Forbes-Automotive/OpenHaldex-C6/README.md

<p align="center">
  <a href="https://forbes-automotive.com/?utm_source=github&utm_medium=readme&utm_campaign=openhaldex" target="_blank">
    <picture>
      <source media="(prefers-color-scheme: dark)" srcset="/Images/FA-logo-white.png">
      <source media="(prefers-color-scheme: light)" srcset="/Images/FA-logo.png">
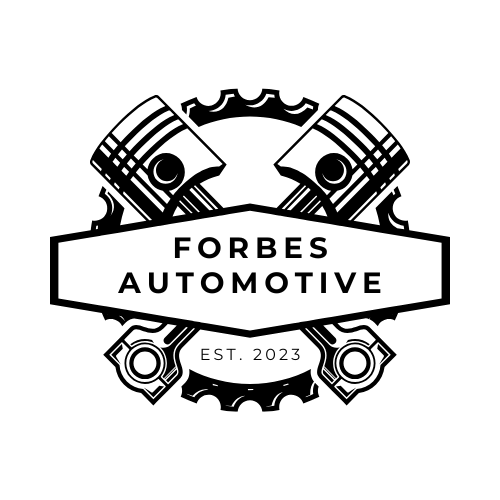
[picture p1: Images/FA-logo.png]
Forbes Automotive
      
    </picture>
  </a>
</p>

# OpenHaldex — ESP32‑C6 Haldex Controller

<p align="center">








</p>

OpenHaldex is an **open-source Haldex AWD controller** for Volkswagen and Audi Group vehicles using Haldex Generation 1, 2, 4 (PQ Chassis) and 5 (MQB) differentials, with GM, Ford and (new in V10) early **Volvo** and **SAAB** support. The full source and hardware files are published under the permissive **MIT License**, so anyone is free to use, modify, and redistribute them, and it incorporates MIT‑licensed upstream work — see [Licensing](#licensing).

Install is easy with the new harnesses for later PQ & MQB chassis:

**Lift seat -> Plug in -> Drive it**

**Performance doesn't need to be expensive or complicated!**

Starting from the codebase from A-Banging-Donk for Generation 1 differentials; OpenHaldexC6 has grown to adapt Generation 2, 4 and 5.  

The firmware runs on an **ESP32‑C6** and reads CAN bus messages from the vehicle, allowing the controller to modify or generate commands so the Haldex differential behaves exactly as you've configured.  

It can operate using OEM CAN signals or it is able to run in Standalone mode - which makes it perfect for conversions!

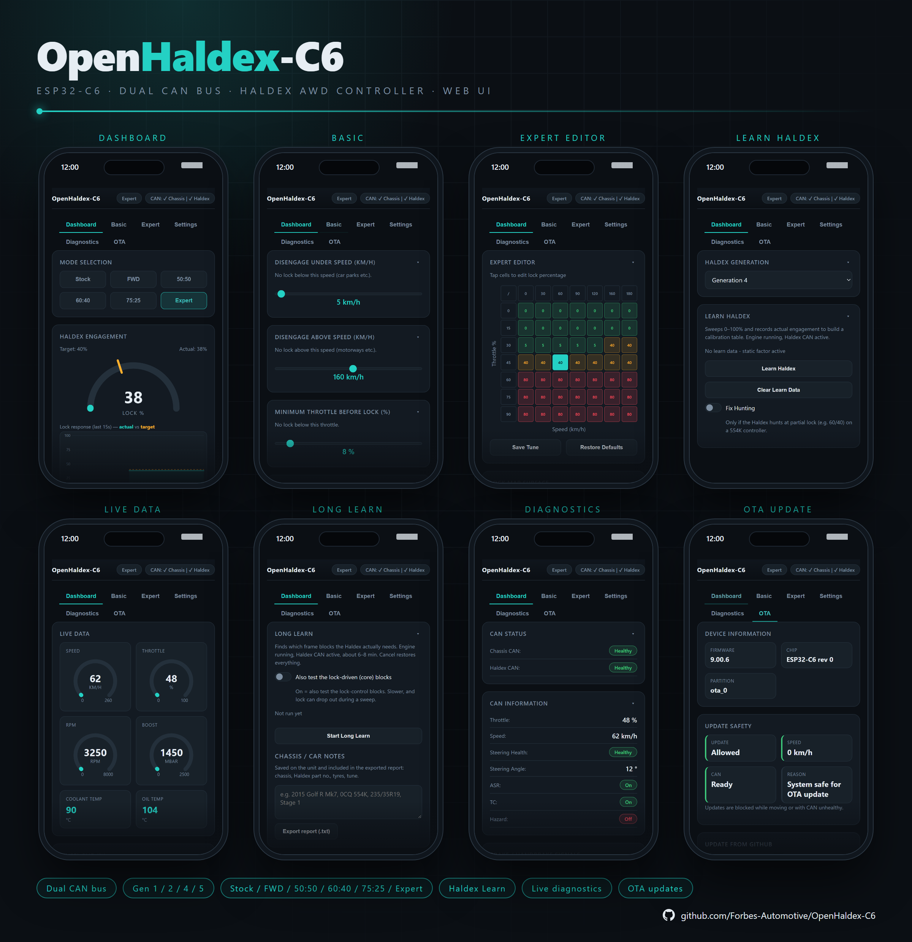
[picture p2: Images/openHaldexUI.png]
OpenHaldex-C6 Web UI — dashboard, Basic, Expert, Learn, live data, Long Learn, diagnostics and OTA


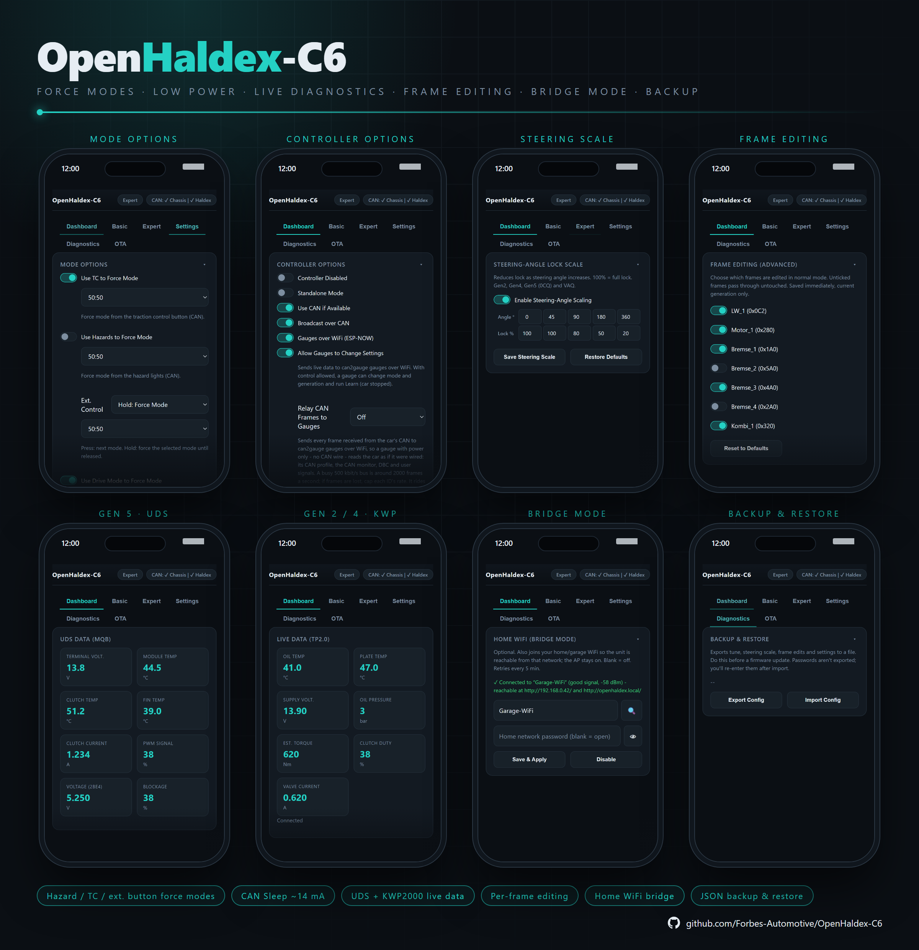
[picture p3: Images/openHaldexUI-2.png]
OpenHaldex-C6 Web UI — force modes, controller options, steering scale, frame editing, live diagnostics, bridge mode and backup


## Contents

- [Features](#features)
- [Purchase](#purchase)
- [Overview](#overview)
- [Hardware](#hardware)
- [Supported Platforms](#supported-platforms)
- [Chassis Signals (Non-VW Cars)](#chassis-signals-non-vw-cars)
- [Volvo & SAAB](#volvo--saab-early-support)
- [Modes](#modes)
- [Expert Mode](#expert-mode)
- [Installation](#installation)
- [Firmware Installation](#firmware-installation-esp-web-tools)
- [OTA Updates (Wi‑Fi)](#ota-updates-wi-fi)
- [Status Indicators](#status-indicators)
- [Low Power Mode](#low-power-mode)
- [Home WiFi (Bridge Mode)](#home-wifi-bridge-mode)
- [Backup & Restore](#backup--restore)
- [DashCAN App (Bluetooth)](#dashcan-app-bluetooth)
- [CAN Sniffing](#can-sniffing-savvycan--gvret)
- [Live Diagnostics](#live-diagnostics)
- [Fault Codes](#fault-codes)
- [Frame Editing](#frame-editing-addingremoving-can-signals)
- [PCB & Enclosure](#pcb--enclosure)
- [Acknowledgements](#acknowledgements)
- [Licensing](#licensing)
- [Disclaimer](#disclaimer)

## Features

- Two TWAI (CAN) interfaces for reading and bridging CAN traffic
- Built‑in Wi‑Fi for on‑device configuration and diagnostics
- Multiple preset modes plus customisable mode profiles
- Tune your Haldex system directly from your phone via Wi-Fi
- Configurable inputs features onboard and external mode switching options 
- Configurable outputs include two high-side drivers for handbrake and brake outputs (or PWM control for optional oil cooling!)
- SavvyCAN support via Wi‑Fi or Serial
- Wi‑Fi access point password protection, with long-press reset
- Force mode via CAN using hazard lights or TC button
- Force mode from the car's drive mode select on MQB (Comfort, Sport, Race, Individual ...), each profile set to any mode, with a **Drive Mode** card on Diagnostics (see [Drive Mode Select](#can--force-mode-drive-mode-select-mqb))
- Adjustable LED brightness
- Live Data on the dashboard: speed, throttle, RPM, boost, plus engine coolant and oil temperature on the PQ cars (Gen1 / Gen2 / Gen4 / 0AY, from the cluster's Kombi_2 frame), updating up to 10 times a second (**Live Data Refresh** under Display Options)
- Live diagnostics: UDS (Gen5) and KWP2000‑over‑TP2.0 (Gen2/Gen4) with measurement scaling confirmed against VCDS
- Read and clear the Haldex module's own fault codes from the Diagnostics page: UDS (Gen5), KWP2000 over TP2.0 (Gen2 / Gen4) and Volvo D2 (Volvo P2 / P3) (see [Fault Codes](#fault-codes))
- Selectable CAN frames — enable/disable CAN messages per Generation from the Web UI
- CAN frame relay to can2gauge gauges over WiFi (ESP-NOW): a gauge with power only, no CAN wire, reads the car as if it were wired (**Relay CAN Frames to Gauges** under Controller Options, off by default)
- Speed, throttle, RPM, brake and handbrake read from the car on Vauxhall / Opel Insignia, Ford Focus RS, Volvo P1 and Volvo P3 too, so Expert mode works on them (see [Chassis Signals](#chassis-signals-non-vw-cars))
- Volvo Gen4 (P3) proven on a real Haldex on the bench (V11.00.5): no fault codes, proportional lock, Standalone and OEM mode, mode buttons and Learn (see [Volvo P3](#volvo-gen4-p3--bench-proven-v11005))
- Early Volvo (P2 Gen2 / Gen3, P1 S40 / V50, Gen5 SPC) and SAAB 9-3 XWD standalone support, with the CAN bus switched to 250 kbit/s automatically for the pre-facelift P2 (see [Volvo & SAAB](#volvo--saab-early-support))
- Every generation checked against the Haldex units' own code (V11): the bytes that really set the lock, what the unit reports back, and its own fault bits, in OEM and Standalone
- The Haldex's own warnings (fault, limp, over-temperature, AWD lamp, temperature sensor, stored fault) on a red **Haldex Warning** card, plus Haldex Data tiles on the dashboard
- **Follow ABS** (on by default): opens the clutch while the ABS is braking, as the Haldex itself would
- Wireless (OTA) firmware and web‑UI updates over Wi‑Fi
- Bluetooth LE link to the DashCAN mobile app: live data, mode and controller on/off, driving settings and Haldex diagnostics from the phone (see [DashCAN App](#dashcan-app-bluetooth))
- Colour‑coded status indicators throughout the Web UI (green / orange / red — see [Status Indicators](#status-indicators))

OpenHaldex-C6

---

## Purchase

Assembled modules are available from Forbes Automotive if you do not wish to build one yourself:

➡ **[OpenHaldex C6 Controller – Forbes Automotive](https://forbes-automotive.com/products/openhaldex-controller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)**

---

## Overview

OpenHaldex-C6 sits between your vehicle and the OEM Haldex controller. It can operate as a passthrough (OEM behaviour), and modify messages to request different amounts of differential lock.  

This is the original source of Generation 2, 4 (including GM) and 5 logic - any forks or code copied from this project is NOT the work of Forbes Automotive and therefore we cannot support other work unless it is remains part of this project.

**Supported generations:** Gen1, Gen2, Gen3 (Volvo), Gen4 and Gen5.

> [!NOTE]
> The Volvo and SAAB generations are new in V10 and standalone only for now. See [Volvo & SAAB](#volvo--saab-early-support).

> [!WARNING]
> V11 changes the bytes that set the lock on Gen1, Gen2, Gen4, Gen5 0CQ and Gen5 0AY, so the saved learned table is cleared when you update. **Run Learn Haldex again after updating to V11.** Frame-editing masks still on the old defaults move to the new ones by themselves. 11.00.4 switches the frame edits V10 had on back on in OEM mode (Gen1, Gen2, Gen4, 0CQ and 0AY; a VAQ keeps its saved choice) and clears the learn table once more on those generations: run Learn again after updating to 11.00.4.

---

## Hardware

The PCB is based around an **ESP32‑C6 Mini** (with Wi‑Fi) and has superior protection against ESD and transient voltages.  It has a built-in fuse and uses quality automotive based components for a reliable system.

Two TWAI/CAN controllers are built into the PCB along with external IO control:

- External mode button
- On‑board RGB LED
- Brake / handbrake management (for Generation 1 systems)
  *Note: some brake/handbrake outputs may require a 10k pulldown resistor on certain platforms(!)

These two high‑side drivers for brake/handbrake could be repurposed for other functions like oil coolers!

> This platform replaces the earlier Teensy (OpenHaldex T4) design to provide wireless support and on‑device configuration.

## Supported Platforms

- Generation 1 - PQ 
- Generation 2 - PQ
- Generation 4 - PQ
- Generation 4 - GM
- Generation 4 - Ford (ongoing)
- Generation 5 - MQB (0CQ)
- Generation 5 - PQ (0AY)
- Generation 5 - MQB (VAQ)
- Generation 2 - Volvo P2, pre-facelift (early support)
- Generation 3 - Volvo P2, facelift (early support)
- Generation 3 - Volvo P1, S40 / V50 AWD (early support)
- Generation 4 - Volvo P3 (bench-proven on a real unit, Standalone + OEM)
- Generation 4 - SAAB 9-3 XWD (early support)
- Generation 5 - Volvo SPC 31380867 (early support)

### Chassis Signals (Non-VW Cars)

Expert mode, the speed / throttle limits and brake / handbrake follow need speed, throttle and brake from the car. From V10 these are read on:

| Generation | Speed | Throttle | RPM | Brake | Handbrake |
|---|---|---|---|---|---|
| Generation 4 - GM (Vauxhall / Opel) | Yes | Yes | Yes | Yes | Yes |
| Generation 4 - Ford | Yes | Yes | Yes | Yes | Yes |
| Generation 4 - Volvo (P3) | Yes | Yes (scale to confirm) | Yes | Yes | Not yet |
| Generation 4 - SAAB 9-3 XWD | Yes | Not yet | Yes | Not yet | Yes |
| Generation 2 - Volvo P2 (Pre-Facelift) | 2002 cars | 2002 cars | 2002 cars | 2002 cars | Not yet |
| Generation 3 - Volvo P2 (Facelift) | Not yet | Not yet | Not yet | Not yet | Not yet |
| Generation 3 - Volvo P1 (S40 / V50) | Yes | Yes | Yes | Yes | Yes |

The Insignia, Focus RS, 2002 Volvo P2 and Volvo P1 decodes are checked against real logs from those cars (the P1's speed scale still needs a check against the speedo). The SAAB 9-3 decode comes from a published decode of a real car. The Volvo P3 decode (V11.00.5) is read from the 29-bit frames the P3 Haldex really uses: engine rpm and the brake switch from `0x0080401E`, the pedal from `0x0062401E`, road speed from the rear wheels of `0x10004002` (1/64 km/h, cross-checked three ways), ABS braking (for **Follow ABS**) from the same frame, and the steering angle from `0x11600002` (shown on Diagnostics; its scale is an estimate, so it doesn't change the lock yet).

> [!NOTE]
> Volvo moves the P2's CAN IDs between model years, so the pre-facelift P2 decode only covers 2002 cars for now. Logs from other years (and from a facelift P2) are what's needed to add them.

## Volvo & SAAB (Early Support)

New in V10, with the Volvo SPC unit and the P2 facelift Haldex reply decode added in V11, and the Volvo P1 (S40 / V50) in V11.00.1. Pick the car under **Settings → Haldex Generation**:

<p align="center">
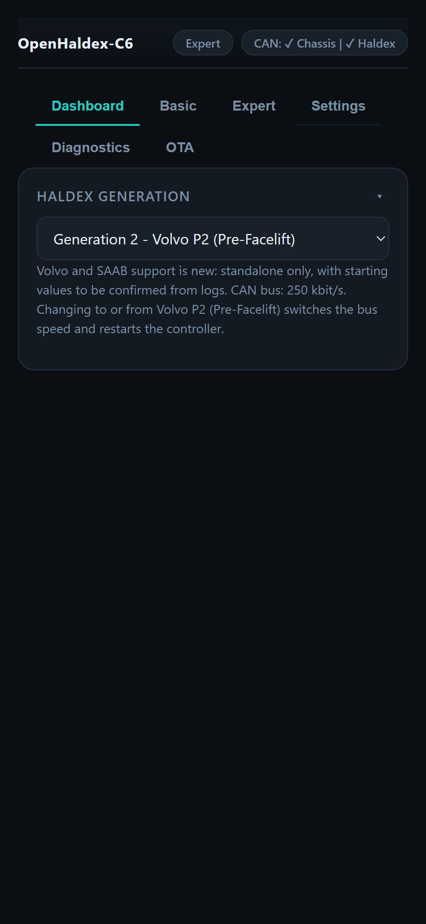
[picture p4: Images/ui-volvo-saab.png]
Settings — Haldex Generation set to Volvo P2 (Pre-Facelift), showing the 250 kbit/s CAN bus note
  
</p>

| Generation | Cars | CAN bus | Haldex reply |
|---|---|---|---|
| Generation 2 - Volvo P2 (Pre-Facelift) | S60, V70, XC70, XC90 up to the 2005 facelift | **250 kbit/s**, 29-bit IDs | `0x0120000A` |
| Generation 3 - Volvo P2 (Facelift) | S60, S60R, V70, XC70, XC90 from the facelift | 500 kbit/s, 29-bit IDs | `0x1020000A` |
| Generation 3 - Volvo P1 (S40 / V50) | S40 and V50 AWD (T5 / D5), 2004–2012 | 500 kbit/s, 29-bit IDs | `0x1960000A` |
| Generation 4 - Volvo (P3) | XC60, V70, XC70, S80 (P3) | 500 kbit/s, 29-bit IDs | `0x1020000A` |
| Generation 4 - SAAB 9-3 XWD | 9-3 XWD | 500 kbit/s | `0x210` |
| Generation 5 - Volvo (SPC 31380867) | Cars with the Volvo Gen5 SPC unit | 500 kbit/s, 11-bit IDs | `0x126` |

- **Standalone only, except the P3.** The controller sends the frames the Haldex needs, including Volvo's 100 ms network heartbeat and SAAB's rolling counters. It also puts your lock request into the bytes that carry it. In OEM (inline) mode, frames pass through untouched - apart from the Volvo P3, which has full OEM support (below).
- **The bus speed follows the generation.** Choosing Volvo P2 (Pre-Facelift), or moving away from it, saves the setting and restarts the controller a couple of seconds later, with both CAN buses at the new speed. Without 250 kbit/s a pre-facelift P2 Haldex never answers, so it shows no Haldex health at all.
- **Starting values, not finished decodes.** The frame list and lock bytes are a starting point. The meaning of most bytes still needs confirming on real cars, and the Haldex status is shown as raw 0–100 % until logs give its true scaling. SAAB also reports a Haldex temperature.
- **Decoded from the Haldex's own code (V11).** On the P2 facelift, the reply's byte 6 is the measured clutch value and byte 7 carries the fault / limp and missing-input bits, so the Haldex Warning card works there. The SPC unit's reply gives the clutch torque it's delivering and a fault status. The full-lock value of both still needs a bench check.
- **Volvo P1 (S40 / V50 AWD, V11.00.1).** Built from logs of a 2005 V50 T5 AWD. The P1 runs the same bus as the P2 facelift but uses none of its CAN IDs, so pick the P1 entry, not a P2 one.
  - Standalone sends every frame the car puts on its high-speed bus (22 of them), each one listed under Frame Editing. Untick a frame and the **car's own** frame with that ID goes through to the Haldex instead. Untick them all and the Haldex sees the real car; tick them back one at a time on a drive to find any frame it won't accept.
  - The logs show the P1 module follows engine torque almost one-for-one, goes to full lock on big front wheelspin, and never locks while stopped. The **Volvo P1 Standalone** card (Settings, shown for the P1) sets how your lock request is shown to it:
    - **Lock Source**: Engine torque (the default, which also raises the pedal), Wheel slip (front wheels faster than the rears), or both together.
    - **Road Speed** and **Gear**: the rpm sent is the road speed in that gear (1st to 3rd, ratios measured from the V50 logs), so rpm and speed always match a real gear.
    - **Torque at 100 %** and **Front Wheel Slip at 100 %**, with a Reset to Defaults button.
    - A live line shows the lock being asked for, what's being sent, and the module's engagement.
  - Switching DSTC off counts as the TC button, so **Use TC to Force Mode** (Mode Options) can force a mode while DSTC is off. This works in OEM mode, and in Standalone with the car connected.
  - The mode buttons, Expert and **Learn Haldex** drive it just like the other generations. Learn waits a little longer at each step on the P1, because its engagement trails the torque by up to 0.4 s.

<p align="center">
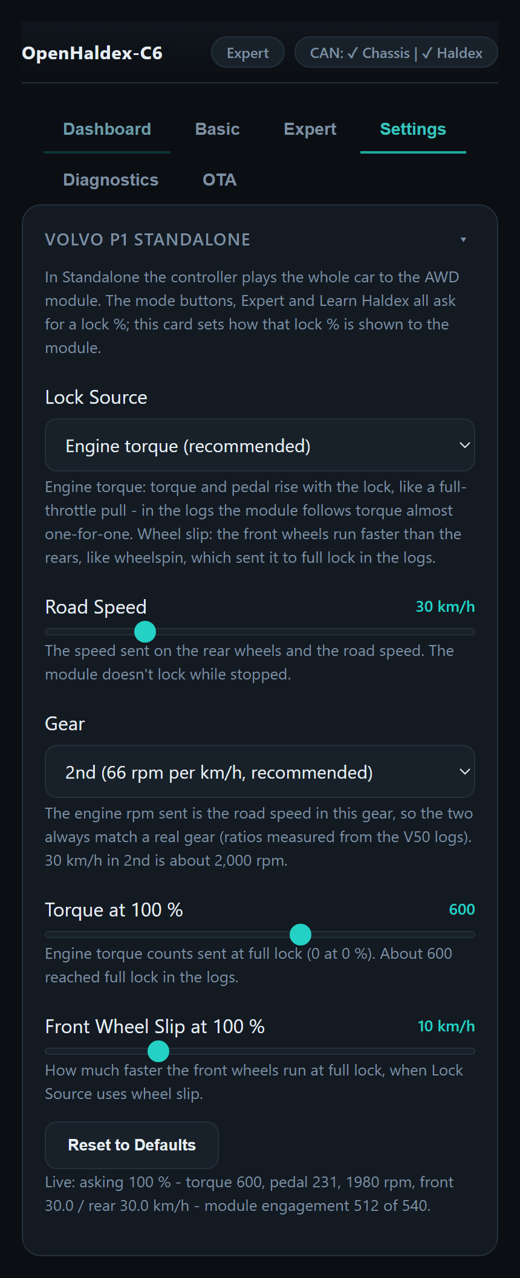
[picture p5: Images/ui-volvo-p1.png]
Settings — Volvo P1 Standalone card: Lock Source, Road Speed, Gear, Torque at 100 %, Front Wheel Slip at 100 % and the live line
  
</p>

*Settings → **Volvo P1 Standalone**: here asking for 100 %, sent as 600 torque and full pedal at a steady 30 km/h in 2nd (1980 rpm). The live line is a mock-up: on the car the module hasn't answered our lock request yet (see below).*
  - **Not working yet (first car test, 25 Oct 2026):** in Standalone the module stays awake but ignores the lock request. The frame bisect and the gear-matched rpm above are the tools for finding out why. Findings: `documents/VOLVO_P1_FINDINGS_2026-10-25.md`.
  - The Haldex's engagement (`0x1960000A`) is shown as 0–100 %, with full lock at the highest value seen in the logs.
  - OEM mode passes everything through untouched for now, so Stock and the engagement readout work. Editing the car's frames for 50:50, 60:40 and the other modes comes next; until then Learn needs Standalone on the P1.
  - The decode and the logs are in `documents/vehicle-logs/gen3/`.
- **How to help.** Log the car with [SavvyCAN](#can-sniffing-savvycan--gvret), and nudge individual bytes live with the serial lab `OVR <id> <byte> <value>` command (it takes 29-bit Volvo IDs). Logs from a car with the Haldex fitted are what turn these into decoded frames.

### Volvo Gen4 (P3) — bench-proven (V11.00.5)

Worked out on a real P3 Haldex on the bench (hardware `31219215 AA`, software `31219186 AE`) on 7 Nov 2026. Full notes: `documents/VOLVO_GEN4_BENCH_2026-11-07.md`; every CAN frame is decoded, with its source, in `include/OpenHaldexC6_canID.h`.

- **It speaks 29-bit, like the P2 facelift.** The P3 unit uses the same message set as the P2 facelift Haldex and replies on `0x1020000A`. The 11-bit frames earlier versions sent for generation 43 got no answer at all.
- **No fault codes, no limp.** The one frame that matters most is the CEM's configuration page (`0x10A2407C`, page `0x14`). Without it the unit stores fault `0x0015` about 32 s after power-up and goes into limp. The controller sends it once a second.
- **What moves the clutch.** Only three inputs, all measured on the bench:

  | Frame | What it is | Effect on lock |
  |---|---|---|
  | `0x0080401E` | Engine rpm (+ brake switch) | Under ~300 rpm the pump stays off: **0 %** |
  | `0x10004002` | The four wheel speeds (bytes 0-3 rear, 4-7 front) | All four at 0 = car stood still = full pull-away pre-lock: **100 %**. Fronts faster than rears = slip = **1-99 %** |
  | `0x0062401E` | Engine torque and pedal (+ brake switch) | Positive torque / pedal *reduces* the lock, so it is held at fixed values |

  The brake switch in `0x0080401E` cuts the lock to 0 while moving, so it is cleared while a lock is wanted (as on the VAG units); **Follow Brake** puts the real brake state back.
- **Standalone** sends only those three, the network heartbeat and the configuration page - the other seven frames of the P2 set made no fault and no lock change when switched off, cold start included.
- **OEM mode** passes every car frame through and edits only the three lock inputs, so the mode buttons (FWD / 50:50 / 60:40 / 75:25), Expert and **Learn Haldex** work just like on the VAG cars. Stock is untouched passthrough.
- **Reply.** Byte 6 of `0x1020000A` is the measured clutch pressure (0 open, `0xFF` full lock), shown as engagement. Byte 7 bit 0 is the fault / limp flag, shown on the Haldex Warning card.
- **Before Learn**, lock requests of 25 / 50 / 75 / 100 % give about 37 / 49 / 74 / 100 % - run **Learn Haldex** once to straighten the curve.
- **Fault codes** can be read and cleared from the Diagnostics page (Volvo D2, module `0x1A`) - see [Fault Codes](#fault-codes).
- **ABS:** the rear-left qualifier bits of `0x10004002` make the unit open its clutch (ABS / stability control braking). With **Follow ABS** on (the default) the car's flag reaches the Haldex in OEM mode; turn it off and the lock overrules the ABS.
- **Not done yet:** the DSTC off button (the Haldex doesn't use it, so it needs a car log with the button pressed), confirming which ABS value is ABS and which is DSTC, the steering-angle scale, and a car test.

---

## Modes

The controller provides several preset modes along with a fully customisable 'Expert' mode':

| Mode | Behaviour | LED Colour |
|-----|---|---|
| Stock | OEM behaviour | Red |
| FWD | Zero lock | Green | 
| 7525 | 25% lock | Cyan |
| 6040 | 40% lock | Magenta |
| 5050 | 100% lock | Blue |
| Expert | User‑defined lock | White |

<p align="center">
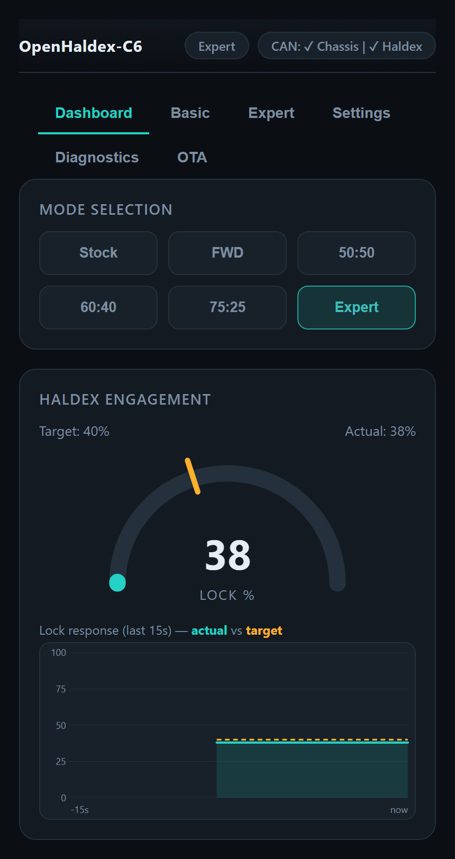
[picture p6: Images/ui-dashboard.png]
Dashboard — mode selection and Haldex engagement gauge
  
  &nbsp;&nbsp;
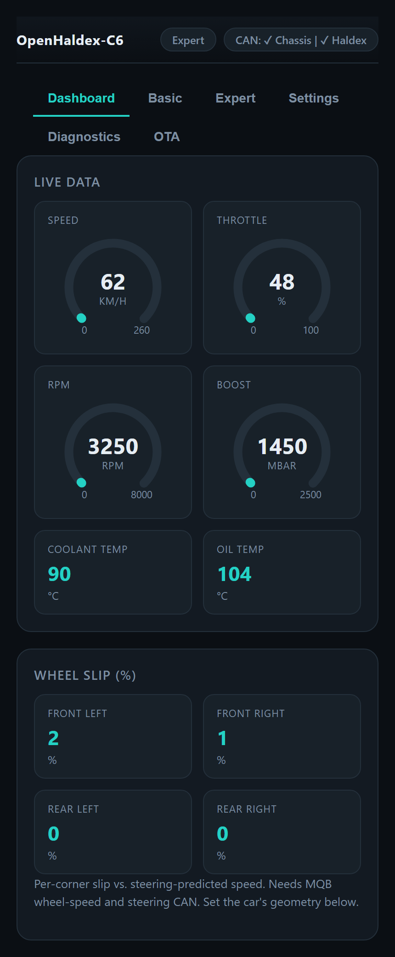
[picture p7: Images/ui-live-data.png]
Dashboard — live speed, throttle, RPM, boost, coolant and oil temperature, and per-wheel slip
  
</p>

*Dashboard: pick a mode, watch the engagement gauge follow the request (with the last 15 s of actual vs target underneath), and keep an eye on the live data and wheel slip further down the page.*

The **Live Data** card shows speed, throttle, RPM and boost, and on the PQ cars (Gen1, Gen2, Gen4 and 0AY) the engine **Coolant Temp** and **Oil Temp** read from the instrument cluster's Kombi_2 frame; cars that don't send it show `--`. It normally updates twice a second like the rest of the page. **Live Data Refresh** (Display Options, saved in the browser) speeds up just the Live Data tiles, the engagement gauge and the lock graph to 4, 5 or 10 times a second; step back down if the page gets sluggish on a busy phone.

The **Basic** tab holds the simple guards that apply to every mode — disengage below or above a speed, a minimum throttle before any lock is applied, and how quickly lock is released. They cut lock in **every** mode, force triggers included, so when one of them is holding lock at 0% the Haldex Engagement card says which one and what it's set to (e.g. *"Lock is being held at 0% because speed is below "Disengage Under Speed" (20 km/h)"*). Set that limit to 0 to turn the cut-off off:

<p align="center">
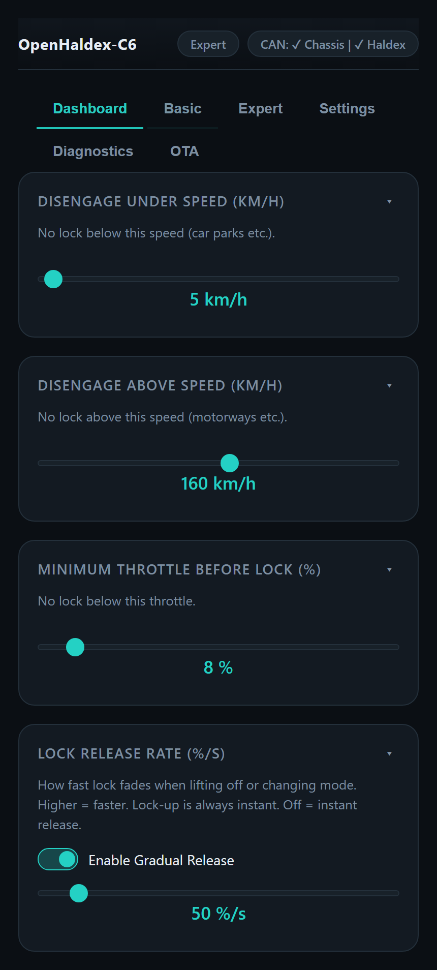
[picture p8: Images/ui-basic.png]
Basic tab — disengage speeds, minimum throttle and lock release rate
  
</p>

---

## Expert Mode

Expert mode allows lock targets to be configured based on **speed and throttle setpoints** using a table inside the Web UI. This is true **full control** over your Haldex system. No guesswork. You tune it and it'll do exactly what you want it to do, every time.  It requires OEM CAN messages to be present for throttle/speed inputs.

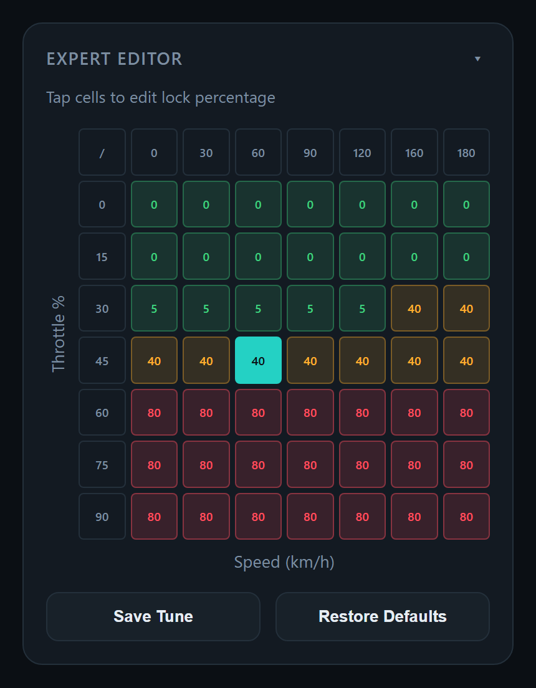
[picture p9: Images/expertmode.png]
ExpertMode


*Expert mode grid configuration interface within the OpenHaldex-C6 UI.*

The rest of the **Expert** tab draws the same table as a lock-map surface, and adds an optional **Steering-Angle Lock Scale** — a five-point curve that trims the commanded lock as steering-wheel angle increases (full lock straight ahead, FWD bias in tight turns). It applies to Gen2, Gen4 and Gen5 (0CQ/VAQ) and to every mode, not just Expert:

<p align="center">
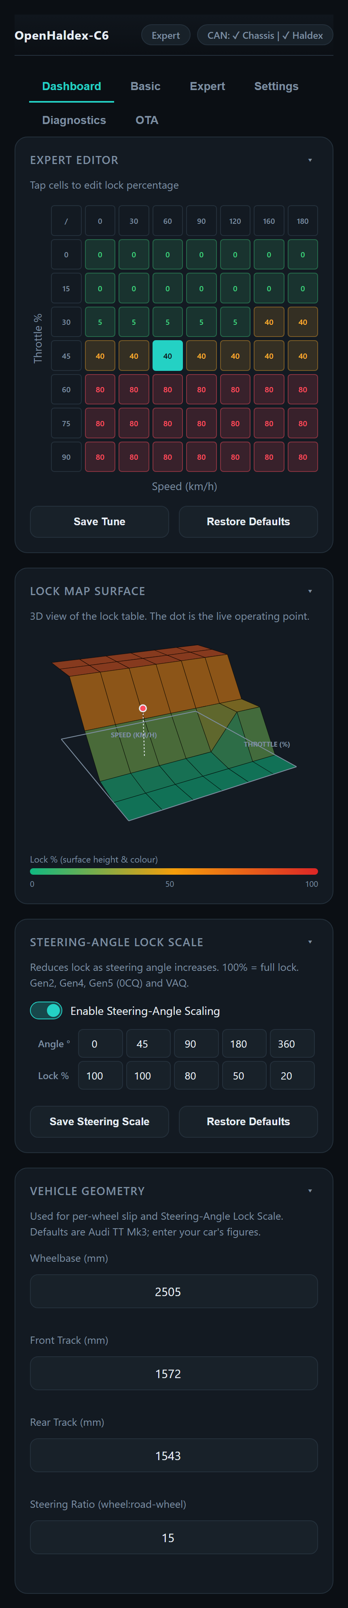
[picture p10: Images/ui-expert.png]
Expert tab — editor grid, lock map surface and steering-angle lock scale
  
  &nbsp;&nbsp;
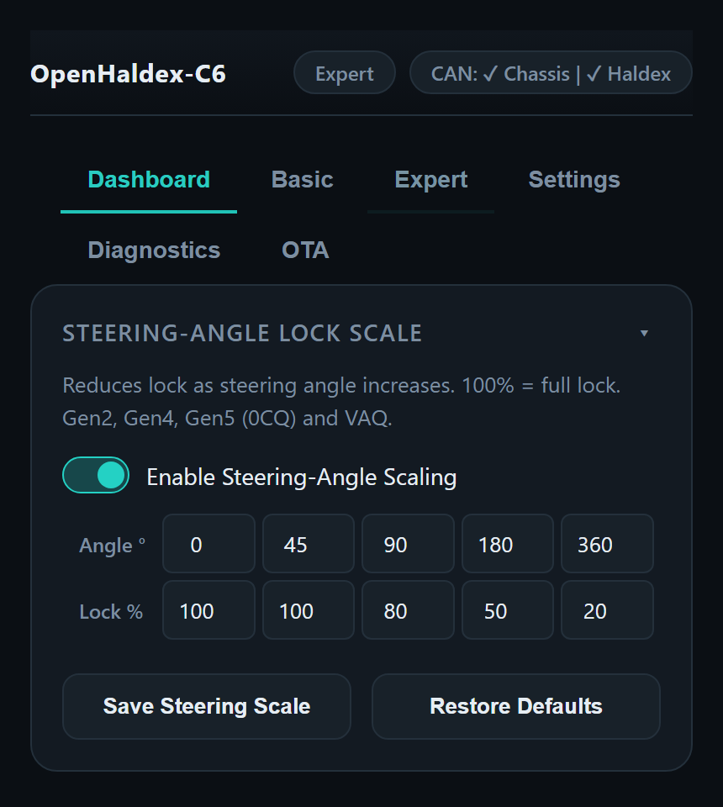
[picture p11: Images/ui-steering-scale.png]
Expert tab — steering-angle lock scale curve
  
</p>

---

## Haldex Learning

Allow the controller to learn *your* Haldex by replacing the original methodology of approximating a lock percentage by cycling through all of the available lock percentages.  

Use the 'Learn Haldex' in the Settings page and within one minute the controller will learn how to get EXACTLY the lock percentage you request.  No more approximations, just exact values.

<p align="center">
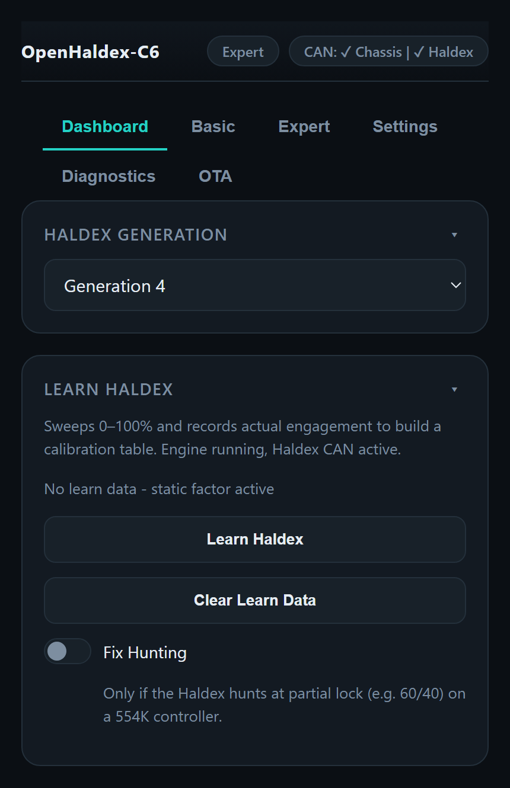
[picture p12: Images/ui-settings.png]
Settings — Haldex generation and the Learn Haldex card with Fix Hunting
  
</p>

*Settings: pick the Haldex generation, then run **Learn Haldex**. The card reports whether a learned table is active and carries the Gen5 **Fix Hunting** toggle described below.*

### Long Learn (which static blocks are needed)

The **lock-driven** blocks (the frames whose payload follows the lock target, e.g. Motor_11 / Motor_12 / ESP_14 / ESP_19 on Gen5) always have to be edited to have control, so they are always sent. Everything else is a **static** payload. **Long Learn** on the Settings page finds out which of those the Haldex actually needs:

1. **Reference** — every block for the generation is switched **on** (as standalone sends the bus) and a full 0–100% sweep is run on the unit's own settings.
2. **BPK Adjust** *(Gen5 only, only if that sweep hunts — not smooth — or falls short)* — **Fix Hunting** (BPK packing) is switched on and kept only if a full sweep is genuinely better; if it is still short on level, the torque ceiling (**Lock Calibration**, `bpkCeilingNm`) is walked up to the lowest value that reaches 100%. Whatever wins is **kept** when the run completes.
3. **Prove it** — the all-on sweep on the settled settings must be smooth (it is re-swept if BPK moved the ceiling). Then two quick reads at **20 / 40 / 70 / 100%** with everything on: their average is the reference, and their spread is the **noise** floor every block is judged against (minimum 4%). If all-on is not a smooth 100%, or the two reads differ by more than 10% at any point, the run stops — there is nothing trustworthy to compare blocks with.
4. **Testing blocks** — each static block is switched off **on its own** (everything else on), read at the same four points (releasing to 0% before each one, since a held lock doesn't re-evaluate cleanly), and switched back on. A change beyond the noise floor at any point = **needed** (or **affects (higher without)** if it read higher — still kept on). No change = **no effect**. Spreading the points over the ramp means a block that only matters at part lock isn't missed on a clean 100%. Tick *Also test the lock-driven (core) blocks* to test those too.
5. **Confirmation** — every "no effect" block off together, full sweep compared CF-by-CF with the step-3 curve. If it still matches, that becomes the final set and stored learn table. If not (a step between the two test points, or two frames covering for each other) every block is left on, the reference table is stored and the run is flagged as an **interaction**.

On the bench (standalone) "off" means the frame is not sent at all; in the car (normal mode) it means the car's own frame passes through untouched. A full sweep takes about a minute and a four-point block read 6–12 seconds, so a Gen5 run is roughly 6–8 minutes. The tracker shows the phase, sweep count, the block under test, Fix Hunting / torque ceiling, the reference score with its noise and threshold, and the live Sent/Returned bars; each tested block shows its worst deviation. Cancelling, or a failed proof, restores the blocks, floor, torque ceiling, Fix Hunting toggle and learn table that were in place before the run.

Below the tracker, a **Chassis / car notes** box (saved on the unit) and **Export report (.txt)** produce a plain-text record of the car, calibration values, the recommended block set (as a checklist plus the raw mask), the full sweep log and the stored learn table — handy for sharing a known-good layout for a given chassis.

<p align="center">
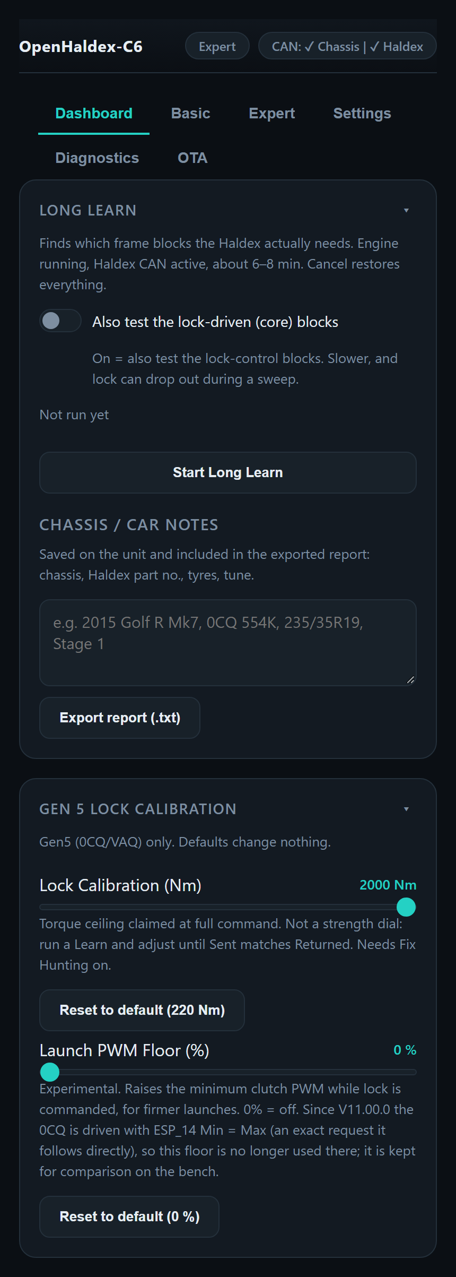
[picture p13: Images/ui-long-learn.png]
Settings — Long Learn card with notes and report export, and the Gen 5 Lock Calibration card
  
</p>

*Settings: the Long Learn card (with the core-blocks option, notes and report export) and, beneath it, the **Gen 5 Lock Calibration** card — the torque ceiling (`Lock Calibration`) and `Launch PWM Floor` that Long Learn adjusts.*

### Gen5 'Fix Hunting'

Certain Generation 5 controllers — specifically those running the **554K** variant — use a different torque model to calculate the lock request. On these units, the standard learning process will not produce accurate results. Use the **Fix Hunt** option in the Settings page to ensure the correct torque model is used.  

---

## Changing Modes

Modes can be changed using multiple interfaces:

**On‑board button**

Press the `Mode` button to cycle through modes.

**Wi‑Fi**

Use the Web UI at:

```
192.168.1.1 or openhaldex.local
```

**CAN**

See [CAN Broadcast / Change Mode](#can-broadcast--change-mode) for the required **Broadcast over CAN** setting, CAN IDs and mode byte.

**CAN — Force Mode (Hazards / TC Button)**

Two optional force mode triggers are available via. CAN signals already present on the bus:

- **Hazard lights** — activating the hazard switch will trigger a force mode command
- **TC button** — pressing the traction control button can also trigger force mode

Both are optional and can be enabled in the Settings page. They allow mode changes from OEM controls without any additional wiring.

<p align="center">
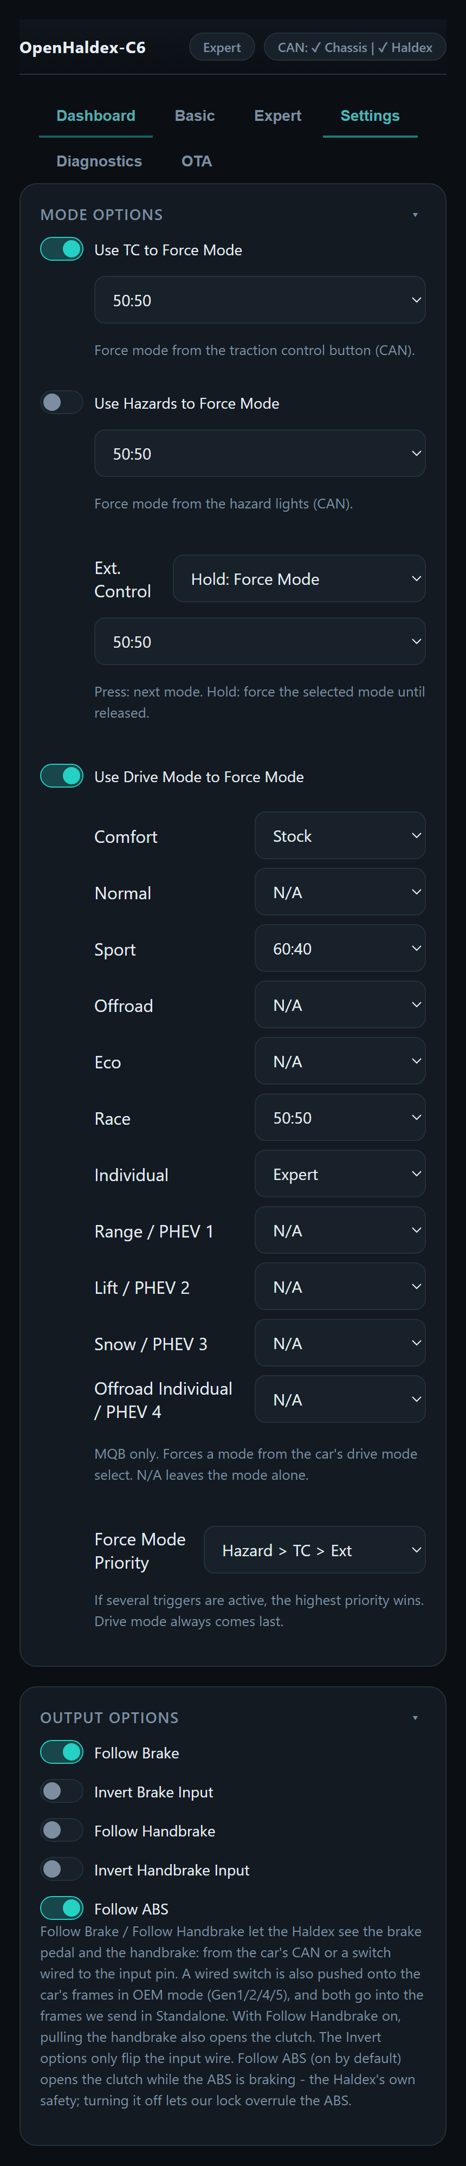
[picture p14: Images/ui-mode-options.png]
Settings — Mode Options (TC / hazard / external button / drive mode force modes and their priority) and Output Options (brake and handbrake follow)
  
</p>

*Settings → **Mode Options**: each force-mode trigger has its own target mode, the external button can either advance or hold-to-force, the drive mode select has a mode per profile, and a priority order settles what happens when several triggers are active at once. **Output Options** underneath sets whether the Haldex follows the brake and handbrake (from the car's CAN or a switch wired to the input pin), and **Follow ABS** (on by default) opens the clutch while the ABS is braking. With Follow Handbrake on, pulling the handbrake also opens the clutch. The Invert options only flip the input wire, never the car's own CAN bit.*

### CAN — Force Mode (Drive Mode Select, MQB)

On MQB cars (Gen5 `0CQ`, Gen5 `0AY` on MQB and the VAQ), the car's own drive mode select can force a mode. Turn on **Use Drive Mode to Force Mode** under Settings → **Mode Options** and pick a mode for each drive profile. **N/A** leaves the mode alone. The defaults are:

| Drive profile | OpenHaldex mode |
|---|---|
| Comfort | Stock |
| Sport | 60:40 |
| Race | 50:50 |
| Individual | Expert |
| Normal, Offroad, Eco, Snow and the rest | N/A |

How it works:

- The gateway sends the selected profile once a second in **Charisma_07** (`0x3E8`, byte 1 bits 0–3). If a car doesn't send that frame on the Haldex's bus, the engine's requested mode in **Charisma_01** (`0x385`, byte 2) is used instead. That one can't tell Individual apart: it shows the engine setting chosen inside Individual.
- The TC button, hazards and external button still win over it. If no Charisma frame arrives for 3 seconds, the drive mode stops forcing anything.
- The header banner shows a drive mode force the same way as the others, e.g. `Expert (Sport>60:40)`.
- **Diagnostics → Drive Mode** shows the profile the car is in, which frame it was read from, the mode the car's gateway asks the Haldex and VAQ for, what the Haldex reports back (mode and status), and what is being forced.

Profile and mode numbers come from the MQB K-matrix and the [jilleb/MQB-FPA](https://github.com/jilleb/MQB-FPA) research into the gateway's drive profile data. Our own MQB logs read Individual (7) from Charisma_07.

> [!NOTE]
> Reading the drive profile has been checked against our own MQB logs. Forcing modes from it has not been driven on a car yet.

<p align="center">
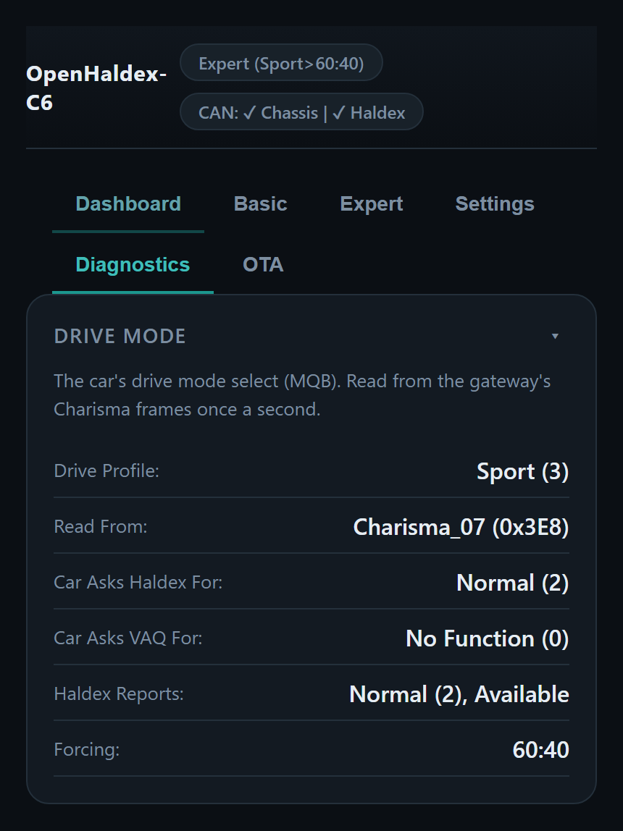
[picture p15: Images/ui-drive-mode.png]
Diagnostics — Drive Mode card: drive profile Sport read from Charisma_07, the car asking the Haldex for Normal, the Haldex reporting Normal / Available, forcing 60:40
  
</p>

*Diagnostics → **Drive Mode**: the car is in Sport (read from Charisma_07), its gateway asks the Haldex for Normal, the Haldex reports Normal / Available, and Sport is forcing 60:40.*

---

## CAN Broadcast / Change Mode

The same **Broadcast over CAN** setting enables both:

- External mode-change commands received by the controller on `0x6A0`
- OpenHaldex state broadcast from the controller on `0x6B0`

> [!NOTE]
> Enabling these features will broadcast NEW CAN IDs the system might already look for(!).  Caution should be exercised when using this feature(!). 

### Change Mode Request

**Broadcast over CAN must be enabled** in Settings, otherwise the controller will ignore the mode-change frame.

Send a standard 11-bit CAN frame to `0x6A0`. Put the required mode value in **Byte 0 / data[0]**. If sending an 8-byte frame, set unused bytes to `0x00`.

| CAN ID | Byte | Value | Mode |
|----|----|----|----|
| `0x6A0` | `0` / `data[0]` | `0x01` | Stock |
| `0x6A0` | `0` / `data[0]` | `0x02` | FWD |
| `0x6A0` | `0` / `data[0]` | `0x03` | 50:50 |
| `0x6A0` | `0` / `data[0]` | `0x04` | 60:40 |
| `0x6A0` | `0` / `data[0]` | `0x05` | 75:25 |
| `0x6A0` | `0` / `data[0]` | `0x06` | Expert |

### Broadcasted State

Default CAN ID:

```
0x6B0
```
The module broadcasts its current state on the CAN bus.  This can be used by aftermarket ECUs or FIS displays to show current status

```
data[0] = reserved 
data[1] = standalone flags (bitmask for Gen1/Gen2/Gen4/Gen5)
data[2] = processed haldex engagement (requested by firmware)
data[3] = lock target percent (actual lock, returned by differential)
data[4] = vehicle speed (kmh)
data[5] = mode_override_flag (legacy)
data[6] = current_mode_number (0...5)
data[7] = driver's pedal value (percentage: 0...100%)
```

---

## Wi‑Fi Setup

1. Connect to the access point **OpenHaldex‑C6** (open by default).
2. Open a browser and navigate to

```
192.168.1.1 or openhaldex.local
```

3. Access the Web UI

### Connecting from a phone

**Use your phone's Wi‑Fi settings — not its Personal Hotspot / hotspot feature.** The controller is the access point: it broadcasts its own Wi‑Fi network (**OpenHaldex‑C6** by default), the same way a home router does. Your phone just joins that network like any other:

1. Phone **Settings → Wi‑Fi** → select **OpenHaldex‑C6** and connect (open network by default, no password).
2. Browse to `192.168.1.1` or `openhaldex.local`.

Do **not** turn on your phone's own Hotspot/Personal Hotspot for this — that shares *your* phone's data with other devices, which is the opposite of what's needed here and won't let the phone reach the controller.

> [!NOTE]
> The controller has no internet access and doesn't need any. Your phone will show *"Wi‑Fi has no internet access"* while connected — that's expected; dismiss it. If the phone keeps dropping the network (some Android versions do this to a Wi‑Fi with no internet), tap the warning and choose **"Stay connected"**. 

If you get stuck mid-way (e.g. the phone auto‑connects to OpenHaldex‑C6 in the background and you didn't mean to), just forget the network or reconnect — the controller keeps running normally whether or not anything is connected to it.

From the **Diagnostics** page you can:

- **Change the WiFi Name (SSID)** — set any 1–32 character printable name (e.g. `MyHaldex`, `MK7-R`). The AP restarts immediately on save.
- **Set / change the WiFi Password** — WPA2, minimum 8 characters. Leave blank for an open network.

If you are locked out or forget your password, **long-pressing the `Mode` button** will clear the WiFi password and restore the open AP. The SSID is preserved (use **Reset to Default** in the UI if you want to revert the name to `OpenHaldex-C6`).

<p align="center">
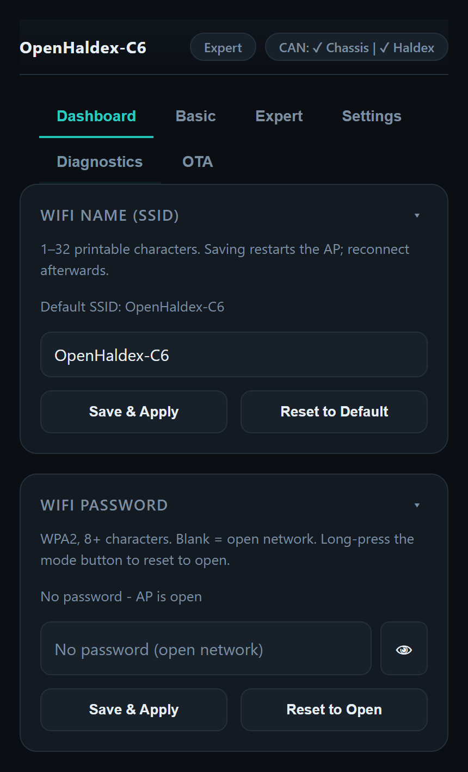
[picture p16: Images/ui-wifi.png]
Diagnostics — WiFi Name (SSID) and WiFi Password cards
  
</p>

*Diagnostics: rename the access point and set or clear its WPA2 password.*

<p align="center">
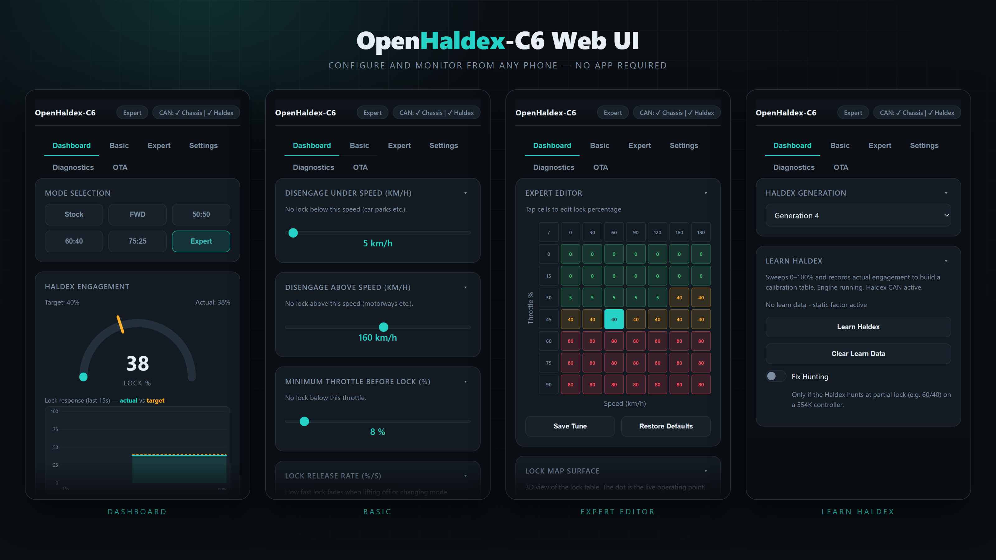
[picture p17: Images/UIDemo.png]
OpenHaldex C6 Web UI
  
</p>

If the Wi‑Fi interface becomes unresponsive:

- Long‑press the `Mode` button to clear the WiFi password and restart the AP to an open state.

> The Web UI is built on Forbes Automotive's shared dark theme (the same look used across the Can2Cluster, SpeedPulser, SpeedPulserPro, can2rpm, MQB Steering Wheel Controller and AirLift Controller firmware), so the interface and status conventions stay consistent across the whole product line. Current firmware version: **11.00.5** (beta: Volvo Gen4 P3 rewritten from a real unit on the bench - Standalone and OEM mode, no fault codes, proportional lock - plus Read / Clear Fault Codes on the Diagnostics page for the UDS, KWP2000 / TP2.0 and Volvo D2 generations; 11.00.4: coolant and oil temperature on the Live Data card, faster Live Data refresh, OEM-mode lock back to V10 behaviour on Gen1, Gen2, Gen4, 0CQ and 0AY, OTA from 11.00.2 and older fixed), shown in the UI footer and at `/ota/info`.

---

## Low Power Mode

OpenHaldex C6 is designed to live on a **permanent +12 V** feed without flattening your battery. With Low Power Mode configured correctly the controller draws approximately:

| State | Current |
|---|---|
| Sleeping (car off, WiFi off, CAN quiet) | **~14 mA** |
| Awake (CAN activity detected *or* WiFi client connected) | **~50 mA** |

There are three layers of power saving. Each layer builds on the previous one and all are configured from the **Settings** page.

---

### Layer 1 — Idle AP Shutdown *(on with CAN Sleep, which is on by default)*

After **5 minutes** with no WiFi clients and the bus below the wake threshold, the controller shuts down the WiFi AP, Bluetooth and the LED. Turning **CAN Sleep** off keeps them up permanently.

When the frame rate rises above the threshold again (car unlocked or started), WiFi comes back on its own.

---

### Layer 2 — CAN Sleep *(optional)*

Enable the **CAN Sleep** toggle in Settings. When active:

- The ESP32-C6 CPU enters **light sleep** whenever FreeRTOS is idle, cutting CPU power consumption significantly.
- The TWAI (CAN) peripheral powers down during sleep but **preserves its registers and receive queue** across cycles, so no messages are lost on wake-up.
- The CAN transceiver chips remain powered and continue listening on the bus, so the first incoming frame wakes the controller instantly.

Light sleep and the CPU clock floor are set at boot, so toggling CAN Sleep takes full effect after a restart.

This mode gives the majority of power savings for most installs and is the recommended starting point.

---

### Layer 3 — CAN Sleep (Aggressive) *(optional, builds on Layer 2)*

Enable **CAN Sleep (Aggressive)** in Settings — everything from Layer 2 remains active, plus:

- **The CAN transceiver chips are completely shut down** (standby pin asserted). This eliminates the ~10 mA standby draw per transceiver.
- The CPU minimum clock drops to **10 MHz**.
- WiFi AP transmit power is trimmed to reduce active-client current.
- Wake is **interrupt-driven**: a GPIO ISR on each CAN_RX line fires on the first bus edge and re-enables the transceivers within microseconds. 

Use Aggressive mode when the car sits unused for days at a time and you want the absolute lowest standby current (~14 mA).

---

### How to set it up

Every car idles its CAN bus at a different rate, so the wake threshold has to sit just above your car's parked rate.

**Gen5: automatic**

Selecting a Gen5 generation asks *Enable CAN sleep and set it up automatically?* (and asks again whenever you switch back to Gen5). Say yes, then just use the car. The next time it is left with no phone connected, the controller:

1. switches on CAN Sleep and CAN Sleep (Aggressive),
2. waits until the car is parked: speed 0, engine off and ignition off (`ZAS_Kl_15` in Klemmen_Status_01, `0x3C0`),
3. averages the chassis frame rate for **15 minutes**, restarting if a phone connects, the ignition comes on or the car moves,
4. sets **LP Wake Threshold** to that average **+ 300 fps** and saves it.

It runs once. Sleep stays off until it has finished, so the controller never sleeps on a wrong threshold. The Controller Options card shows *armed* or the measured average.

**Manual (any generation)**

**Step 1 — Measure your Sleeping CAN rate**

1. Park and lock the car. Wait 15 minutes or until the Chassis bus goes fully quiet.
2. Stay connected to the OpenHaldex WiFi AP — the controller will remain awake while a client is connected.
3. Open the Web UI → **Settings** and watch the **Chassis fps** and **Haldex fps** counters.
4. Note the highest reading you see while the car is asleep. Some cars go fully quiet; others keep a gateway heartbeat of several hundred fps.

**Step 2 — Set the wake threshold**

5. Set the **LP Wake Threshold (fps)** slider a few hundred above the parked reading, e.g. parked at 800 fps → **1100** (the default).

**Step 3 — Enable Sleep and Disconnect**

6. Enable **CAN Sleep** (and optionally **CAN Sleep (Aggressive)**) in Settings.
7. **Disconnect from the WiFi AP** (close the browser / forget the network).

The controller will now sleep, drawing ~14 mA, and **wake automatically whenever the CAN frame rate rises above the threshold** — i.e. when you unlock or start the car.  The LED, CAN chips and CPU are all off/reduced.

<p align="center">
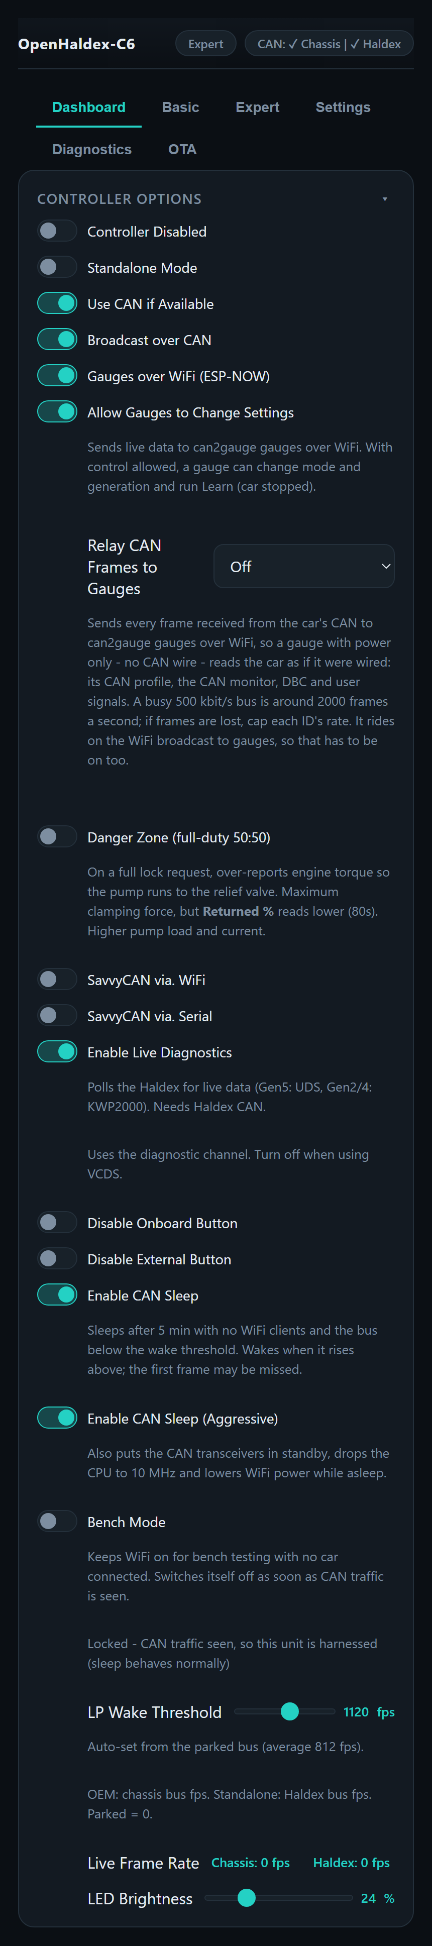
[picture p18: Images/ui-controller-options.png]
Settings — Controller Options card: CAN Sleep, CAN Sleep (Aggressive), Bench Mode, LP Wake Threshold with the live Chassis / Haldex frame rate, plus Broadcast over CAN, SavvyCAN and Live Diagnostics toggles
  
</p>

*Settings → **Controller Options**: the two CAN Sleep toggles, Bench Mode, the **LP Wake Threshold** slider (here set by the Gen5 auto-setup) and the live **Chassis / Haldex fps** readout, alongside Broadcast over CAN, the SavvyCAN outputs, Live Diagnostics and LED brightness.*

> [!NOTE]
> **Standalone mode:** with no chassis bus, the Haldex ECU itself sleeps fully, so the slider is ignored: the module wakes at a fixed 50 fps of Haldex-bus traffic.

> [!NOTE]
> **Switched-ignition installs:** if the module is already powered off with the ignition, Low Power Mode saves little and is optional.  

### Bench Mode

The board can't tell the difference between *harnessed to a car that's asleep* and *no harness at all* — both look like zero CAN traffic — so on the bench, with CAN Sleep on, the WiFi drops after five minutes mid-session. **Bench Mode** (Settings, under CAN Sleep) holds the WiFi up regardless.

It's safe to leave on by accident: the moment either bus shows real traffic in a power cycle, Bench Mode stops applying and normal sleep resumes, so it can't weaken the parked-car battery protection once the unit is actually installed. The web UI also greys the toggle out while CAN is detected, so it can't be switched on while harnessed to a live car in the first place.

---

## Home WiFi (Bridge Mode)

Optionally the controller can **also** join a home or garage WiFi network as a client (`WIFI_AP_STA`), so it's reachable at `openhaldex.local` — or its LAN address, shown on the card — from a phone or laptop that's already on that network, without switching WiFi to **OpenHaldex‑C6**. The controller's own access point keeps running either way; leave the field blank and nothing changes.

Set it up on the **Diagnostics** tab under **Home WiFi (Bridge Mode)** (the same card is repeated on the **OTA** tab, because this is also how the phone gets internet for [Check for updates](#doing-it-from-the-ota-page)): pick the network from the scan (or type a hidden one), enter its password, **Save & Apply**. The card then shows connection state and signal strength.

<p align="center">
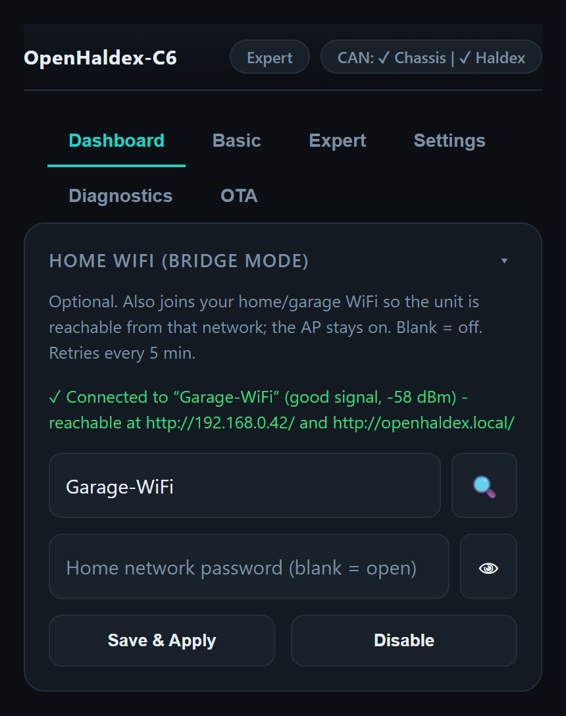
[picture p19: Images/ui-bridge-mode.png]
Diagnostics — Home WiFi (Bridge Mode) card, connected to a home network and showing its LAN address
  
</p>

Two things worth knowing:

- The ESP32‑C6 has **one radio** shared between its AP and the client side. A scan or a connection attempt pulls it off the AP's channel for a second or two. The controller therefore only looks for the home network for **20 s after starting**, then **once every 5 minutes** — so a saved home network can't keep interrupting the AP while the car is away from home.
- Bridge mode mostly doesn't change [Low Power Mode](#low-power-mode): with no CAN traffic and nobody using the controller, it still sleeps after five minutes (and drops off the home network). A browser that has the UI open through the router *does* count as "somebody" — it holds WiFi up the same way a phone joined to the AP does, so an update over the bridge can't be cut off. On the bench with nothing open, use Bench Mode.

Endpoints: `GET/POST /api/wifi/sta` `{ssid, password}` (empty `ssid` disables) · `POST /api/wifi/sta/reset` · `GET /api/wifi/scan` (asynchronous — poll until `scanning` is false).

---

## Backup & Restore

A firmware + filesystem reflash can wipe the settings stored on the device, and nobody wants to re-type an Expert grid. **Diagnostics → Backup & Restore** exports the Expert tune, steering-angle lock scale, per-generation frame edits, every setting and the WiFi names to a JSON file, and imports them back in one go.

WiFi passwords are **write-only** on the device and are never written to the file; after an import you're prompted once for any that were set.

<p align="center">
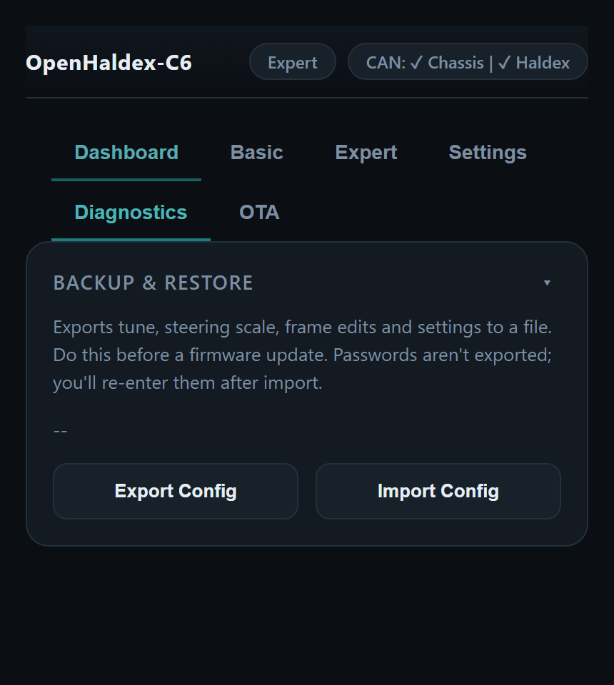
[picture p20: Images/ui-backup-restore.png]
Diagnostics — Backup & Restore card with Export Config and Import Config
  
</p>

The same file format works from a computer with [`tools/openhaldex_config.py`](tools/openhaldex_config.py):

```
python tools/openhaldex_config.py export backup.json
python tools/openhaldex_config.py import backup.json
python tools/openhaldex_config.py import backup.json --tune-only
```

Contributed in [PR #39](https://github.com/Forbes-Automotive/OpenHaldex-C6/pull/39) by louij2, along with Bench Mode and bridge mode.

---

## DashCAN App (Bluetooth)

The controller also talks **Bluetooth LE** to the **DashCAN** mobile app, so the basics are on the phone without joining the **OpenHaldex‑C6** WiFi — and the app can stay connected to a DashCAN interface at the same time. The web UI remains the place for everything else (Expert maps, learning, generation setup, frame editing, OTA).

**From the app:**

- **Live** — mode buttons, controller on/off, lock target / actual, speed, throttle, rpm, boost, steering angle, CAN health and Haldex warnings (temperature protection, coupling open, speed limit).
- **Settings** — the settings you change per situation: force modes (TC off / hazard lights / external button → mode), release lock on brake / handbrake, no‑lock speed and throttle window, steering‑angle lock scaling, gradual lock release and its rate, live diagnostics, LED brightness. Changes made on the web UI show up in the app and the other way round.
- **Haldex diagnostics** — clutch / oil / module temperatures, supply voltage, clutch current and duty (and oil pressure / estimated torque on Gen4), from the same [Live Diagnostics](#live-diagnostics) pollers. Needs *Live diagnostics* switched on.
- **Gauges** — `AWD Lock`, `AWD Lock Target`, `Steering` and the Haldex temperatures can be placed on the app's dashboards and in drive recordings.

**Connecting.** With Bluetooth enabled (default), the app finds the controller as `OpenHaldex‑XXXX` and connects to the first one in range by itself; it can also be picked on the app's Bluetooth screen. Live data needs no pairing. The first change from a phone pairs it once:

- the **first phone** pairs without a code (the phone at most asks you to confirm);
- after that, **every new phone needs the 6‑digit pairing code**. It is shown in the app on an already paired phone and on the web UI (**Diagnostics → Bluetooth**).

**On the controller:** **Diagnostics → Bluetooth (DashCAN App)** has the enable switch, a *phone connected* indicator, the pairing code and **Forget Paired Phones** — this removes every paired phone, makes a new code, and lets the next phone pair without one again (also forget the device in the phone's Bluetooth settings). Bluetooth follows the WiFi into [Low Power Mode](#low-power-mode): it switches off when the car is parked and comes back with it.

<p align="center">
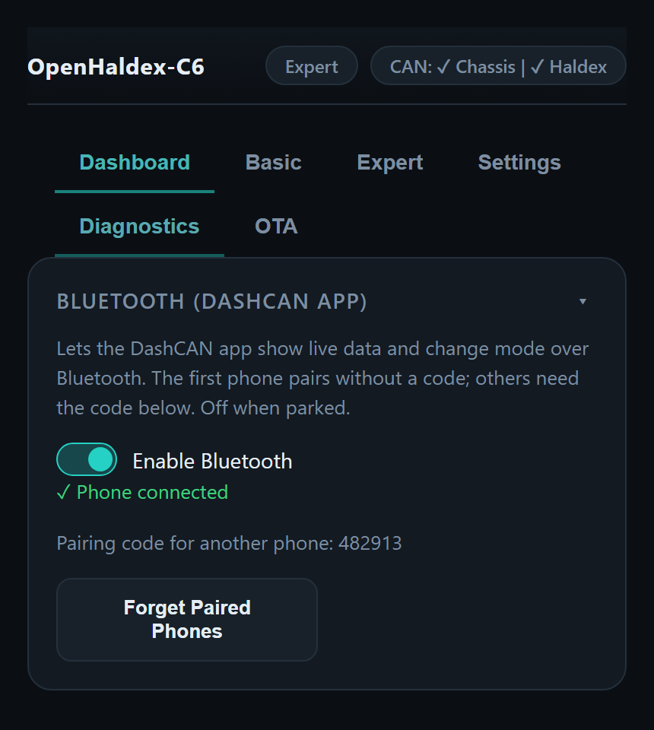
[picture p21: Images/ui-bluetooth.png]
Diagnostics — Bluetooth (DashCAN App) card: Enable Bluetooth on, phone connected, pairing code for another phone, Forget Paired Phones
  
</p>

*Diagnostics → **Bluetooth (DashCAN App)** with a phone connected: the pairing code shown is the one a second phone needs.*

> [!NOTE]
> Until the first phone has paired — on a new controller, or right after Forget Paired Phones — anyone within Bluetooth range could be that first phone. Pair yours straight away; if a phone you don't know got there first, use Forget Paired Phones. Firmware updates are never done over Bluetooth.

The protocol is documented in [`documents/MOBILE_APP_OPENHALDEX.md`](documents/MOBILE_APP_OPENHALDEX.md), so other apps can use it too. Endpoints: `POST /api/ble/forget`; `bleEnabled`, `blePasskey`, `bleCodeRequired` in `/api/settings`; `bleConnected`, `bleCodeRequired` in `/api/dashboard`.

---

## Installation

>[!TIP]
> ### Optional Plug & Play Harness (Recommended)
>
> Recommended for quick installation (and removal) — typically **<10 minutes** on Generation 1 Controllers.
> The latest harnesses for Generation 5 are even simpler and you'll be experiencing your Haldex controller in less than 30 seconds:

- Lift the rear seat
- Split the factory 6-pin Haldex connector
- Install your new harness & OpenHaldexC6 Controller
- Drive it (you could put the seat back down too, if you want!)

> For Generation 1 Controllers:

- Remove original connector and install the long end of the harness onto the differential.
- Route the long end along with the original connector back into the boot floor via. the OEM grommet
- Install and secure the OpenHaldexC6 Controller to the new harness, pairing it with the original plug

For full step‑by‑step instructions see the **[OpenHaldex Installation Guide](https://openhaldex.com/docs/OpenHaldex_Installation_Guide.pdf)**.

▶ **Installation demo (YouTube Short):** https://youtube.com/shorts/iUkNh9NbyKY?si=IhgqLIi0WM8wXqe9

▶ **Installation demo (YouTube Short):** https://youtu.be/Wu-u-Dz1444

> [!WARNING]
> ### Manual Wiring (No Harness)
>
> Modules sold without a harness include connector pins for manual wiring. This is a little harder and more involved than using the optional harness, but following the installation guide above it can still be completed easily. Give us a shout if you need a hand.

Gen1:
- Chassis Connector: `1J0‑973‑714`
- Haldex Conneector: `1J0‑973‑814`

Gen4>:
- Haldex Connector — `VW 1J0‑973‑713`
- Vehicle Connector — `VW 1J0‑973‑813`

Build this as a **Y-branch** harness between the two VW 8 or 6-pin connectors, with a long tail to the MX plug.

Routing summary:

- **Permanent power (Term30) and ground must also be branched to the OpenHaldex controller**:
  - Term30 -> MX Pin 1
  - Ground -> MX Pin 2
  
- Chassis CAN is taken from the Vehicle side and sent to the controller:
  - Vehicle Pin 5 -> MX Pin 3 (Chassis CAN Low)
  - Vehicle Pin 6 -> MX Pin 4 (Chassis CAN High)

- Returned CAN from the controller then goes to the Haldex side:
  - MX Pin 5 -> Haldex Pin 5 (Haldex CAN Low)
  - MX Pin 6 -> Haldex Pin 6 (Haldex CAN High)

Generation 1 > 4:
- Vehicle Connector — `VW 1J0‑973‑714`:

| Pin | Signal | Notes |
|----|---|---|
| 1 | Term15 | Pass-through: Vehicle → Haldex |
| 2 | Ground | Pass-through: Vehicle → Haldex and branch to MX Pin 2 |
| 3 | Brake Light | Pass-through: Vehicle → Haldex |
| 4 | Handbrake | Pass-through: Vehicle → Haldex |
| 5 | K-Line | Pass-through: Vehicle → Haldex |
| 6 | N/A | Not Used |
| 7 | Chassis Low | To MX Pin 3 (chassis side) |
| 8 | Chassis High | To MX Pin 4 (chassis side) |

- Haldex Connector — `VW 1J0‑973‑814`:

| Pin | Signal | Notes |
|----|---|---|
| 1 | Term15 | Pass-through: Vehicle → Haldex |
| 2 | Ground | Pass-through: Vehicle → Haldex and branch to MX Pin 2 |
| 3 | Brake Light | Pass-through: Vehicle → Haldex |
| 4 | Handbrake | Pass-through: Vehicle → Haldex |
| 5 | K-Line | Pass-through: Vehicle → Haldex |
| 6 | N/A | Not Used |
| 7 | Chassis Low | To MX Pin 5 (Haldex side) |
| 8 | Chassis High | To MX Pin 6 (Haldex side) |

Generation 5:
- Vehicle Connector — `VW 1J0‑973‑813`:

| Pin | Signal | Notes |
|----|---|---|
| 1 | Term15 | Pass-through: Vehicle → Haldex |
| 2 | Ground | Pass-through: Vehicle → Haldex and branch to MX Pin 2 |
| 3 | Term30 | Pass-through: Vehicle → Haldex and branch to MX Pin 1 |
| 4 | N/A | Not used |
| 5 | Chassis Low | To MX Pin 3 (chassis side) |
| 6 | Chassis High | To MX Pin 4 (chassis side) |

- Haldex Connector — `VW 1J0‑973‑713`:

| Pin | Signal | Notes |
|----|---|---|
| 1 | Term15 | Pass-through: Vehicle → Haldex |
| 2 | Ground/MALT | Pass-through from Vehicle side |
| 3 | Term30 | Pass-through from Vehicle side |
| 4 | N/A | Not used |
| 5 | Haldex Low | From MX Pin 5 (Haldex side) |
| 6 | Haldex High | From MX Pin 6 (Haldex side) |

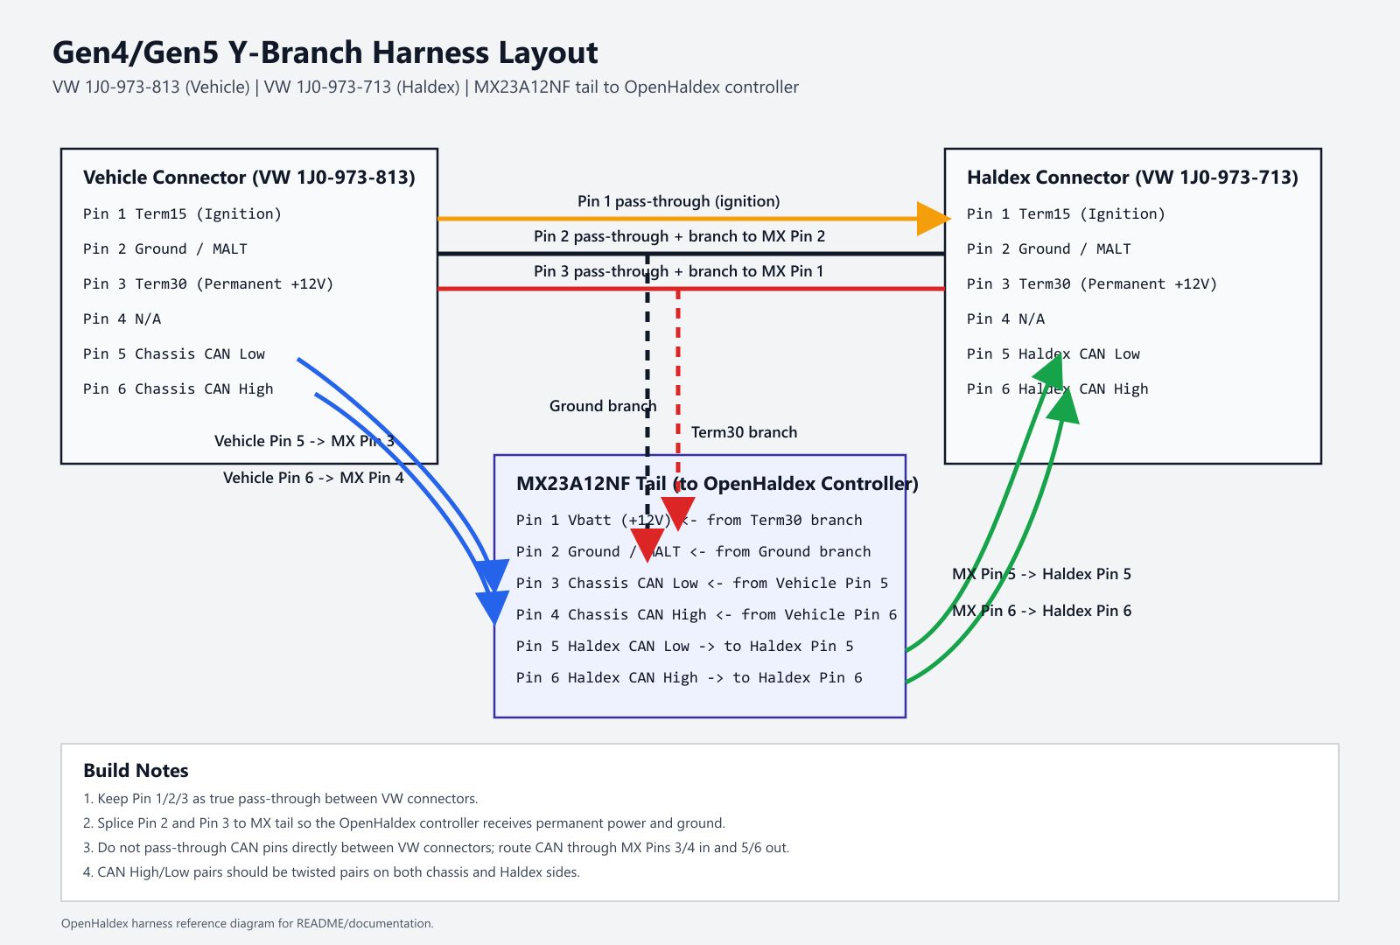
[picture p22: Images/Gen4_Gen5_Y_Branch_Harness.png]
Gen4/Gen5 Y-Branch Harness Diagram


### MX23A12NF Connector Pinout

| Pin | Signal | Notes |
|----|---|---|
| 1 | Vbatt | +12 V |
| 2 | Ground/MALT | Ground |
| 3 | Chassis CAN Low | To chassis/ECU side |
| 4 | Chassis CAN High | To chassis/ECU side |
| 5 | Haldex CAN Low | To Haldex differential |
| 6 | Haldex CAN High | To Haldex differential |
| 7 | Switch Mode External | +12 V to activate |
| 8 | Brake Switch In | +12 V input |
| 9 | Brake Switch Out | Gen1 / 2 differentials only |
|10 | Handbrake Switch In | +12 V input |
|11 | Handbrake Switch Out | Gen1 differentials only |

---

## Firmware Installation (ESP Web Tools)

Firmware can be installed directly from your browser using **ESP Web-Tools**.  
This is the recommended method for most users.

1. Connect the OpenHaldex-C6 controller to your computer using a **data-capable USB-C cable**.
2. Open the firmware installer page: **[Module Software Updater](https://forbes-automotive.com/pages/module-software-updater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)**
3. Click **Connect** and select the OpenHaldex serial port.
4. Click **Install** and follow the prompts.
5. Wait for the firmware to flash and the device to reboot.

> [!NOTE]
> Some USB-C cables are **power-only** and will not work for flashing.  
> If the device does not appear, try a different cable or USB port.

---

## OTA Updates (Wi‑Fi)

Once a controller is already running firmware **8.00.0 or later**, it can also be updated wirelessly over its own Wi‑Fi AP instead of by USB. This is a **two‑step process**, because the filesystem (web UI) and the firmware (application code) live on separate flash partitions and are updated independently:

1. **Step 1 — Filesystem update** (`POST /ota/update/fs`, uploads `littlefs.bin`)  
   Updates `index.html`, `app.js`, `style.css` and other web assets. From 11.00.3 most of these are stored gzipped in `littlefs.bin` (packed at build time by `tools/gzip_webui.py`), so the image is smaller and the pages load faster; the browser unpacks them, nothing changes on screen. From 11.00.4, `index.html` and `app.js` stay uncompressed so that units still on 11.00.2 or older (which look for those exact files) accept the update. The device does **not** reboot after this step — it's meant to be followed immediately by Step 2.
2. **Step 2 — Firmware update** (`POST /ota/update`, uploads `firmware.bin`)  
   Updates the application itself. The device reboots automatically once the upload finishes.

Both endpoints accept an optional `?sha256=<hex>` query parameter; when present the device hashes the upload as it arrives and refuses to activate an image that doesn't match. They need no password, but are **safety‑gated**:

- On the **bench** (no CAN detected), updates are allowed at any time.
- In the **vehicle** (CAN detected), an update is only allowed when the vehicle is stationary, both CAN buses are healthy, the controller is disabled or forced to Stock, and no Haldex temperature‑protection fault is active. `GET /ota/check` reports live pass/fail plus the reason if blocked.

After a firmware update the new image boots in a **pending‑verify** state (ESP‑IDF's rollback mechanism). It is only marked valid — cancelling the automatic rollback — once the web UI has been reached on the new image, or after 60 s of uptime; a build that crash‑loops before either point is reverted to the previous working firmware by the bootloader on the next reset, so a bad flash can't strand the car.

Other useful endpoints: `GET /ota/info` (current version, web‑UI version, chip, free heap, running partition), `GET /ota/fsinfo` (remounts the filesystem and reports the web‑UI version it holds — used to verify Step 1 before Step 2) and `GET /ota/health` (simple liveness check).

### Doing it from the OTA page

The **OTA** tab has three ways in, all ending in the same guided sequence (filesystem → verify → firmware → reboot) through the safety‑gated endpoints above. Nothing on the controller ever fetches from the internet; in every case it's the **browser** that gets the files and pushes them to the device.

**Option 1 — straight from GitHub.** The browser needs internet *while it can still reach the controller*. The reliable way to get that is [bridge mode](#home-wifi-bridge-mode): join the controller to your home/garage router (the **Home WiFi** card is repeated on the OTA tab for this), put the phone on the same network, and open the address the card shows. The phone keeps its normal internet and the controller is one hop away. On the bare **OpenHaldex‑C6** AP most phones drop mobile data, so that route is best‑effort.

1. Press **Check for updates**. The page first pings the controller — if it can't be reached you get a **Retry** and told why (wrong network, or the controller has gone to sleep). Then it fetches the release list. With no internet it reads the controller's bridge status and says exactly what to do next: join the network the controller is already on (address included), fix a configured‑but‑dropped link, or **Set up Home WiFi** (jumps to the card).
2. Pick a version. Newer stable releases are listed by default; tick **Show beta / older versions** to roll back. Rollback is allowed — the confirm warns that older releases may not have this page, so coming forward again could mean USB. Releases whose images don't fit this controller's flash layout (9.00.0 and older, from before the Bluetooth layout change) aren't listed, because they can only go on over USB.
3. **Install**. Each image is downloaded with a progress bar and uploaded, the filesystem is verified, then the firmware goes in and the page waits for the reboot.

Where the list comes from: [`Releases/releases.json`](Releases/releases.json) (notes, date, channel, `ota` flag, size and SHA‑256 per image — written by `tools/make_release.py`, which rescans every `Releases/V*/` folder; run it with `--reindex` after dropping a folder in by hand) merged with the `V*` folder listing from the GitHub API. A folder that isn't in the index yet still shows up, tagged *unverified* (no checksum, no notes); a folder deleted from GitHub disappears even if the index still lists it. `raw.githubusercontent.com` is tried first, then the jsDelivr mirror of the same repo.

**Option 2 — from files already on the phone, no internet needed.** Somewhere with signal, download `littlefs.bin` and `firmware.bin` from the newest `V…` folder under [`Releases/`](Releases/) (GitHub's **Download raw file** button). Back on the controller's WiFi, pick both files in one go — each is identified by its contents, not its name — and **Install picked files** runs the same sequence.

**Manual Upload** — the original one‑file‑at‑a‑time card: **Filesystem (web UI)** → `littlefs.bin`, then **Firmware (application)** → `firmware.bin`. The step tracker keeps its place across the reboot.

Keep the page open and the screen on during an install. While a browser is on the UI — including through the home router — the controller won't switch WiFi off for [Low Power Mode](#low-power-mode), and never while an upload is being written.

<p align="center">
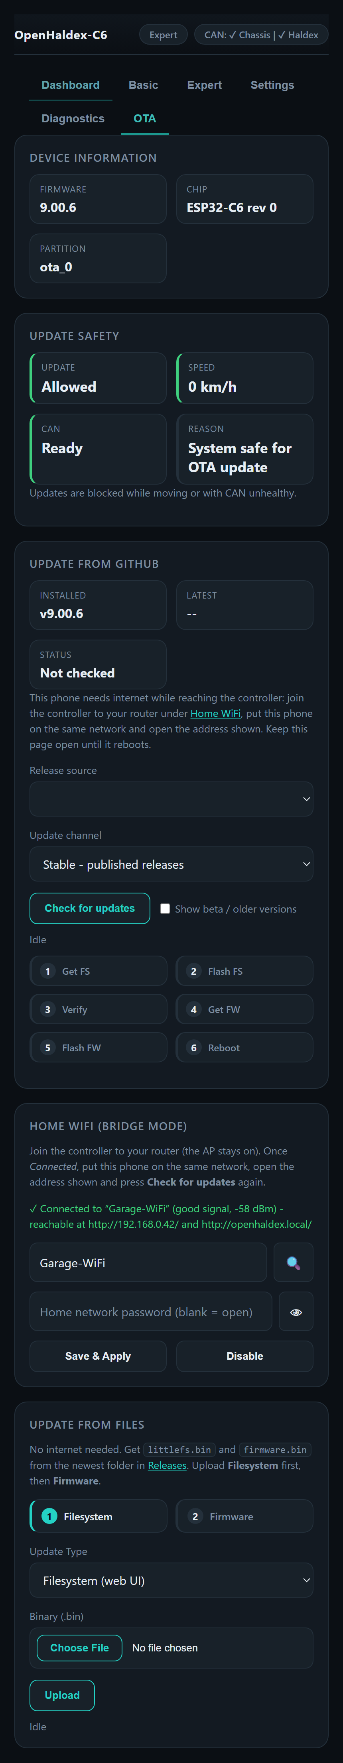
[picture p23: Images/ui-ota.png]
OTA tab — device information, the update safety gate and the two-step filesystem / firmware uploader
  
</p>

*OTA tab: the running firmware, the safety gate that has to read **Allowed** before an upload is accepted, and the two-step uploader (Filesystem first, then Firmware).*

> [!NOTE]
> USB via ESP Web‑Tools (above) remains the recommended method for a controller's **first** flash or for recovering from a failed update; OTA is for updating a controller that's already running.

> [!IMPORTANT]
> The first release with [Bluetooth](#dashcan-app-bluetooth) changes the flash layout (bigger firmware slots, smaller web‑UI partition). A partition table can't be changed over the air, so that release is installed **once over USB** with ESP Web Tools; settings are kept. It is not offered by the OTA page on older firmware. Later updates work over OTA again.

---

## Status Indicators

Throughout the Web UI — Diagnostics, CAN health, force‑mode sources, and similar live readouts — status is shown as a coloured pill or dot using a consistent convention:

| Colour | Meaning |
|---|---|
| 🟢 Green | Healthy / On / Available — the signal is present and in the expected state |
| 🔴 Red | Unhealthy / Off / Inactive — the signal is present but reporting a bad or inactive state |
| 🟠 Orange | Unavailable — no value has been received for this field (e.g. not applicable to the selected Haldex generation, or data hasn't arrived yet) |

This applies to items such as Chassis/Haldex CAN health, steering health, ASR/TC status, hazard and brake/handbrake inputs, and the OTA safety banner (`SAFE` in green / `NOT SAFE` in red). On MQB, the **Drive Mode** card underneath CAN Information shows the car's drive mode select (see [Drive Mode Select](#can--force-mode-drive-mode-select-mqb)).

On the dashboard, the **Haldex State** legend decodes the state byte for the selected generation: PQ fault flags on Gen1 / 2 / 4, and on Gen5 / VAQ the drive mode the unit is running plus its status (Starting Up / Available / Not Available / Out of Step).

From V11 each generation's own health bits are decoded as the unit's code really sets them. When the Haldex reports a fault, limp, over-temperature, AWD lamp, a temperature-sensor fault or a stored fault, a red **Haldex Warning** card appears at the top of the dashboard naming it, and the Haldex Data card shows each one as a tile next to the Haldex temperature. Diagnostics also shows **ABS Braking (CAN)**.

<p align="center">
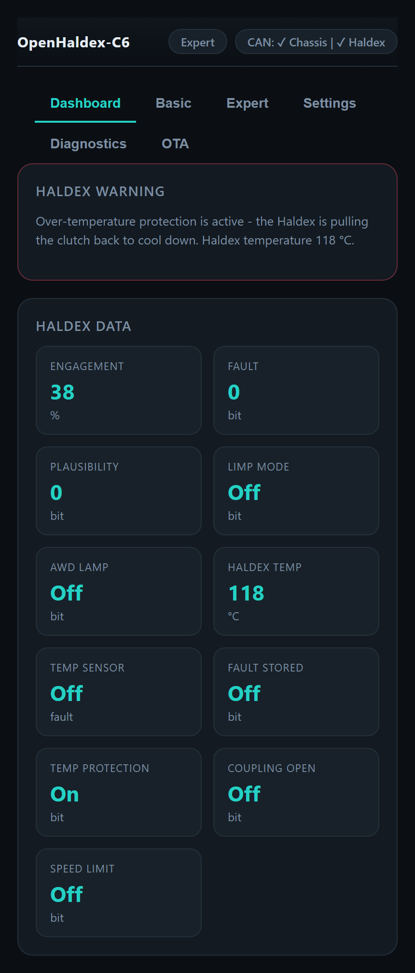
[picture p24: Images/ui-haldex-warning.png]
Dashboard — red Haldex Warning card (over-temperature protection) above the Haldex Data card with the health tiles
  
</p>

*Dashboard: the Haldex has pulled the clutch back to cool down, so the red Haldex Warning card names it, with the temperature and each health bit on the Haldex Data card underneath.*

<p align="center">
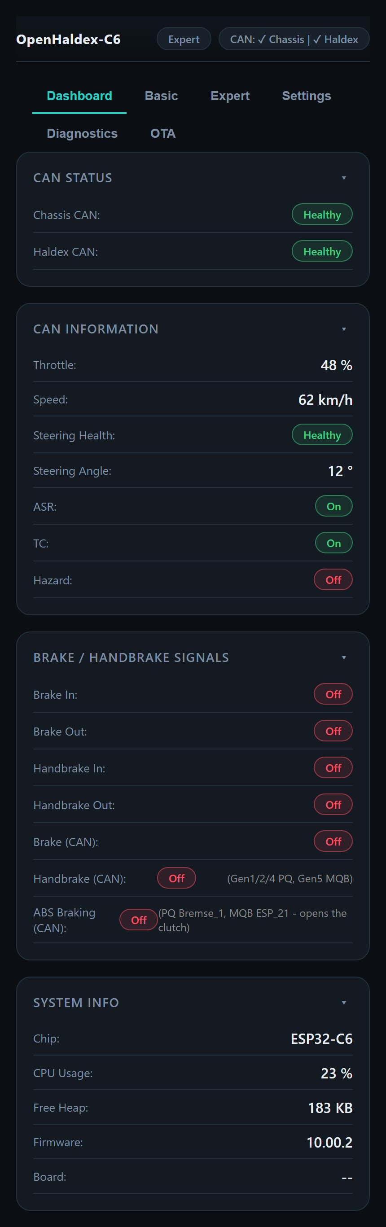
[picture p25: Images/ui-diagnostics.png]
Diagnostics tab — CAN status pills, CAN information (mode, force-mode sources, steering, ASR/TC, hazards), brake / handbrake signals and system info
  
</p>

*Diagnostics: both CAN buses healthy, the decoded chassis signals (steering health and angle, ASR/TC, hazards), the brake and handbrake input/output pills, plus chip, CPU load, free heap and firmware at a glance.*

---

## CAN Sniffing (SavvyCAN / GVRET)

Adding more functionality couldn't be easier - you just need to know the feature you want and grab some CAN data to help implement it.  Using the SavvyCAN interface, you can listen to the CAN messages to see what the car is talking about...

> [Thanks to Maetro for this feature!]

Enable **Analyzer Mode** in the setup menu to capture CAN frames.

> [!WARNING]
> Enabling Analyzer Mode disables active Haldex control and returns the device to OEM 'pass-through' behaviour.

### SavvyCAN Connection

1. Connect to the OpenHaldex Wi‑Fi AP
2. In Settings, enable SavvyCAN via WiFi

3. In SavvyCAN:

``` 
Open 'Connection'
```

```
Add New Device Connection → Network Connection (GVRET)
```

4. Enter:

```
IP: 192.168.1.1
Port: 23
```

5. Set CAN speed:

```
500000
```

(`250000` when Generation 2 - Volvo P2 (Pre-Facelift) is selected.)

### Serial Connection

SavvyCAN can also connect directly over USB without needing Wi‑Fi:

1. Connect the OpenHaldex controller via USB-C
2. In Settings, enable SavvyCAN via Serial
3. In SavvyCAN, add a new device connection → **Serial Connection (GVRET)**
4. Select the correct COM port and set the speed to **500000**

### Recording From a Laptop (no SavvyCAN)

[`tools/can_capture.py`](tools/can_capture.py) (contributed by Luca C) turns analyzer mode on, records each step of a test as a named phase over the same WiFi GVRET link, then turns analyzer mode off again. `analyze` lists every ID on each side (car / Haldex), names what it can from a DBC and the firmware's own ID list, flags anything unknown, and shows what appears, disappears or changes between phases:

```
python tools/can_capture.py --host 192.168.1.1 capture armed --seconds 30
python tools/can_capture.py --host 192.168.1.1 capture locked --seconds 30
python tools/can_capture.py analyze --dbc vw_pq.dbc
```

> [!WARNING]
> While analyzer mode is on, frames are passed through untouched and the Haldex runs stock. If a capture is interrupted, run `python tools/can_capture.py --host 192.168.1.1 off`.

---

## Live Diagnostics

OpenHaldex can request data from the Haldex ECU for **live measurement data** and display it in the Web UI - just like a scan tool would. This occupies the module's diagnostic channel, it is controlled by a single **Enable Live Diagnostics** toggle in Settings that is **off by default** — however if you use VCDS, ODIS or another diagnostic tool, it will automatically turn itself off until the scan tool is removed.

When enabled, the controller automatically uses the correct protocol for the configured generation — there is nothing else to select.

### Gen5 (MQB `0CQ` / PQ `0AY`) — UDS

Gets data from the Haldex ECU over ISO‑TP / UDS and decodes:

- Terminal voltage
- Control module temperature
- Clutch temperature
- Cooling‑fin temperature
- Clutch current, PWM and voltage

All scaling has been **confirmed against VCDS** by heat‑soaking a bench module and matching the reported values across the full temperature range.  

### Gen2 (`1K0`) / Gen4 (`0AY`) — KWP2000 over VW TP2.0

The PQ‑platform controllers are diagnosed with **KWP2000 tunnelled over VW TP2.0** rather than UDS. OpenHaldex opens the TP2.0 channel, starts a diagnostic session and reads the measuring blocks. Gen4 values are decoded and **confirmed against VCDS**:

- Oil temperature & clutch plate temperature
- Supply voltage
- Oil pressure
- Estimated torque
- Clutch valve duty (%) and current (A)

Raw measuring‑block bytes are also exposed so any remaining values can be characterised.

### Volvo P2 / P3 — Volvo D2

The Volvo AWD module's CAN reply carries the clutch pressure and its fault / limp state, but not its temperature. With Live Diagnostics on, OpenHaldex reads the **oil temperature** from the module over Volvo's own diagnostic protocol every 2 seconds and shows it on the Haldex temperature tile.

<p align="center">
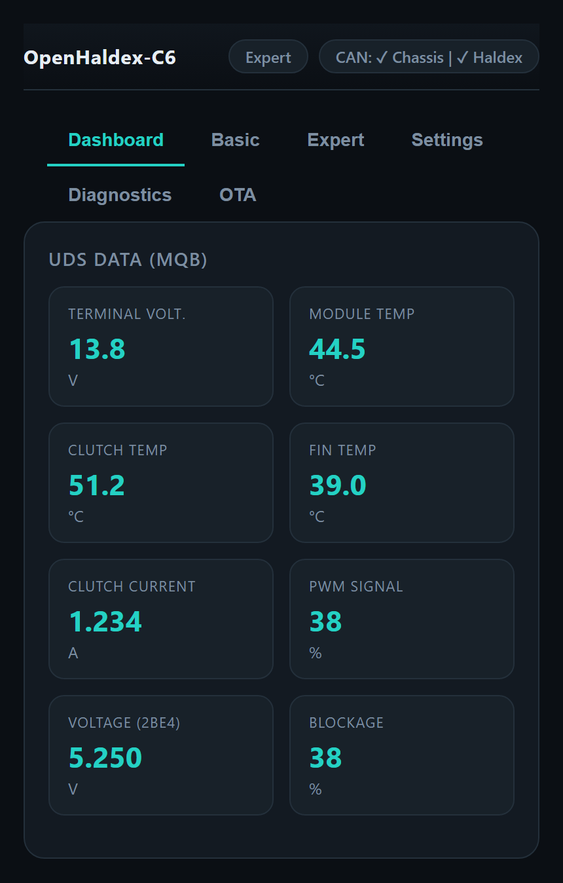
[picture p26: Images/ui-live-diag-uds.png]
Dashboard — UDS Data (MQB) card for Gen5: terminal voltage, module / clutch / fin temperatures, clutch current, PWM, voltage and blockage
  
  &nbsp;&nbsp;
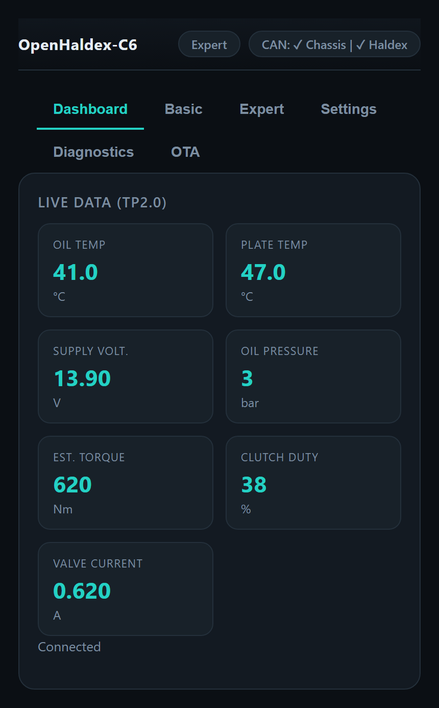
[picture p27: Images/ui-live-diag-kwp.png]
Dashboard — Live Data (TP2.0) card for Gen2 / Gen4: oil and plate temperature, supply voltage, oil pressure, estimated torque, clutch duty and valve current
  
</p>

*Dashboard: with Live Diagnostics enabled the standard Haldex Data card is replaced by the **UDS Data (MQB)** card on Gen5 (left) or the **Live Data (TP2.0)** card on Gen2 / Gen4 (right).*

> [!NOTE]
> If VCDS or other scan tools will not connect, turn this setting off as it may not cleanly pick up the VCDS request so it does not block the tool.  Excessive CAN traffic can cause spurious dash errors.

---

## Fault Codes

The **Fault Codes** card on the **Diagnostics** page reads and clears the Haldex module's own fault codes, the way a scan tool would. Press **Read Fault Codes** to list what's stored; **Clear Fault Codes** wipes them and reads again straight away, so anything that comes straight back shows up.

| Generation | Protocol | Codes shown as |
|---|---|---|
| Generation 1 | K-line only - use VCDS | - |
| Generation 2 (`7H0` / `1K0`), Generation 4 (`0BR`) | KWP2000 over VW TP2.0 | VAG 5-digit code + status |
| Generation 5 (`0CQ`, `0AY`, VAQ) | UDS (ISO-TP) | SAE code + failure type, active / stored |
| Volvo P2 (Gen2 / Gen3), Volvo P3 (Gen4) | Volvo D2 over CAN, module `0x1A` | `AWD-xxxx` |
| GM, Ford, Volvo P1, SAAB, Volvo SPC | Not yet - diagnostic address still to find | - |

- Live Diagnostics pauses itself while a read or clear runs, so the two never talk to the module at once. A connected scan tool (VCDS / ODIS) always has priority.
- Bench-proven on the Volvo P3. The VAG generations use the same channels Live Diagnostics already uses, but haven't been read on a module yet - please report what yours shows.
- From USB, the serial lab commands `FAULTS` and `FAULTSCLR` do the same.

---

## Frame Editing (Adding/Removing CAN Signals)

From the **Diagnostics** page you can enable or disable OpenHaldex's editing of **individual CAN frames** for the selected Haldex generation.

- Each editable frame for the current generation is listed as a checkbox.
- **Unchecking** a frame leaves the car's original message untouched (clean pass‑through); **checking** it lets OpenHaldex modify or generate that frame.
- Changes apply immediately and are saved per generation.
- A **Reset to Defaults** button restores the generation's standard set.

This is useful for **understanding** which edited frame upsets a Haldex learn procedure or causes fault codes, for tailoring behaviour on unusual vehicles, or for adding/removing specific signals during development.

<p align="center">
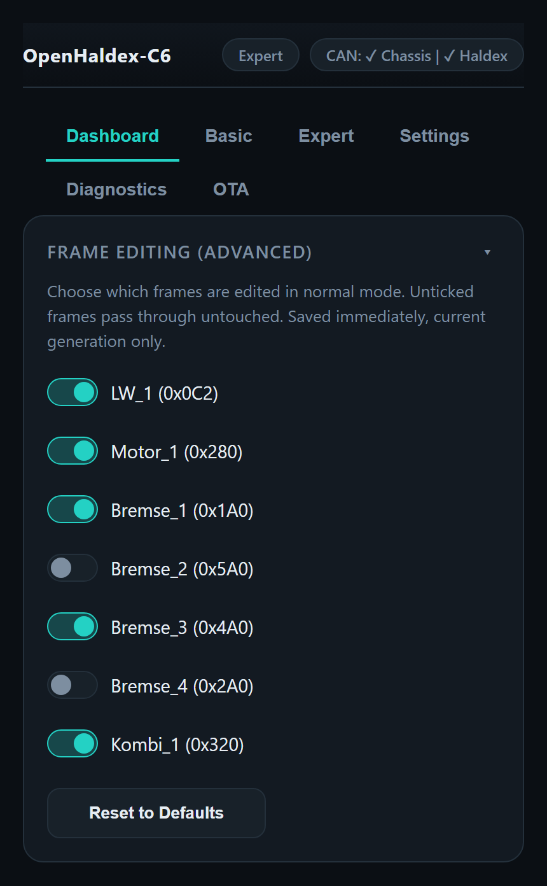
[picture p28: Images/ui-frame-editing.png]
Diagnostics — Frame Editing (Advanced) card listing each editable CAN frame for the selected generation as a toggle, with Reset to Defaults
  
</p>

> [!NOTE]
> Frame editing can apply to both 'Normal' and 'Standalone' modes and only to the currently selected generation.

---

## PCB & Enclosure

Gerber files are in the **PCB** folder and enclosure designs are in the **Enclosure** folder.  You can use these to get your own units if you wish.

Pinout and functionality remain consistent across supported enclosure versions.

The V3 enclosure is a shell and base, held together by 4 × M3 × 10 button head screws that go up through the base and PCB into M3 heat-set inserts in the shell. The mount clip is optional: the finished box snaps into it, and the clip fixes to the car through two 5.5 mm (M5) holes.

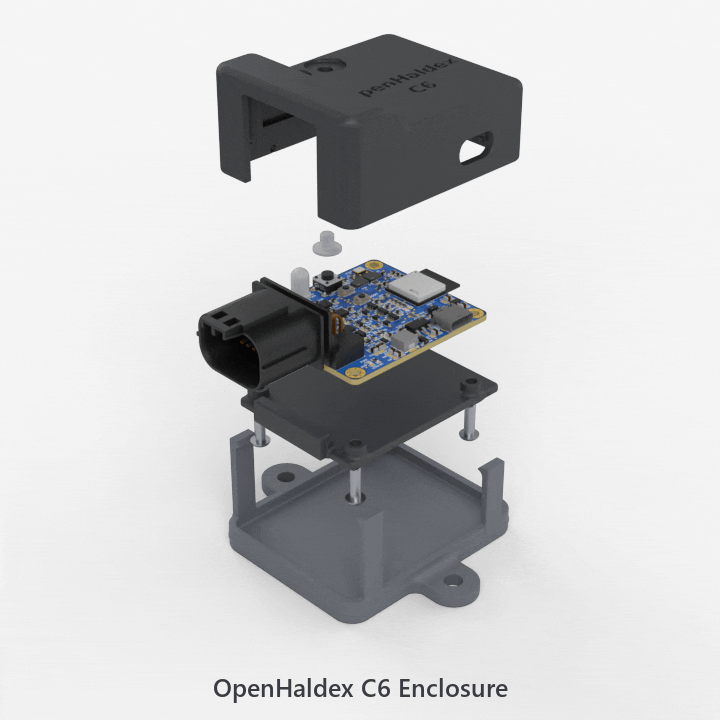
[picture p29: Images/enclosure-assembly.gif]
OpenHaldex-C6 V3 enclosure assembly: button pin, shell, PCB, base, screws and the optional mount clip coming together


OpenHaldex-C6
OpenHaldex-C6

---

## Nice to Haves

- Flashing LED indicator when CAN message transmission fails

---

## Acknowledgements

- **A Banging Donk** — [Original OpenHaldex project](https://github.com/ABangingDonk/OpenHaldexT4) for Gen1 vehicles
- **Chris (meatro) — OpenHaldex‑S3** — [OpenHaldex‑S3](https://github.com/meatro/OpenHaldex-S3) (MIT). Portions of the map editor / Expert Mode, CAN View, web UI, PlatformIO structure and API control derive from this project
- **RktBox (Kile Thomson) — OpenHaldex‑Edge** — [OpenHaldex‑Edge](https://github.com/Kile-Thomson/OpenHaldex-Edge). The geometry‑compensated per‑corner slip calculation (Ackermann wheel‑radius model) and the ESP_14 **Launch PWM Floor** (`BR_Vorg_*_Min` raise) were adopted from this project
- **jilleb — MQB-FPA** — [MQB-FPA](https://github.com/jilleb/MQB-FPA). The MQB drive profile and drive mode numbers behind [Drive Mode Select](#can--force-mode-drive-mode-select-mqb) (Comfort / Normal / Sport / Offroad / Eco / Race / Individual / Snow) come from this project's reverse engineering of the gateway's drive profile (FPA) data
- **Arwid Vasilev** — PCB redesign (V1.02)
- **LVT Technologies** — OTA update integration (now deprecated, but still appreciated)

---

## Licensing

OpenHaldex‑C6 is **open source** under the permissive [MIT License](https://opensource.org/licenses/MIT). The firmware source and the hardware design files (Gerbers, schematics, PCB layouts and enclosure files) are published so you can freely build, inspect, modify, redistribute and fabricate a controller for any purpose, including commercial use, subject only to preserving the copyright and license notices.

- **Forbes Automotive original code and hardware design files** (Gen2 / Gen4 / Gen5 work, PCB Gerbers, schematics and enclosure files) — **MIT License**. See [LICENSE.md](LICENSE.md).
- **OpenHaldex‑S3 derived portions** (Chris / meatro) — **MIT**. These remain under MIT; the MIT notice must be preserved.
- **OpenHaldex‑Edge derived portions** (Rekt / Kile Thomson) — per‑corner slip geometry and Launch PWM Floor. Attribution is retained in the source and in the third‑party notices.
- **Original OpenHaldex (Gen1, ABangingDonk)**.

Full attribution and upstream license texts are recorded in [THIRD_PARTY_NOTICES.md](THIRD_PARTY_NOTICES.md). If you redistribute source or binaries, keep the third‑party notices and license texts with the distribution.

> **In short:** use it, build it, modify it, redistribute it — that's all encouraged. Just keep the copyright and license notices intact.

---

## Disclaimer

> [!CAUTION]
> This device modifies Haldex behaviour and should only be used **off‑road or on a closed course**.
>
> The unit may behave unpredictably and could increase drivetrain wear.
>
> **Use at your own risk.** Forbes Automotive is not responsible for damages resulting from the use of this device or software.
