Forbes-Automotive/OpenHaldex-C6/Images/expertmode.jpg

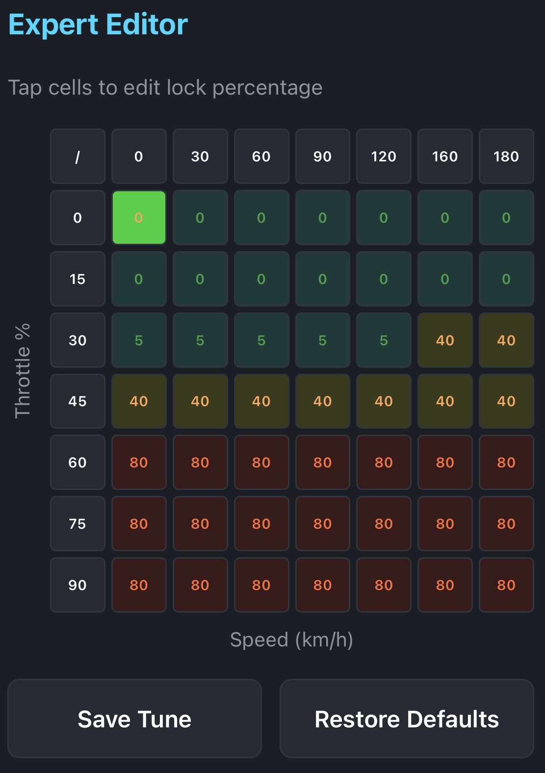
Images/expertmode.jpg
