Forbes-Automotive/OpenHaldex-C6/Images/ui-learn.png

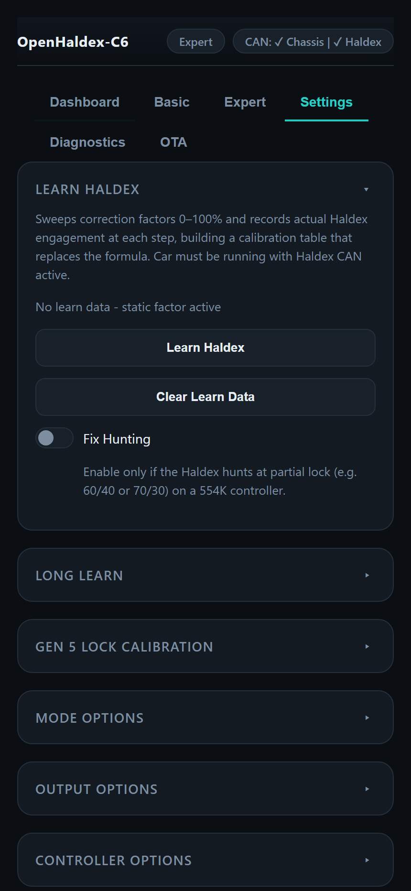
Images/ui-learn.png
