Forbes-Automotive/OpenHaldex-C6/Enclosure/HaldexC6_V3_ButtonPin.stl

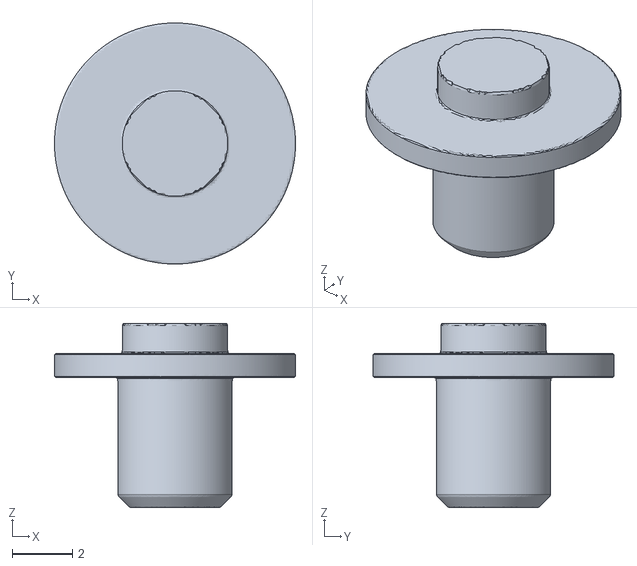
[picture p32: CAD file, 2026-11-04]
Enclosure/HaldexC6_V3_ButtonPin.stl
8.00 x 8.00 x 6.12
