Forbes-Automotive/OpenHaldex-C6/Enclosure/HaldexC6_V3_Shell_C6_ribbed.stl

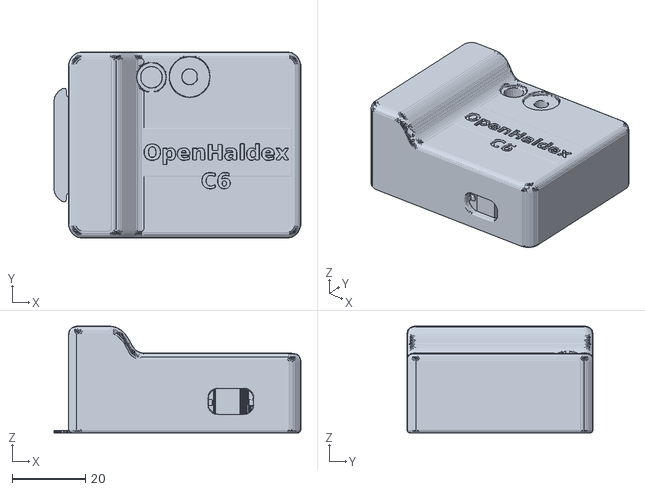
[picture p33: CAD file, 2026-11-04]
Enclosure/HaldexC6_V3_Shell_C6_ribbed.stl
67.2 x 50.8 x 29.0
