Forbes-Automotive/OpenHaldex-C6/Enclosure/HaldexC6_V3_Base_C6.stl

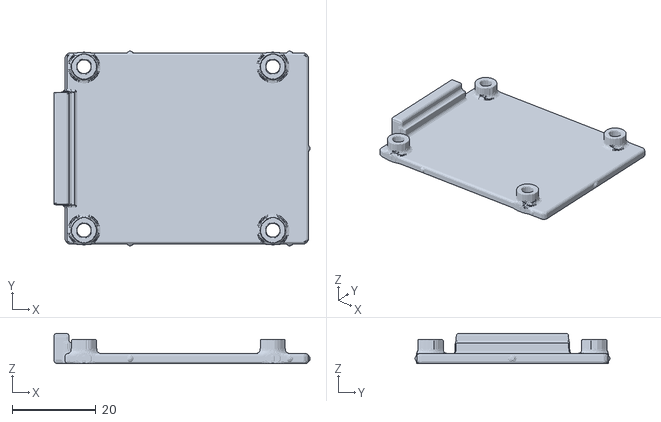
[picture p34: CAD file, 2026-11-04]
Enclosure/HaldexC6_V3_Base_C6.stl
61.0 x 46.4 x 7.20
