Forbes-Automotive/OpenHaldex-C6/Enclosure/HaldexBoxC6_V1_Lid_Recessed.STL

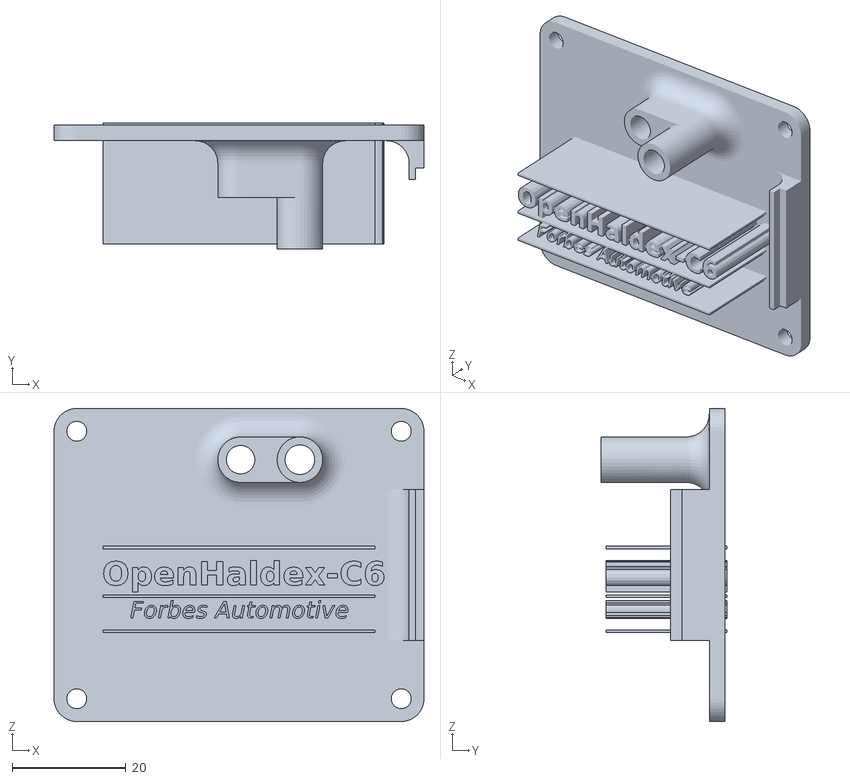
[picture p35: CAD file, 2026-07-29]
Enclosure/HaldexBoxC6_V1_Lid_Recessed.STL
65.0 x 22.1 x 55.0
