Forbes-Automotive/OpenHaldex-C6/Enclosure/HaldexBoxC6_V1_Lid_CutThrough.STL

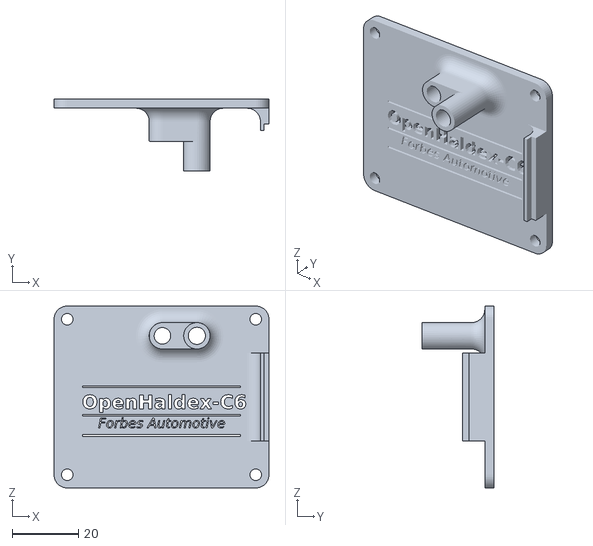
[picture p36: CAD file, 2026-07-29]
Enclosure/HaldexBoxC6_V1_Lid_CutThrough.STL
65.0 x 21.8 x 55.0
