Forbes-Automotive/OpenHaldex-C6/src/OpenHaldexC6_StandaloneCAN.cpp

#include <OpenHaldexC6_StandaloneCAN.h>
#include <OpenHaldexC6_Calculations.h>

// Standalone frames are the same frame-edit type as the passthrough path: a
// block turned OFF in the UI is simply not generated (mirrors the passthrough
// "leave the frame untouched" behaviour). Frames that are not listed as editable
// blocks for the active generation always send. All standalone Haldex-frame
// transmits go through here instead of calling twai_transmit_v2 directly.
// Checksummed frames: map a CAN ID to its ID sequence so an overridden byte can
// have its CRC recomputed. IDs absent here carry no checksum.
static const uint8_t *idSeqFor(uint32_t id)
{
  switch (id)
  {
  case 0x0A8:
    return ID_SEQ_0A8;
  case 0x0AD:
    return ID_SEQ_0AD;
  case 0x0A7:
    return ID_SEQ_0A7;
  case 0x08A:
    return ID_SEQ_08A;
  case 0x086:
    return ID_SEQ_086;
  case 0x121:
    return ID_SEQ_121;
  case 0x110:
    return ID_SEQ_110;
  case 0x106:
    return ID_SEQ_106;
  case 0x104:
    return ID_SEQ_104;
  case 0x116:
    return ID_SEQ_116;
  case 0x101:
    return ID_SEQ_101;
  case 0x0FD:
    return ID_SEQ_0fd;
  case 0x5BE:
    return ID_SEQ_5be;
  case 0x3BE:
    return ID_SEQ_3be;
  case 0x641:
    return ID_SEQ_641;
  case 0x645:
    return ID_SEQ_645;
  case 0x65D:
    return ID_SEQ_65d;
  case 0x392:
    return ID_SEQ_392;
  default:
    return nullptr;
  }
}

static inline void standaloneTx(twai_message_t &f)
{
  f.self = 0; // a self-received frame reads as a live Haldex (flicker to ✓ with lock 0)
  int genid = frameEditGenIdx(haldexGeneration);
  if (genid >= 0)
  {
    for (uint16_t i = 0; i < frameEditBlockCount; i++)
    {
      if (frameEditBlocks[i].genIdx == (uint8_t)genid &&
          frameEditBlocks[i].canId == f.identifier)
      {
        if (!frameEditEnabled((uint8_t)genid, frameEditBlocks[i].bit))
          return; // block disabled -> do not generate this frame
        break;
      }
    }
  }

  // Serial-lab byte overrides, applied last so they beat whatever built the
  // frame. CRC is recomputed after, or the Haldex would reject the frame and
  // the measurement would be of a dropped frame rather than a changed byte.
  bool overridden = false;
  for (uint8_t i = 0; i < LAB_OVR_MAX; i++)
  {
    if (labOverrides[i].canId == f.identifier && labOverrides[i].byteIdx < 8)
    {
      f.data[labOverrides[i].byteIdx] = labOverrides[i].value;
      overridden = true;
    }
  }
  if (overridden)
  {
    const uint8_t *seq = idSeqFor(f.identifier);
    // Volvo / SAAB frames carry no VW checksum: SAAB's 0x110 shares an ID with
    // a checksummed VW frame, so only recompute the CRC on the VW generations.
    if (seq && !isVolvoOrSaabGeneration(haldexGeneration))
      f.data[0] = calcChecksum(f.data, seq);
  }

  twai_transmit_v2(twai_bus_1, &f, 0);
}

// Periodic frame tasks
static void frames10()
{
  switch (haldexGeneration)
  {
  case 1:
    Gen1_frames10();
    break;
  case 2:
    Gen2_frames10();
    break;
  case 4:
    Gen4_frames10();
    break;
  case 41:
    Gen41_frames10();
    break;
  case 42:
    Gen42_frames10();
    break;
  case GEN_VOLVO_P2_GEN2:
    VolvoP2Gen2_frames10();
    break;
  case GEN_VOLVO_P2_GEN3:
    VolvoP2Gen3_frames10();
    break;
  case GEN_VOLVO_GEN4:
    VolvoGen4_frames10();
    break;
  case GEN_SAAB_93_XWD:
    Saab93_frames10();
    break;
  case GEN_VOLVO_SPC_GEN5:
    VolvoSpc_frames10();
    break;
  case GEN_VOLVO_P1:
    VolvoP1_frames10();
    break;
  case 50:
    Gen5_0CQ_frames10();
    break;
  case 51:
    Gen5_0AY_frames10();
    break;
  case 52:
    Gen5_0CQ_VAQ_frames10();
    break;
  }
}

static void frames20()
{
  switch (haldexGeneration)
  {
  case 1:
    Gen1_frames20();
    break;
  case 2:
    Gen2_frames20();
    break;
  case 4:
    Gen4_frames20();
    break;
  case 41:
    Gen41_frames20();
    break;
  case 42:
    Gen42_frames20();
    break;
  case GEN_VOLVO_P2_GEN2:
    VolvoP2Gen2_frames20();
    break;
  case GEN_VOLVO_GEN4:
    VolvoGen4_frames20();
    break;
  case GEN_SAAB_93_XWD:
    Saab93_frames20();
    break;
  case GEN_VOLVO_SPC_GEN5:
    VolvoSpc_frames20();
    break;
  case GEN_VOLVO_P1:
    VolvoP1_frames20();
    break;
  case 50:
    Gen5_0CQ_frames20();
    break;
  case 51:
    Gen5_0AY_frames20();
    break;
  case 52:
    Gen5_0CQ_VAQ_frames20();
    break;
  }
}

static void frames25()
{
  switch (haldexGeneration)
  {
  case 1:
    Gen1_frames25();
    break;
  case 2:
    Gen2_frames25();
    break;
  case 4:
    Gen4_frames25();
    break;
  case 41:
    Gen41_frames25();
    break;
  case 50:
    Gen5_0CQ_frames25();
    break;
  case 51:
    Gen5_0AY_frames25();
    break;
  case 52:
    Gen5_0CQ_VAQ_frames25();
    break;
  case GEN_VOLVO_P1:
    VolvoP1_frames25();
    break;
  }
}

static void frames100()
{
  lock_target = get_lock_target_adjustment();
  switch (haldexGeneration)
  {
  case 1:
    Gen1_frames100();
    break;
  case 2:
    Gen2_frames100();
    break;
  case 4:
    Gen4_frames100();
    break;
  case 41:
    Gen41_frames100();
    break;
  case 42:
    Gen42_frames100();
    break;
  case GEN_VOLVO_P2_GEN2:
    VolvoP2Gen2_frames100();
    break;
  case GEN_VOLVO_P2_GEN3:
    VolvoP2Gen3_frames100();
    break;
  case GEN_VOLVO_GEN4:
    VolvoGen4_frames100();
    break;
  case GEN_SAAB_93_XWD:
    Saab93_frames100();
    break;
  case GEN_VOLVO_SPC_GEN5:
    VolvoSpc_frames100();
    break;
  case 50:
    Gen5_0CQ_frames100();
    break;
  case 51:
    Gen5_0AY_frames100();
    break;
  case 52:
    Gen5_0CQ_VAQ_frames100();
    break;
  }
}

static void frames200()
{
  switch (haldexGeneration)
  {
  case 1:
    Gen1_frames200();
    break;
  case 2:
    Gen2_frames200();
    break;
  case 4:
    Gen4_frames200();
    break;
  case 41:
    Gen41_frames200();
    break;
  case 42:
    Gen42_frames200();
    break;
  case 50:
    Gen5_0CQ_frames200();
    break;
  case 51:
    Gen5_0AY_frames200();
    break;
  case 52:
    Gen5_0CQ_VAQ_frames200();
    break;
  }
}

static void frames1000()
{
  switch (haldexGeneration)
  {
  case 1:
    Gen1_frames1000();
    break;
  case 2:
    Gen2_frames1000();
    break;
  case 4:
    Gen4_frames1000();
    break;
  case 41:
    Gen41_frames1000();
    break;
  case 42:
    Gen42_frames1000();
    break;
  case GEN_SAAB_93_XWD:
    Saab93_frames1000();
    break;
  case 50:
    Gen5_0CQ_frames1000();
    break;
  case 51:
    Gen5_0AY_frames1000();
    break;
  case 52:
    Gen5_0CQ_VAQ_frames1000();
    break;
  }
}

// Gen1 Standalone Frames
// Synthesises the minimum PQ messages the haldex needs while no donor chassis bus is
// present. All frames go out on the haldex bus (twai_bus_1).
void Gen1_frames10()
{
  // not used in Gen1
}

void Gen1_frames20()
{
  twai_message_t frame = {};
  // PQ Motor_1 (0x280, DLC 8) - main engine ECU broadcast (vw_pq.dbc: Motor_1).
  // Byte layout and what the 02D reads: OEM code, spec_gen1_02d §3 / §5.
  frame.identifier = MOTOR1_ID;
  frame.extd = 0;
  frame.rtr = 0;
  frame.data_length_code = 8;
  frame.data[0] = 0x00;                     // status bits (bit 3 Kupplungsschalter = clutch switch) - all clear
  frame.data[1] = gen1_demand_value(0xFE);  // inneres_Motor_Moment (engine torque, % of max) - the demand
  frame.data[2] = 0x21;                     // Motordrehzahl low byte (engine rpm x 0.25)
  frame.data[3] = 0x4E;                     // Motordrehzahl high byte: FIXED 0x4E21 = 4872 rpm (V11). It used to be scaled with
                                            // the lock, which went below 400 rpm at low targets and the 02D turns its pump off
                                            // below 400 rpm = no lock (spec_gen1_02d D5). 0x4E21 is the bench-proven full-lock value.
  frame.data[4] = 0x00;                     // inneres_Motor_Moment_ohne_extern - not read by the 02D (spec D10, was mislabelled "pedal")
  frame.data[5] = gen1_demand_value(0xFE);  // Fahrpedalwert (accelerator pedal x 0.4 %) - the demand
  appliedTorque = gen1_loss_torque_byte(0x00); // mechanisches_Motor_Verlustmoment: the 02D subtracts it from byte 1 (0x00 = max demand)
  frame.data[6] = appliedTorque;            // loss torque, see the line above
  frame.data[7] = 0x00;                     // Fahrerwunschmoment (driver-wish torque) - not read by the 02D
  standaloneTx(frame);

  // PQ Motor_2 (0x288, DLC 8) - NEW in V11 (spec_gen1_02d D4). The 02D watches for
  // this frame: without it its "all inputs valid" check never passes and 0x2C0
  // byte 0 bit 4 stays set for ever (our UI used to show that as "limp mode").
  frame.identifier = MOTOR2_ID;
  frame.data_length_code = 8;
  frame.data[0] = 0xDA; // MO2_Mp_Code 3 (bits 6-7) + MO2_max_Mo 26 x 10 Nm = 260 Nm (bits 0-5) - same as the 02D's own default (OEM code §2.1)
  frame.data[1] = 0x00; // MO2_Kuehlm_T (coolant temperature) - not read by the 02D
  frame.data[2] = 0x00; // status bits, set below
  if (brakeForHaldex())
  {
    frame.data[2] = frame.data[2] | (1 << 0); // bit 0 MO2_BLS: brake light switch (Follow Brake on + brake pressed)
  }
  frame.data[3] = 0x00; // not read by the 02D
  frame.data[4] = 0x00; // not read by the 02D
  frame.data[5] = 0x00; // not read by the 02D
  frame.data[6] = 0x00; // not read by the 02D
  frame.data[7] = 0x00; // not read by the 02D
  standaloneTx(frame);

  // PQ Bremse_4 (0x2A0, DLC 3 per K-matrix vw_pq.dbc) - NEW in V11. Byte 0 is a
  // torque CEILING on the 02D's own request = our lock lever (spec_gen1_02d §2.3).
  // Motor_1 above is held at maximum demand while this block is on.
  frame.identifier = BRAKES4_ID;
  frame.data_length_code = 3;
  frame.data[0] = gen1_lever_byte(); // 0x7F = open, 0x81..0xC9 = partial (0xA5 ~ 50 %), 0xFD = full
  frame.data[1] = 0x00;              // not read by the 02D
  frame.data[2] = 0x00;              // not read by the 02D
  standaloneTx(frame);

  // PQ Motor_3 (0x380, DLC 8) - secondary engine ECU broadcast (vw_pq.dbc: Motor_3).
  // The 02D has NO receive slot for 0x380 (OEM code, spec_gen1_02d §1), so this
  // frame does nothing; its block is off by default since V11 (D8).
  frame.identifier = MOTOR3_ID;
  frame.data_length_code = 8;
  frame.data[0] = 0x00; // status flags (MO3_Sta_Pedal etc.)
  frame.data[1] = 0x50; // MO3_Pedalwert / MO3_Vorgluehen mux
  frame.data[2] = 0x00; // MO3_Rad_Wu_Mo low (wheel-torque request)
  frame.data[3] = 0x00; // MO3_Rad_Wu_Mo high
  frame.data[4] = 0x00; // MO3_Offsentemp (intake-air offset)
  frame.data[5] = 0x00; // reserved / Winterprg / Freigabe_Segeln
  frame.data[6] = 0x00; // reserved
  frame.data[7] = 0xFE; // reserved
  standaloneTx(frame);

  // PQ Bremse_1 (0x1A0, DLC 8) - ABS/ESP main broadcast.
  // Bremse = brake. The 02D reads bytes 0-2 only (OEM code, spec_gen1_02d §3);
  // it does not check the counter.
  frame.identifier = BRAKES1_ID;
  frame.data_length_code = 8;
  frame.data[0] = 0x80; // bit 7 BR1_EBV_Ongr as before; bit 2 BR1_ABS_Brems set below
  if (absBrakingForHaldex())
  {
    frame.data[0] = frame.data[0] | (1 << 2); // bit 2 BR1_ABS_Brems: the car's ABS is braking (only with a chassis bus)
  }
  frame.data[1] = 0x00; // bit 3 brake light, bit 4 pressure switch, bit 7 clutch release + pump off: all clear (brake goes in Motor_2)
  frame.data[2] = 0x00; // bit 0 brake-source select clear; rest = speed, not read by the 02D
  frame.data[3] = 0x0A; // not read by the 02D
  frame.data[4] = 0xFE; // not read by the 02D
  frame.data[5] = 0xFE; // not read by the 02D
  frame.data[6] = 0x00; // not read by the 02D
  frame.data[7] = BRAKES1_counter; // BR1_Zaehler counter (not checked by the 02D)
  if (++BRAKES1_counter > 0xF)
    BRAKES1_counter = 0;
  standaloneTx(frame);

  // PQ Bremse_3 (0x4A0, DLC 8) - per-wheel speeds (vw_pq.dbc: Bremse_3, word >> 1 = 0.01 km/h).
  // Without this frame the 02D's request is 0 (OEM code §2.1). 0x0A00 = 12.8 km/h on
  // every wheel; the fronts get up to 1.27 km/h of fake slip to add demand
  // (fine: the 02D's slip hold only starts at ~3.7 km/h front-over-rear, spec §5).
  frame.identifier = BRAKES3_ID;
  frame.data_length_code = 8;
  frame.data[0] = gen1_demand_value(0xFE); // Radgeschw_VL low (front-left wheel)
  frame.data[1] = 0x0A;                    // Radgeschw_VL high
  frame.data[2] = gen1_demand_value(0xFE); // Radgeschw_VR low (front-right)
  frame.data[3] = 0x0A;                    // Radgeschw_VR high
  frame.data[4] = 0x00;                                        // Radgeschw_HL low (rear-left)
  frame.data[5] = 0x0A;                                        // Radgeschw_HL high
  frame.data[6] = 0x00;                                        // Radgeschw_HR low (rear-right)
  frame.data[7] = 0x0A;                                        // Radgeschw_HR high
  standaloneTx(frame);
}

void Gen1_frames25()
{
  // not used in Gen1
}
void Gen1_frames100()
{
  // PQ Kombi_1 (0x320, DLC 8) - NEW in V11, block OFF by default. The 02D reads
  // byte 1 bit 1 (KO1_Handbremse): pulling the handbrake between 5 and 100 km/h
  // opens the clutch (OEM code, spec_gen1_02d §2.2). While this frame is NOT sent
  // the 02D uses its own handbrake wire instead, which is why it is off by default.
  twai_message_t frame = {};
  frame.identifier = mKombi_1;
  frame.extd = 0;
  frame.rtr = 0;
  frame.data_length_code = 8;
  frame.data[0] = 0x00; // lamp bits - not read by the 02D
  frame.data[1] = 0x00; // bit 1 KO1_Handbremse set below; bit 0 Bremsinfo (brake fluid) clear
  if (handbrakeForHaldex())
  {
    frame.data[1] = frame.data[1] | (1 << 1); // bit 1: handbrake pulled (Follow Handbrake on + handbrake pulled)
  }
  frame.data[2] = 0x00; // not read by the 02D
  frame.data[3] = 0x00; // not read by the 02D
  frame.data[4] = 0x00; // not read by the 02D
  frame.data[5] = 0x00; // not read by the 02D
  frame.data[6] = 0x00; // not read by the 02D
  frame.data[7] = 0x00; // not read by the 02D
  standaloneTx(frame);
}
void Gen1_frames200()
{
  // not used in Gen1
}
void Gen1_frames1000()
{
  // not used in Gen1
}

// Gen2 Standalone Frames (PQ - VW Touran/early Audi etc.)
// Richer than Gen1: needs steering-angle (LW_1), Kombi_1, and several brake-side frames.
// All transmitted on the haldex bus (twai_bus_1).
// V11.00.0 (OEM code: documents/haldex-binaries/leaf_trace/spec_gen2_7h0.md §5):
//   - lock lever = Bremse_4 (0x2A0) byte 0 (0x7F open .. 0xFD full), with Motor_1 held
//     at full demand and a little front-wheel slip while lock is wanted (gen2DemandValue).
//   - the unit checks NO checksums; alive counters only on Bremse_1 b7 bits 0-3,
//     LW_1 b5 bits 4-7 and 0x4A8 b6 bits 4-7 - those must change every frame.
//   - Motor_3 (0x380), Bremse_9 (0x0AE), Bremse_10 (0x3A0) are not received by the
//     7H0 / 1K0 - their blocks are off by default (frameEditMaskDefaultsSA).
//   - 1K0907554B: identical frames and lever (only its internal final-request scale differs).
//   - one Haldex bus on the car (the second CAN controller the OEM code sets up is
//     not wired), so every frame here reaches the unit on that bus.
void Gen2_frames10()
{
  twai_message_t frame = {};
  // PQ Bremse_1 (0x1A0, DLC 8) - ABS/ESP main broadcast (vw_pq.dbc: Bremse_1).
  // The unit reads (spec_gen2_7h0 §3): b0 bit2/bit4, b1 bits 0/3/4/7, b2 bit0, b6 low
  // nibble, b7 bit5, and b7 bits 0-3 as an alive counter. "ABS/ESP bits clear" = normal car.
  frame.identifier = BRAKES1_ID;
  frame.data_length_code = 8;
  frame.data[0] = 0x00; // b0: BR1_ASR_Anf, MSR_Anf, bit2 BR1_ABS_Brems, bit4 BR1_ESP_Ongr - all off
  if (absBrakingForHaldex())
  {
    frame.data[0] = frame.data[0] | (1 << 2); // bit2 BR1_ABS_Brems: car's ABS is braking - the unit opens the clutch
  }
  frame.data[1] = 0x40;                   // b1: bit6 BR1_Sta_MAD. bit0 BR1_Lampe_ABS now OFF (was 0x41 = ABS lamp on) - V11 TODO (bench): confirm
  frame.data[2] = 0x00;                   // b2: bit0 BR1_BKV_active (brake booster) off, bits1-7 BR1_Rad_kmh low (not read)
  frame.data[3] = 0xFE;                   // b3: BR1_Rad_kmh high (not read by the unit)
  frame.data[4] = 0xFE;                   // b4: BR1_ASRMo_sl (not read)
  frame.data[5] = 0xFE;                   // b5: BR1_ASRMo_fa (not read)
  frame.data[6] = 0x00;                   // b6: BR1_MSR_Mo (low nibble read - 0 = no engine drag request)
  frame.data[7] = BRAKES1_counter & 0x0F; // b7: bits0-3 BR1_Zaehler alive counter, bit5 BR1_ESPASR_passive = 0
  if (++BRAKES1_counter > 0xF)
    BRAKES1_counter = 0;
  standaloneTx(frame);

  // PQ Bremse_2 (0x5A0, DLC 8) - ESP/ABS sensor broadcast (vw_pq.dbc: Bremse_2).
  // Gen2 (OEM code, spec_gen2_7h0 §3) only reads b0, b1 bit0 and b7 bit7 - the
  // lock-adjusted b4/b5 below are ignored by the unit (harmless, left as they were).
  frame.identifier = BRAKES2_ID;
  frame.data_length_code = 8;
  frame.data[0] = 0x7F;                                        // Impulszahl (pulse count, low)
  frame.data[1] = 0xAE;                                        // Wegimpulse_Vorderachse (front-axle path pulses)
  frame.data[2] = 0x3D;                                        // mittlere_Raddrehzahl (mean wheel speed * 0.002 U/sec)
  frame.data[3] = BRAKES2_counter;                             // rolling counter (steps of 0x10)
  frame.data[4] = get_lock_target_adjusted_value(0x7F, false); // Querbeschleunigung (lateral G * 0.01)
  frame.data[5] = get_lock_target_adjusted_value(0xFE, false); // Zeitstempel low (timestamp tics)
  frame.data[6] = 0x5E;                                        // Zeitstempel high
  frame.data[7] = 0x2B;                                        // status / reserved
  BRAKES2_counter = BRAKES2_counter + 10;
  if (BRAKES2_counter > 0xF7)
    BRAKES2_counter = 7;
  standaloneTx(frame);

  // PQ Bremse_3 (0x4A0, DLC 8) - per-wheel speeds (see Gen1 for signal layout).
  // The unit works out slip from these (front average - rear average). Front wheels a
  // little faster than the rear = fake slip, so the unit's own request is above the
  // Bremse_4 ceiling and the lever decides. Full whenever lock is wanted (gen2DemandValue).
  // Safety: synthetic speeds - the unit's slip protection never sees real slip in standalone.
  frame.identifier = BRAKES3_ID;
  frame.data_length_code = 8;
  frame.data[0] = gen2DemandValue(0xFE); // Radgeschw_VL low (front left)
  frame.data[1] = 0x0A;                  // Radgeschw_VL high
  frame.data[2] = gen2DemandValue(0xFE); // Radgeschw_VR low (front right)
  frame.data[3] = 0x0A;                  // Radgeschw_VR high
  frame.data[4] = 0x00;                  // Radgeschw_HL low (rear left)
  frame.data[5] = 0x0A;                  // Radgeschw_HL high
  frame.data[6] = 0x00;                  // Radgeschw_HR low (rear right)
  frame.data[7] = 0x0A;                  // Radgeschw_HR high
  standaloneTx(frame);

  // PQ Bremse_4 (0x2A0) - THE LOCK LEVER (OEM code: spec_gen2_7h0 §2.3).
  // The unit reads b0 (a ceiling on its clutch request), b1 and b2 bit0 (role not
  // decoded); b3-7 are ignored (it only takes 3 bytes). b0 uses the same 0x80-offset
  // units as the engagement it sends back (0x2C0 byte 1):
  //   0x7F = 0 % (clutch open), 0x81..0xFD = (b0 - 0x80) / 0x7D x 100 %, 0xFD = 100 %.
  //   0xFE / 0xFF / below 0x7F = "no limit" (pre-V11 sent 0x00 here = no limit).
  frame.identifier = BRAKES4_ID;
  frame.data_length_code = 8;                    // unit needs at least 3
  frame.data[0] = vag_lever_byte(0xFD);          // lock request: 0x7F / 0x81..0xFC / 0xFD
  frame.data[1] = 0x00;                          // read by the unit, role not decoded - 0 as before
  frame.data[2] = 0x00;                          // bit0 read by the unit, role not decoded - 0 as before
  frame.data[3] = 0x00;                          // not read
  frame.data[4] = 0x00;                          // not read
  frame.data[5] = 0x00;                          // not read
  frame.data[6] = BRAKES4_counter;               // not read (kept as before)
  frame.data[7] = BRAKES4_counter;               // not read (kept as before)
  BRAKES4_counter = BRAKES4_counter + 10;
  if (BRAKES4_counter > 0xF0)
  {
    BRAKES4_counter = 0;
  }
  standaloneTx(frame);

  // PQ Bremse_5 (0x4A8, DLC 8) - ESP brake-event broadcast.
  // vw_pq.dbc: BR5_Giergeschw / BR5_Gierrate (yaw rate * 0.01 deg/s),
  //            BR5_Bremsdruck (brake pressure * 0.1 bar), BR5_Bremslicht,
  //            BR5_Notbremsung (emergency-brake), BR5_HDC_bereit (hill-descent-ready).
  // The unit reads a 12-bit value in b2-3 plus flags, and checks b6 bits 4-7 as an
  // alive counter - it must change every frame (spec_gen2_7h0 §1). No checksum checked.
  frame.identifier = BRAKES5_ID;
  frame.data_length_code = 8;                    // unit needs at least 7
  frame.data[0] = 0xFE;                          // Giergeschw low (yaw rate)
  frame.data[1] = 0x7F;                          // Giergeschw high
  frame.data[2] = 0x03;                          // BR5_Bremsdruck (brake pressure) low
  frame.data[3] = 0x00;                          // BR5_Bremsdruck high / Stillstand / Druckvalid bits
  frame.data[4] = 0x00;                          // ESP / Autohold status bits
  frame.data[5] = 0x00;                          // BR5_Anhi / Bremslicht / Notbremsung bits
  BRAKES5_counter = BRAKES5_counter + 0x10;      // next alive count in the top 4 bits (wraps 0xF? -> 0x0? on its own)
  frame.data[6] = BRAKES5_counter & 0xF0;        // b6 bits 4-7 = alive counter (was +10 per frame, which repeated values)
  frame.data[7] = BRAKES5_counter2;              // checksum byte - the unit does not check it
  BRAKES5_counter2 = BRAKES5_counter2 + 10;
  if (BRAKES5_counter2 > 0xF3)
  {
    BRAKES5_counter2 = 3;
  }
  standaloneTx(frame);

  // PQ Bremse_9 (0x0AE, DLC 8) - extended ABS/ESP frame (NOT in vw_pq.dbc).
  // NOT received by the 7H0 / 1K0 (OEM code: no receive object) - block off by default.
  // Older bench note: "only data[6] really matters (0x02 OK, 0x01 changes haldex behaviour)".
  frame.identifier = BRAKES9_ID;    // 0x0AE - not received by Gen2
  frame.data_length_code = 8;       // DLC 8
  frame.data[0] = BRAKES9_counter;  // checksum / rolling counter A
  frame.data[1] = BRAKES9_counter2; // checksum / rolling counter B
  frame.data[2] = 0x00;             // no effect
  frame.data[3] = 0x00;             // no effect
  frame.data[4] = 0x00;             // no effect
  frame.data[5] = 0x00;             // no effect
  frame.data[6] = 0x02;             // 0x01 - mode-control byte (only one that changes haldex behaviour)
  frame.data[7] = 0x00;             // no effect
  standaloneTx(frame);
  BRAKES9_counter = BRAKES9_counter + 10;
  if (BRAKES9_counter > 0xF1)
  {
    BRAKES9_counter = 0x11;
  }
  BRAKES9_counter2 = BRAKES9_counter2 + 10;
  if (BRAKES9_counter2 > 0xF0)
  {
    BRAKES9_counter2 = 0x00;
  }

  // PQ LW_1 / mLW_1 (0x0C2, DLC 8) - steering-angle broadcast (vw_pq.dbc: LW_1).
  // Lenkrad = steering wheel; LRW = Lenkradwinkel.
  frame.identifier = mLW_1;
  frame.data_length_code = 8;
  frame.data[0] = 0x20;          // LW1_LRW low (steering angle * 0.04375 deg)
  frame.data[1] = 0x00;          // LW1_LRW high
  frame.data[2] = 0x00;          // LW1_LRW_Sign (0=left, 1=right) / status
  frame.data[3] = 0x00;          // LW1_Lenk_Gesch low (angular velocity * 0.04375 deg/s)
  frame.data[4] = 0x80;          // LW1_Lenk_Gesch high / LW1_Gesch_Sign
  frame.data[5] = mLW_1_counter; // LW1_Zaehler: bits 4-7 alive counter (steps of 0x10) - the unit checks it changes every frame
  frame.data[6] = 0x00;          // LW1_ID (calibration ID) / Initquelle
  mLW_1_crc = 255 - (frame.data[0] + frame.data[1] + frame.data[2] + frame.data[3] + frame.data[5]);
  frame.data[7] = mLW_1_crc; // inverted-sum CRC over data[0..3]+data[5] (Gen2 does not check it - harmless)
  mLW_1_counter = mLW_1_counter + 16;
  if (mLW_1_counter >= 0xF0)
    mLW_1_counter = 0;
  standaloneTx(frame);
}

void Gen2_frames20()
{
  twai_message_t frame = {};
  // PQ Motor_1 (0x280, DLC 8) - engine ECU broadcast (vw_pq.dbc: Motor_1).
  // V11 (OEM code, spec_gen2_7h0 §2.2 / §5): the unit reads b1 inner torque (ADDED to its
  // torque estimate), b6 loss torque (SUBTRACTED from b1), b5 pedal, b2-3 rpm and b0 bit3.
  // Before V11 b6 rose with lock and cancelled b1, and the rpm high byte was scaled with
  // lock (low lock = rpm near 0 = pump off). Now: rpm fixed, b6 = 0, b1/b5 full while lock
  // is wanted - the Bremse_4 lever (frames10) sets the actual lock.
  frame.identifier = MOTOR1_ID;
  frame.data_length_code = 8;
  frame.data[0] = 0x08;                  // b0: bit3 Kupplungsschalter (read as a status bit) - as before
  frame.data[1] = gen2DemandValue(0xFE); // b1: inneres_Motor_Moment (inner torque) - full while lock wanted
  frame.data[2] = 0x20;                  // b2: Motordrehzahl low (engine rpm x 0.25)
  frame.data[3] = 0x4E;                  // b3: Motordrehzahl high - 0x4E20 = 5000 rpm, fixed (above pump-on)
  frame.data[4] = 0xFA;                  // b4: inneres_Motor_Moment_ohne_extern (not read by the unit)
  frame.data[5] = gen2DemandValue(0xFE); // b5: Fahrpedalwert (pedal) - full while lock wanted
  frame.data[6] = 0x00;                  // b6: mechanisches_Motor_Verlustmoment (loss torque) - 0, never 0xFF (= invalid -> 30 Nm)
  frame.data[7] = 0xFA;                  // b7: Fahrerwunschmoment (not read by the unit)
  standaloneTx(frame);

  // PQ Motor_2 (0x288, DLC 8) - secondary engine broadcast (vw_pq.dbc: Motor_2).
  // Unit reads b0 (mux 3 = max engine torque; mux 0 here leaves its 300 Nm default)
  // and b2 bits 0/1 (brake vote).
  frame.identifier = MOTOR2_ID;
  frame.data_length_code = 8;
  frame.data[0] = 0x00; // MO2_Mp_Code mux 0 (MO2_CAN_Vers) - the unit keeps its 300 Nm torque reference
  frame.data[1] = 0x30; // MO2_Kuehlm_T (coolant temp * 0.75 - 48 degC)
  frame.data[2] = 0x00; // MO2_BLS (bit0) brake light, MO2_BTS (bit1), status flags - all off
  if (brakeForHaldex())
  {
    frame.data[2] = frame.data[2] | (1 << 0); // bit0 MO2_BLS: Follow Brake on and the brake is pressed
  }
  frame.data[3] = 0x0A; // MO2_GRA_Soll low (cruise-control target speed)
  frame.data[4] = 0x0A; // MO2_GRA_Soll high
  frame.data[5] = 0x10; // GRA / cruise status bits
  frame.data[6] = 0xFE; // reserved
  frame.data[7] = 0xFE; // reserved
  standaloneTx(frame);

  // PQ Motor_5 (0x480, DLC 8) - tertiary engine broadcast (vw_pq.dbc: Motor_5, multiplexed).
  // The unit only takes b0 (bits 0-5 value, bits 6-7 mux) - the rest is ignored.
  frame.identifier = MOTOR5_ID;   // 0x480
  frame.data_length_code = 8;     // DLC 8
  frame.data[0] = 0xFE;           // ASR 0x04 sets bit 4.  0x08 removes set.  Coupling open/closed - MO5_Mp_Code mux
  frame.data[1] = 0x00;           // can use to disable (>130 dec).  Was 0x00; 0x41?  0x43? - MO5_max_Moment / Drehzahl (mux)
  frame.data[2] = 0x00;           // was 0x00 no effect - MO5_Vorgluehen / E_Gas / OBD_2 lamps
  frame.data[3] = 0x00;           // was 0xFE no effect - MO5_Luefter (cooling-fan PWM)
  frame.data[4] = 0x00;           // was 0xFE miasrl no effect - reserved
  frame.data[5] = 0x00;           // was 0xFE miasrs no effect - reserved
  frame.data[6] = 0x00;           // was 0x00 - reserved
  frame.data[7] = MOTOR5_counter; // checksum / rolling counter (not read by the unit)
  MOTOR5_counter++;               // V11: was ++BRAKES1_counter (copy-paste bug that bumped Bremse_1's alive counter)
  standaloneTx(frame);

  // PQ Bremse_10 (0x3A0, DLC 8) - extended ABS/ESP frame (NOT in vw_pq.dbc).
  // NOT received by the 7H0 / 1K0 (OEM code: no receive object) - block off by default.
  // Inline notes are pre-existing reverse-engineering observations.
  frame.identifier = BRAKES10_ID;   // 0x3A0 - not received by Gen2
  frame.data_length_code = 8;       // DLC 8
  frame.data[0] = 0xA6;             // ASR 0x04 sets bit 4.  0x08 removes set.  Coupling open/closed
  frame.data[1] = BRAKES10_counter; // can use to disable (>130 dec).  Was 0x00; 0x41?  0x43? - rolling counter
  frame.data[2] = 0x75;             // was 0x00 no effect
  frame.data[3] = 0xD4;             // was 0xFE no effect
  frame.data[4] = 0x51;             // was 0xFE miasrl no effect
  frame.data[5] = 0x47;             // was 0xFE miasrs no effect
  frame.data[6] = 0x1D;             // was 0x00
  frame.data[7] = 0x0F;             // checksum (fixed)
  BRAKES10_counter = BRAKES10_counter + 1;
  if (BRAKES10_counter > 0xF)
  {
    BRAKES10_counter = 0;
  }
  standaloneTx(frame);
}

void Gen2_frames25()
{
  twai_message_t frame = {};
  // PQ Kombi_1 (0x320, DLC 8) - instrument-cluster broadcast (vw_pq.dbc: Kombi_1).
  frame.identifier = mKombi_1;
  frame.data_length_code = 8;
  frame.data[0] = 0x00; // Oeldruck / Tankwarn / Vorglueh lamp bits
  frame.data[1] = 0x00; // bit0 KO1_Bremsinfo (fluid warn) off, bit1 KO1_Handbremse released. V11: was 0x02 = handbrake PULLED (unit reads b1 bit1)
  if (handbrakeForHaldex())
  {
    frame.data[1] = frame.data[1] | (1 << 1); // bit1 KO1_Handbremse: Follow Handbrake on and the handbrake is pulled
  }
  frame.data[2] = 0x00; // Geschwindigkeit_Kombi_1 low (raw vehicle speed * 0.01 km/h)
  frame.data[3] = 0x00; // Geschwindigkeit_Kombi_1 high
  frame.data[4] = 0x36; // Tankinhalt (fuel level, 1..126 l)
  frame.data[5] = 0x00; // Dynamische_Oeldruckwarnung / status
  frame.data[6] = 0x00; // reserved
  frame.data[7] = 0x00; // reserved
  standaloneTx(frame);
}

void Gen2_frames100() {}
void Gen2_frames200() {}
void Gen2_frames1000() {}

// Gen4 Standalone Frames (0BR / 0BS / 2K, PQ frame set).
// V11.00.0: rebuilt from the OEM code (documents/haldex-binaries/leaf_trace/
// spec_gen4_0br.md). The lever is Bremse_4 byte 0 (linear, no counter/CRC
// check). Every other frame the unit monitors is sent with steady, plausible
// content so it never logs a false "missing message" fault - its own genuine
// protections (over-temperature, limp, lamp) are left alone and reported.
// Replays steering (LW_1) from a 16-step capture (lws_2[]).
// All frames go out on the haldex bus (twai_bus_1).

// Gen4-only rolling counters. "static" here = private to this file.
static uint8_t gen4Bremse5Counter = 0; // Bremse_5 b6 high nibble, 0..15 (not checked by the 0BR)
static uint8_t gen4Bremse8Counter = 0; // Bremse_8 b1 low nibble, 0..15 (not checked by the 0BR)

// Wheel / vehicle speed word for Bremse_3 (and Bremse_1 b2-3) on Gen4.
// Bremse_3 carries each wheel as a 15-bit 0.01 km/h value in bits 1-15 of a
// 16-bit word (bit 0 is a spare flag), so word = km/h x 100 x 2.
// Real vehicle speed when the car's CAN is connected; otherwise a steady
// 10 km/h, close to the ~9.9 km/h (0x07B6-0x07D2) the pre-V11 frames sent.
// All four wheels get the same value: no fake slip (spec_gen4_0br §5).
static uint16_t gen4SpeedWord()
{
  uint16_t speedKmh = 10; // fallback when no real speed is known
  if (hasCANChassis)
  {
    speedKmh = received_vehicle_speed; // real speed from the car's ABS / engine frames
  }
  if (speedKmh > 326)
  {
    speedKmh = 326; // top of the 15-bit 0.01 km/h range
  }
  uint16_t speedWord = (uint16_t)(speedKmh * 100) << 1; // 0.01 km/h steps, shifted past spare bit 0
  return speedWord;
}

void Gen4_frames10()
{
  twai_message_t frame = {};
  // PQ LW_1 / mLW_1 (0x0C2, DLC 8) - steering-angle replay (vw_pq.dbc: LW_1).
  frame.identifier = mLW_1;
  frame.extd = 0;
  frame.rtr = 0;
  frame.data_length_code = 8;
  // Byte layout as the 0BR reads it (spec_gen4_0br §3); replay table is fine (§5).
  frame.data[0] = lws_2[mLW_1_counter][0]; // LW1_LRW low (steering-wheel angle * 0.04375 deg)
  frame.data[1] = lws_2[mLW_1_counter][1]; // LW1_LRW high bits 0-6, b1.7 = sign
  frame.data[2] = lws_2[mLW_1_counter][2]; // LW1_Lenk_Gesch low (steering rate - not read by Gen4)
  frame.data[3] = lws_2[mLW_1_counter][3]; // LW1_Lenk_Gesch high (not read by Gen4)
  frame.data[4] = lws_2[mLW_1_counter][4]; // LW1_ID (read by Gen4)
  frame.data[5] = lws_2[mLW_1_counter][5]; // b5 bits 1-2 status, bits 4-7 counter (not checked)
  frame.data[6] = lws_2[mLW_1_counter][6]; // not read by Gen4
  frame.data[7] = lws_2[mLW_1_counter][7]; // CRC (replayed verbatim; Gen4 copies only 6 bytes)

  mLW_1_counter++;
  if (mLW_1_counter > 15)
    mLW_1_counter = 0;
  standaloneTx(frame);

  // Speed shared by Bremse_1 and Bremse_3 this cycle (real, or a steady 10 km/h)
  uint16_t speedWord = gen4SpeedWord();

  // PQ Bremse_1 (0x1A0, DLC 8) - ABS/ESP main broadcast (vw_pq.dbc: Bremse_1).
  // The 0BR reads b0.0 ASR request, b0.2 ABS braking, b0.3 EDS, b0.4 ESP,
  // b1.3 / b1.4 and the b7 counter (not checked) - spec_gen4_0br §3. It does
  // NOT read the vehicle speed (b2-3) or b4-6.
  uint8_t bremse1Byte0 = 0x00; // no ASR / ABS / EDS / ESP intervention
  if (absBrakingForHaldex())
  {
    bremse1Byte0 = bremse1Byte0 | (1 << 2); // b0.2 BR1_ABS_Brems: the car's ABS is braking
  }
  frame.identifier = BRAKES1_ID;
  frame.data_length_code = 8;
  frame.data[0] = bremse1Byte0;                     // BR1_ASR_Anf b0.0 / ABS_Brems b0.2 / EDS b0.3 / ESP b0.4 (V11: was 0x20)
  frame.data[1] = 0x00;                             // BR1 lamps / status, b1.3 + b1.4 read by Gen4 = 0 (V11: was 0x40)
  frame.data[2] = (uint8_t)(speedWord & 0xFF);      // BR1_Rad_kmh low (bit 0 = BR1_BKV_active, 0) - not read by Gen4
  frame.data[3] = (uint8_t)(speedWord >> 8);        // BR1_Rad_kmh high
  frame.data[4] = 0xFE;                             // BR1_ASRMo_sl: ASR torque limit at max = no ASR cut (not read by Gen4)
  frame.data[5] = 0xFE;                             // BR1_ASRMo_fa: same (not read by Gen4)
  frame.data[6] = 0x00;                             // BR1_MSR_Mo: no drag-torque request (not read by Gen4)
  frame.data[7] = BRAKES1_counter & 0x0F;           // BR1_Zaehler b7 bits 0-3 (0..15); b7.4/b7.5 ASR/ESP off = 0
  BRAKES1_counter++;
  if (BRAKES1_counter > 0x0F)
    BRAKES1_counter = 0; // V11: was 10..0x1F, which jumped F -> A in the nibble (§7 #21)
  standaloneTx(frame);

  // PQ Bremse_3 (0x4A0, DLC 8) - per-wheel speeds (vw_pq.dbc: Bremse_3).
  // V11: four EQUAL, steady speeds (real vehicle speed when we have it). Before
  // V11 these were lock-scaled to fake slip; the lever is Bremse_4 now (§7 #9).
  frame.identifier = BRAKES3_ID;
  frame.data_length_code = 8;
  frame.data[0] = (uint8_t)(speedWord & 0xFF); // Radgeschw_VL low (front-left)
  frame.data[1] = (uint8_t)(speedWord >> 8);   // Radgeschw_VL high
  frame.data[2] = (uint8_t)(speedWord & 0xFF); // Radgeschw_VR low (front-right)
  frame.data[3] = (uint8_t)(speedWord >> 8);   // Radgeschw_VR high
  frame.data[4] = (uint8_t)(speedWord & 0xFF); // Radgeschw_HL low (rear-left)
  frame.data[5] = (uint8_t)(speedWord >> 8);   // Radgeschw_HL high
  frame.data[6] = (uint8_t)(speedWord & 0xFF); // Radgeschw_HR low (rear-right)
  frame.data[7] = (uint8_t)(speedWord >> 8);   // Radgeschw_HR high
  standaloneTx(frame);

  // Bremse_4 byte 0 = the 0BR's direct clutch-torque lever (OEM code:
  // spec_gen4_0br §2.2 / §2.6):
  //   0 %     -> 0x7F  valid zero request, clutch commanded fully open
  //   1-99 %  -> 0x80 + % x 1.25 (linear, 112 internal torque units per step)
  //   100 %   -> 0xFE  the unit's present maximum clutch capacity
  // The unit still caps this with its own limits (over-temperature etc).
  // V11: was 0x7F x CF/100 (below 0x7F = ignored) and 0x7F at 100 % outside
  // 50:50 = clutch open (§7 #1 / #2). Learn sweeps this byte too (§7 #3).
  appliedTorque = vag_lever_byte(0xFE); // Gen4: 0xFE = full lock

  // PQ Bremse_4 (0x2A0, DLC 8) - only byte 0 is read; byte 6 counter and byte
  // 7 checksum are ignored by the 0BR (§7 #20), kept as before.
  frame.identifier = BRAKES4_ID;
  frame.data_length_code = 8;
  frame.data[0] = appliedTorque;   // lever (see above)
  frame.data[1] = 0x00;            // not read by Gen4
  frame.data[2] = 0x00;            // not read by Gen4
  frame.data[3] = 0x64;            // not read by Gen4
  frame.data[4] = 0x00;            // not read by Gen4
  frame.data[5] = 0x00;            // not read by Gen4
  frame.data[6] = BRAKES4_counter; // rolling counter, high nibble (not checked)
  BRAKES4_crc = 0;
  for (uint8_t i = 0; i < 7; i++)
  {
    BRAKES4_crc ^= frame.data[i];
  }
  frame.data[7] = BRAKES4_crc; // XOR checksum over data[0..6] (not even copied by the 0BR)
  BRAKES4_counter = BRAKES4_counter + 16;
  if (BRAKES4_counter > 0xF0)
    BRAKES4_counter = 0x00;
  standaloneTx(frame);

  // PQ Motor_1 (0x280, DLC 8) - engine ECU broadcast (vw_pq.dbc: Motor_1).
  // V11: steady values. Motor_1 only feeds the unit's own strategy, which a
  // valid Bremse_4 byte overrides, so it is no longer lock-scaled (§5).
  // Light-cruise figures chosen as plausible - not from a log.
  frame.identifier = MOTOR1_ID;
  frame.data_length_code = 8;
  frame.data[0] = 0x00; // flags: b0.3 Kupplungsschalter 0 = clutch pedal released (V11: was left over from Bremse_4 = "pressed", §7 #4)
  frame.data[1] = 0x20; // inneres_Motor_Moment (inner torque, 0.39 % per bit)
  frame.data[2] = 0x40; // Motordrehzahl low (rpm x 0.25): 0x1F40 = 8000 -> 2000 rpm
  frame.data[3] = 0x1F; // Motordrehzahl high
  frame.data[4] = 0x20; // inneres_Motor_Moment_ohne_extern (not read by Gen4)
  frame.data[5] = 0x20; // Fahrpedalwert (pedal, 0.4 % per bit): 12.8 %
  frame.data[6] = 0x08; // mechanisches_Motor_Verlustmoment (loss torque)
  frame.data[7] = 0x20; // Fahrerwunschmoment (driver demand torque)
  standaloneTx(frame);
}

void Gen4_frames20()
{
  twai_message_t frame = {};
  // PQ Bremse_2 (0x5A0, DLC 8) - ESP/ABS sensor broadcast (vw_pq.dbc: Bremse_2).
  // Gen4 reads b0, b1.0, b3 bits 4-7, b6.6, b7.7 - not b4 (spec_gen4_0br §3).
  frame.identifier = BRAKES2_ID;
  frame.data_length_code = 8;
  frame.data[0] = 0x80;                                        // Impulszahl (pulse count)
  frame.data[1] = 0x7A;                                        // Wegimpulse_Vorderachse (front-axle path pulses)
  frame.data[2] = 0x05;                                        // mittlere_Raddrehzahl (mean wheel speed)
  frame.data[3] = BRAKES2_counter;                             // rolling counter (16-step)
  frame.data[4] = get_lock_target_adjusted_value(0x7F, false); // Querbeschleunigung (lateral G) - not read by Gen4, no effect
  frame.data[5] = 0xCA;                                        // Zeitstempel low (timestamp)
  frame.data[6] = 0x1B;                                        // Zeitstempel high
  frame.data[7] = 0xAB;                                        // status / reserved
  standaloneTx(frame);
  BRAKES2_counter = BRAKES2_counter + 16;
  if (BRAKES2_counter > 0xF0)
    BRAKES2_counter = 0;

  // ---- V11.00.0: frames the 0BR monitors that we never sent (spec_gen4_0br §3 / §7 #5).
  // Each has a 50-tick alive window in the unit; 20 ms is well inside it.
  // Content: K-matrix value tables (vw_pq.dbc) with steady, plausible values -
  // no PQ log of these frames was available.

  // PQ Motor_2 (0x288, DLC 8). Gen4 reads b0 (mux), b2.0 brake light, b2.1, b2.4.
  uint8_t motor2Byte2 = 0x10; // b2.4 MO2_Sta_No_Bet = 1: engine in normal operation
  if (brakeForHaldex())
  {
    motor2Byte2 = motor2Byte2 | (1 << 0); // b2.0 MO2_BLS: brake light on (Follow Brake)
  }
  frame.identifier = MOTOR2_ID;
  frame.data_length_code = 8;
  frame.data[0] = 0xDE;        // mux code 3 (bits 6-7) = MO2_max_Mo, data 0x1E x 10 = 300 Nm max engine torque
  frame.data[1] = 0xB8;        // MO2_Kuehlm_T coolant: 0xB8 x 0.75 - 48 = 90 degC (not read by Gen4)
  frame.data[2] = motor2Byte2; // b2.0 brake light, b2.1 brake test switch = 0 (spec §5), b2.4 normal operation
  frame.data[3] = 0x00;        // cruise control flags off
  frame.data[4] = 0x00;        // MO2_GRA_Soll: no cruise set speed
  frame.data[5] = 0x50;        // MO2_LL_Solldz: idle target 0x50 x 10 = 800 rpm
  frame.data[6] = 0xFE;        // MO2_Begr_Mo: no torque limit
  frame.data[7] = 0x00;        // MO2_Mo_ZWR
  standaloneTx(frame);

  // PQ Motor_5 (0x480, DLC 8). Must be present: without it the 0BR sets its own
  // limp bit (0x2C0 b0.4) - OEM code FUN_032880. Gen4 reads b0 (mux) and b6.3.
  frame.identifier = MOTOR5_ID;
  frame.data_length_code = 8;
  frame.data[0] = 0x1E; // mux code 0 (bits 6-7) = MO5_max_Moment, data 0x1E x 10 = 300 Nm (matches Motor_2)
  frame.data[1] = 0x00; // lamps off (glow, EPC, MIL, hot)
  frame.data[2] = 0x00; // MO5_Verbrauch low (fuel used)
  frame.data[3] = 0x00; // MO5_Verbrauch high
  frame.data[4] = 0x00; // MO5_Luefter: cooling fan 0 %
  frame.data[5] = 0x00; // lamps / start flags off
  frame.data[6] = 0x00; // b6.3 MO5_Momente = 0: torque figures single scale (spec §5)
  frame.data[7] = 0x00; // checksum (worked out below)
  for (uint8_t i = 0; i < 7; i++)
  {
    frame.data[7] ^= frame.data[i]; // XOR of bytes 0-6 (the 0BR copies only 7 bytes, so it never checks it)
  }
  standaloneTx(frame);

  // PQ Bremse_5 (0x4A8, DLC 8). Gen4 reads the yaw rate b0 + b1 bits 0-5
  // (0.01 deg/s), b1.6 status, b1.7 sign and the b6 counter (not checked).
  frame.identifier = BRAKES5_ID;
  frame.data_length_code = 8;
  frame.data[0] = 0x00;                            // BR5_Giergeschw low: yaw rate 0 (driving straight)
  frame.data[1] = 0x00;                            // yaw high bits 0-5 = 0, b1.6 status 0, b1.7 sign 0
  frame.data[2] = 0x00;                            // BR5_Bremsdruck low: brake pressure 0 (not read by Gen4)
  frame.data[3] = 0x00;                            // brake pressure high / status bits (not read by Gen4)
  frame.data[4] = 0x00;                            // hill-hold / brake light flags (not read by Gen4)
  frame.data[5] = 0x00;                            // not read by Gen4
  frame.data[6] = (uint8_t)(gen4Bremse5Counter << 4); // COUNTER in bits 4-7 (vw_pq.dbc 52|4)
  frame.data[7] = 0x00;                            // checksum (worked out below)
  for (uint8_t i = 0; i < 7; i++)
  {
    frame.data[7] ^= frame.data[i]; // XOR of bytes 0-6 (not copied by the 0BR, DLC 7)
  }
  standaloneTx(frame);
  gen4Bremse5Counter++;
  if (gen4Bremse5Counter > 0x0F)
    gen4Bremse5Counter = 0;

  // PQ Bremse_8 (0x1AC, DLC 8). Gen4 reads b1 bits 0-3 counter (not checked),
  // b1.4, b1.7 and b4.4; b0 checksum is not checked (spec_gen4_0br §3).
  frame.identifier = BRAKES8_ID;
  frame.data_length_code = 8;
  frame.data[0] = 0x00;                       // BR8_Checksumme (worked out below)
  frame.data[1] = gen4Bremse8Counter & 0x0F;  // BR8_Zaehler bits 0-3; b1.4 / b1.7 status flags = 0
  frame.data[2] = 0x7F;                       // BR8_TolAbgl_HL: 0x7F = 0 % tyre tolerance
  frame.data[3] = 0x7F;                       // BR8_TolAbgl_HR: 0x7F = 0 %
  frame.data[4] = 0x69;                       // BR8_Istbeschl low: 0x169 = 0 m/s2 (b4.4 = 0)
  frame.data[5] = 0x01;                       // BR8_Istbeschl high bit; brake-light / ESC flags 0
  frame.data[6] = 0x00;                       // BR8_Laengsbeschl low: 0x200 = 0 m/s2
  frame.data[7] = 0x02;                       // BR8_Laengsbeschl high bits; Quattro / EPB flags 0
  for (uint8_t i = 1; i < 8; i++)
  {
    frame.data[0] ^= frame.data[i]; // XOR of bytes 1-7 (not checked by the 0BR)
  }
  standaloneTx(frame);
  gen4Bremse8Counter++;
  if (gen4Bremse8Counter > 0x0F)
    gen4Bremse8Counter = 0;

  // PQ Getriebe_1 (0x440, DLC 8). Gen4 reads b1 bits 0-3 target gear, b2 wheel /
  // crank torque ratio (0.1 per bit) and b6 bits 4-7 (spec_gen4_0br §3).
  frame.identifier = mGetriebe_1;
  frame.data_length_code = 8;
  frame.data[0] = 0x00; // no shift running, no protection request
  frame.data[1] = 0x55; // GE1_Zielgang bits 0-3 = 5 (5th gear), GE1_Wahl_Pos bits 4-7 = 5 (D)
  frame.data[2] = 0x0A; // GE1_Mrad_Mkurb: ratio 0x0A x 0.1 = 1.0 (spec §5)
  frame.data[3] = 0x00; // GE1_Soll_Mo
  frame.data[4] = 0x7F; // GE1_Fahrwistd: 0x7F = 0 (neutral driving resistance)
  frame.data[5] = 0x00; // GE1_Notlauf 0 = no gearbox limp
  frame.data[6] = 0x00; // V11 TODO (bench): Gen4 reads b6 bits 4-7 (vw_pq.dbc: counter bits 3-6 + GE1_Fehlereintr bit 7) - sent as 0 = no gearbox fault; try a counter here if the unit logs a Getriebe_1 fault
  frame.data[7] = 0x00; // GE1_WaVerl_Mo
  standaloneTx(frame);
}

void Gen4_frames25()
{
  twai_message_t frame = {};
  // PQ Kombi_1 (0x320, DLC 8) - instrument-cluster broadcast (vw_pq.dbc: Kombi_1).
  // Gen4 reads b1.1 handbrake and b5 bits 0-3 (spec_gen4_0br §3).
  uint8_t kombi1Byte1 = 0x00; // b1.0 brake-fluid warning off, b1.1 handbrake released
  if (handbrakeForHaldex())
  {
    kombi1Byte1 = kombi1Byte1 | (1 << 1); // b1.1 KO1_Handbremse: handbrake pulled (Follow Handbrake)
  }
  frame.identifier = mKombi_1;
  frame.data_length_code = 8;
  frame.data[0] = 0x24;        // lamp bits (oil pressure / hot warning etc)
  frame.data[1] = kombi1Byte1; // Bremsinfo b1.0 + Handbremse b1.1 (V11: was always 0)
  frame.data[2] = 0x1D;        // Tankinhalt (fuel level, 29 l)
  frame.data[3] = 0xB9;        // b3.0 speed source, bits 1-7 Geschwindigkeit_Kombi_1 low (~9.9 km/h)
  frame.data[4] = 0x07;        // Geschwindigkeit_Kombi_1 high
  frame.data[5] = 0x42;        // b5 bits 0-3 read by Gen4; bits 6-7 = displayed speed low bits
  frame.data[6] = 0x09;        // Angezeigte_Geschwindigkeit (displayed speed) high bits
  frame.data[7] = 0x81;        // spare
  standaloneTx(frame);

  // PQ Kombi_3 (0x520, DLC 8) - cluster odometer/keys (vw_pq.dbc: Kombi_3).
  frame.identifier = mKombi_3;
  frame.data_length_code = 8;
  frame.data[0] = 0x60; // Kilometerstand low (odometer, km)
  frame.data[1] = 0x43; // Kilometerstand mid
  frame.data[2] = 0x01; // Kilometerstand high
  frame.data[3] = 0x10; // Standzeit low (stand time, sec)
  frame.data[4] = 0x66; // Standzeit high
  frame.data[5] = 0xF1; // Schluesselinfo (key info)
  frame.data[6] = 0x03; // Kombi_Multiplex_Code
  frame.data[7] = 0x02; // Kombi_Multiplex_Generation
  standaloneTx(frame);
}

void Gen4_frames100()
{
  twai_message_t frame = {};
  // PQ Gate_Komf_1 (0x390, DLC 8) - gateway-comfort broadcast (vw_pq.dbc: Gate_Komf_1).
  // Gen4 reads only b3.4 GK1_Rueckfahr (reverse) - spec_gen4_0br §3.
  frame.identifier = mGate_Komf_1;
  frame.data_length_code = 8;
  frame.data[0] = 0x03; // GK1_Sta_Anhaen / door & light status bits
  frame.data[1] = 0x11; // GK1_Blinker_li / re (indicators)
  frame.data[2] = 0x58; // alarm / light bits
  frame.data[3] = 0x00; // b3.4 GK1_Rueckfahr = 0: not reversing (the only bit Gen4 reads)
  frame.data[4] = 0x40; // seat-memory / sunroof bits
  frame.data[5] = 0x00; // alarm / lock bits
  frame.data[6] = 0x01; // status
  frame.data[7] = 0x08; // status / counter
  standaloneTx(frame);

  // PQ Bremse_11 (0x5B7, DLC 8) - extended brake frame (NOT in vw_pq.dbc).
  // Not in the Gen4 0BR receive table at all - the unit ignores it (spec_gen4_0br
  // §3), so its block is OFF in the V11 standalone default (same for Kombi_2).
  frame.identifier = BRAKES11_ID;
  frame.data_length_code = 8;
  frame.data[0] = 0x00; // no effect
  frame.data[1] = 0XC0; // mode/status (only byte that matters)
  frame.data[2] = 0x00; // no effect
  frame.data[3] = 0x00; // no effect
  frame.data[4] = 0x00; // no effect
  frame.data[5] = 0x00; // no effect
  frame.data[6] = 0x00; // no effect
  frame.data[7] = 0x00; // no effect
  standaloneTx(frame);
}

void Gen4_frames200()
{
  twai_message_t frame = {};
  // PQ Kombi_2 (0x420, DLC 8) - cluster temps (vw_pq.dbc: Kombi_2).
  frame.identifier = mKombi_2;
  frame.data_length_code = 8;
  frame.data[0] = 0x4C; // Kuehlmitteltemp (coolant * 0.75 - 48 degC)
  frame.data[1] = 0x86; // Oeltemperatur (oil temp)
  frame.data[2] = 0x85; // Aussentemperatur_gefiltert (outside-air filtered)
  frame.data[3] = 0x00; // Aussentemperatur_ungefiltert (outside-air raw)
  frame.data[4] = 0x00; // reserved
  frame.data[5] = 0x30; // status
  frame.data[6] = 0xFF; // reserved
  frame.data[7] = 0x04; // reserved / counter
  standaloneTx(frame);
}

void Gen4_frames1000()
{
  twai_message_t frame = {};
  // PQ Diagnose_1 (0x7D0, DLC 8) - diagnostic timestamp broadcast (vw_pq.dbc: Diagnose_1).
  frame.identifier = mDiagnose_1;
  frame.data_length_code = 8;
  frame.data[0] = 0x26;                // DI1_VerlernZaehl (relearn counter)
  frame.data[1] = 0xF2;                // DI1_km_Stand low (odometer)
  frame.data[2] = 0x03;                // DI1_km_Stand mid
  frame.data[3] = 0x12;                // DI1_km_Stand high / DI1_Jahr (year)
  frame.data[4] = 0x70;                // DI1_Monat (month) / DI1_Tag (day)
  frame.data[5] = 0x19;                // DI1_Stunde (hour)
  frame.data[6] = 0x25;                // DI1_Minute (minute)
  frame.data[7] = mDiagnose_1_counter; // DI1_Sekunde (sec) / rolling counter
  standaloneTx(frame);
  mDiagnose_1_counter++;
  if (mDiagnose_1_counter > 0x1F)
    mDiagnose_1_counter = 0;
}

static void frames13()
{
  switch (haldexGeneration)
  {
  case 41:
    Gen41_frames13();
    break;
  case GEN_VOLVO_P1:
    VolvoP1_frames13(); // the P1's 14-15 ms frames
    break;
  }
}

static void frames50()
{
  switch (haldexGeneration)
  {
  case 41:
    Gen41_frames50();
    break;
  case GEN_VOLVO_P1:
    VolvoP1_frames50();
    break;
  }
}

static void frames250()
{
  switch (haldexGeneration)
  {
  case 41:
    Gen41_frames250();
    break;
  }
}

// Gen4.1 dual-bus: repeat the cached chassis 0x0C1 / 0x0C5 frames onto bus 0.
static void gen41Bus0Frames20()
{
  if (haldexGeneration != 41)
    return;

  extern twai_message_t gen41_bus0_cache_c1;
  extern twai_message_t gen41_bus0_cache_c5;
  extern bool gen41_bus0_cache_valid_c1;
  extern bool gen41_bus0_cache_valid_c5;
  extern portMUX_TYPE gen41_bus0_cache_mux;

  twai_message_t c1, c5;
  bool has_c1, has_c5;
  taskENTER_CRITICAL(&gen41_bus0_cache_mux);
  has_c1 = gen41_bus0_cache_valid_c1;
  has_c5 = gen41_bus0_cache_valid_c5;
  if (has_c1)
    c1 = gen41_bus0_cache_c1;
  if (has_c5)
    c5 = gen41_bus0_cache_c5;
  taskEXIT_CRITICAL(&gen41_bus0_cache_mux);

  if (has_c1)
    twai_transmit_v2(twai_bus_0, &c1, 0);
  if (has_c5)
    twai_transmit_v2(twai_bus_0, &c5, 0);
}

// One task drives every standalone rate. These used to be ten tasks (one per
// rate, plus the Gen4.1 bus-0 repeater), each with its own stack and all of them
// held suspended for an entire OEM-mode drive; as one task they give ~23 KB back
// to the C6's shared SRAM (WiFi + BLE + web server). Buckets are listed in the
// old task-priority order, so a tick due for several rates sends them in the
// same order as before. Every TX is non-blocking, so no bucket stalls the rest.
void standaloneFramesTask(void *arg)
{
  struct Bucket
  {
    uint16_t periodMs;
    void (*run)();
    uint32_t dueMs;
  };
  Bucket buckets[] = {
      {10, frames10, 0},
      {13, frames13, 0},
      {20, gen41Bus0Frames20, 0},
      {20, frames20, 0},
      {25, frames25, 0},
      {50, frames50, 0},
      {100, frames100, 0},
      {200, frames200, 0},
      {250, frames250, 0},
      {1000, frames1000, 0},
  };

  while (1)
  {
    // Analyzer mode runs as a passive bridge; skip standalone frame generation.
    if (analyzerMode || !isStandalone)
    {
      vTaskDelay(10 / portTICK_PERIOD_MS);
      continue;
    }

    const uint32_t now = millis();
    for (Bucket &b : buckets)
    {
      if ((int32_t)(now - b.dueMs) < 0)
        continue;
      b.run();
      b.dueMs += b.periodMs;
      if ((int32_t)(now - b.dueMs) >= 0) // first run, or back from suspend / analyzer: restart the cadence, don't burst
        b.dueMs = now + b.periodMs;
    }

    vTaskDelay(1); // one tick
  }
}

// Gen4.1 (GM/SAAB) Standalone Frames
// VIN: W0LGS8EF2B1064055  (digits 10..17 = "B1064055")
//
// Simulation scenario: bench test simulating a running car at high load.
//   Driven (front) wheels:     ~20 km/h
//   Non-driven (rear) wheels:  ~15 km/h
//   Engine:                    2000 rpm, running, high torque, ~80% pedal override
//   Brakes / handbrake:        OFF
//   Steering angle:            0 deg (straight), Calibrated
//   Ignition:                  Run (Run/Crank active)
//   Transmission:              D, 3rd gear, TCC Locked, Engaged Forward
//   Validity bits:             0 = Valid  (REMINDER: 1 = Invalid)
//   Virtual Device Avail bits: 1 = Available
//
// Wheel pulse model: 30 mm per pulse, 2 us per timestamp tick.
//   Driven     ~20 km/h -> +4 pulses, +10800 ticks per 10 ms
//   Non-driven ~15 km/h -> +3 pulses, +10800 ticks per 10 ms
//   Sequence Number shared L/R per packet (spec: samples within 0.5 ms).
//   Timestamp Rollover Counter increments each time the 16-bit timestamp wraps.
//   Reset Occurred held True for ~200 ms after power-up, then cleared.
//
// Bucket mapping (spec rate -> scheduler bucket):
//   10 ms:   0x0C1, 0x0C5, 0x0F1, 0x180 (Bus1 SAS), 0x0C9 (spec 12.5ms)
//   20 ms:   0x1CE, 0x1E9, 0x1F5 (spec 25ms)
//   25 ms:   0x2F9 (spec 50ms)
//   100 ms:  0x1F1
//   200 ms:  0x3F1 (spec 250ms), 0x4C1 (spec 500ms)
//   1000 ms: 0x4E1, 0x120 Bus0 (Vehicle_Odometer_HS)
//
// RX (received from Haldex / other modules, not transmitted):
//   0x1CC - Secondary Axle Status
//   0x1CF - Secondary Axle General Information
//   0x1D0 - Front Axle Status
//   0x1D1 - Rear Axle Status

// --- Gen41 simulation state (shared across the 10 ms frames) ---
static uint8_t gen41_seq = 0;          // 2-bit sequence number, same L/R per packet
static uint16_t gen41_frame10_cnt = 0; // frames since power-up (10 ms bucket)

// Driven (front) wheels - ~20 km/h
static uint16_t gen41_drv_l_pulse = 0;
static uint16_t gen41_drv_r_pulse = 0;
static uint16_t gen41_drv_l_ts = 0;
static uint16_t gen41_drv_r_ts = 0;
static uint8_t gen41_drv_l_roll = 0;
static uint8_t gen41_drv_r_roll = 0;

// Non-driven (rear) wheels - ~15 km/h
static uint16_t gen41_ndrv_l_pulse = 0;
static uint16_t gen41_ndrv_r_pulse = 0;
static uint16_t gen41_ndrv_l_ts = 0;
static uint16_t gen41_ndrv_r_ts = 0;
static uint8_t gen41_ndrv_l_roll = 0;
static uint8_t gen41_ndrv_r_roll = 0;

// Alive Rolling Counts (2-bit) per message
static uint8_t gen41_throttle_arc = 0; // 0x0C9 Driver Throttle Override Detection ARC
static uint8_t gen41_brake_arc = 0;    // 0x0F1 Brake Pedal Position ARC
static uint8_t gen41_1e9_counter = 0;  // 0x1E9 4-step rolling counter: B6=(ctr<<5)

struct Gen41ReplayState
{
  uint8_t step;
  uint8_t mask;
};

static inline uint8_t gen41_take_replay_index(Gen41ReplayState &state)
{
  const uint8_t idx = static_cast<uint8_t>(state.step & state.mask);
  state.step = static_cast<uint8_t>((state.step + 1U) & state.mask);
  return idx;
}

static Gen41ReplayState gen41_130_state = {0U, 0x03U};
static Gen41ReplayState gen41_330_state = {0U, 0x07U};
static Gen41ReplayState gen41_2c3_state = {0U, 0x03U};
static Gen41ReplayState gen41_230_state = {0U, 0x07U};

// 0x230 (Bus0) — 8-state synchronized replay table covering 86% of OEM frames.
static const uint8_t gen41_230_b1[8] = {0x00, 0x10, 0x00, 0x10, 0x00, 0x10, 0x00, 0x10};
static const uint8_t gen41_230_b2[8] = {0x00, 0x01, 0x10, 0x11, 0x20, 0x21, 0x30, 0x31};
static const uint8_t gen41_230_b3[8] = {0x80, 0x00, 0x80, 0x00, 0x80, 0x00, 0x80, 0x00};
static const uint8_t gen41_230_b6[8] = {0x00, 0x00, 0x1F, 0x1F, 0x1F, 0x1F, 0x1F, 0x1F};
static const uint8_t gen41_230_b7[8] = {0x00, 0x00, 0xFF, 0xFF, 0xFE, 0xFE, 0xFD, 0xFD};

// 0x130 (Bus1) - Multi-axis inertial sensor. Checksum = sum(D0..D5) + 0x26 (D6 excluded).
static const uint8_t gen41_130_bus1_tbl[4][8] = {
    {0x00, 0x0E, 0x10, 0x03, 0xFF, 0x20, 0x09, 0x6E},
    {0x20, 0x0F, 0x10, 0x03, 0xFF, 0x40, 0x09, 0xAF},
    {0x40, 0x10, 0x10, 0x03, 0xFF, 0xC0, 0x0A, 0x50},
    {0x60, 0x11, 0x10, 0x00, 0x00, 0x20, 0x08, 0xCF},
};

// 0x330 Bus1: two 12-bit signed acceleration-like values in D0:D1 and D2:D3.
static const uint8_t gen41_330_bus1_tbl[8][4] = {
    {0x00, 0x00, 0x00, 0x00},
    {0x00, 0x00, 0x0F, 0xFD},
    {0x00, 0x00, 0x00, 0x00},
    {0x00, 0x00, 0x00, 0x03},
    {0x00, 0x00, 0x00, 0x00},
    {0x00, 0x03, 0x00, 0x00},
    {0x00, 0x00, 0x00, 0x00},
    {0x0F, 0xFD, 0x00, 0x00},
};

static const uint16_t gen41_2c3_wheel_speed_tbl[4] = {
    0x0A8C,
    0x0A8A,
    0x0A8E,
    0x0A8C,
};

static volatile uint16_t gen41_last_wheel_speed_2c3 = 0x0A8C;

// Bus0 mirrors these from Bus1 payload generation with dedicated per-ID timing.
portMUX_TYPE gen41_bus0_cache_mux = portMUX_INITIALIZER_UNLOCKED;
twai_message_t gen41_bus0_cache_c1;
twai_message_t gen41_bus0_cache_c5;
bool gen41_bus0_cache_valid_c1 = false;
bool gen41_bus0_cache_valid_c5 = false;

// 0x1E5 PPEI Steering Wheel Angle (GMW8762, DLC=8, 10 ms cadence)
static int16_t gen41_swa_angle_raw = 1;
static uint8_t gen41_swa_arc = 0;
static uint8_t gen41_swa_phase = 0;

static constexpr int16_t kSwaRateWobble[8] = {0, +2, 0, -3, 0, +2, +4, -5};
static constexpr uint8_t kSwaAgeBus0[4] = {0x02, 0x02, 0x03, 0x01};
static constexpr uint8_t kSwaAgeBus1[4] = {0xFB, 0xFB, 0xFC, 0xFA};

static inline void gen41_swa_advance_wobble()
{
  gen41_swa_phase++;
  if ((gen41_swa_phase & 0x07U) == 0U)
  {
    if (gen41_swa_phase & 0x08U)
      gen41_swa_angle_raw++;
    else
      gen41_swa_angle_raw--;
  }
  gen41_swa_arc = static_cast<uint8_t>((gen41_swa_arc + 1U) & 0x03U);
}

static void gen41_build_1e5(twai_message_t &frame, bool bus1)
{
  const uint16_t angle_bits = static_cast<uint16_t>(gen41_swa_angle_raw);
  const int16_t rate = kSwaRateWobble[gen41_swa_phase & 0x07U];
  const uint16_t rate_bits = static_cast<uint16_t>(rate) & 0x0FFFU;

  const uint8_t status = bus1 ? 0x4FU : 0x4CU;
  const uint8_t marker = bus1 ? 0xFFU : 0x00U;
  const uint8_t epv_k = bus1 ? 0x5BU : 0x5DU;
  const uint8_t age = bus1 ? kSwaAgeBus1[gen41_swa_phase & 0x03U]
                           : kSwaAgeBus0[gen41_swa_phase & 0x03U];

  frame.identifier = 0x1E5;
  frame.extd = 0;
  frame.rtr = 0;
  frame.data_length_code = 8;

  frame.data[0] = status;
  frame.data[1] = static_cast<uint8_t>((angle_bits >> 8) & 0xFFU);
  frame.data[2] = static_cast<uint8_t>(angle_bits & 0xFFU);
  frame.data[3] = static_cast<uint8_t>(((gen41_swa_arc & 0x03U) << 5) | 0x10U | ((rate_bits >> 8) & 0x0FU));
  frame.data[4] = static_cast<uint8_t>(rate_bits & 0xFFU);
  frame.data[5] = marker;
  frame.data[6] = age;
  frame.data[7] = static_cast<uint8_t>(frame.data[0] + frame.data[1] + frame.data[2] + frame.data[3] + frame.data[4] + frame.data[5] + epv_k);
}

static void gen41_build_180(twai_message_t &frame)
{
  const uint16_t angle_bits = static_cast<uint16_t>(gen41_swa_angle_raw);
  const int16_t rate = kSwaRateWobble[gen41_swa_phase & 0x07U];
  const uint16_t rate_bits = static_cast<uint16_t>(rate) & 0x0FFFU;
  const uint8_t arc = gen41_swa_arc & 0x03U;
  const uint8_t d2 = static_cast<uint8_t>(angle_bits & 0xFFU);

  frame.identifier = 0x180;
  frame.extd = 0;
  frame.rtr = 0;
  frame.data_length_code = 8;

  frame.data[0] = 0x4EU;
  frame.data[1] = static_cast<uint8_t>((angle_bits >> 8) & 0xFFU);
  frame.data[2] = d2;
  frame.data[3] = static_cast<uint8_t>(0x80U | (arc << 5) | ((rate_bits >> 8) & 0x0FU));
  frame.data[4] = static_cast<uint8_t>(rate_bits & 0xFFU);
  frame.data[5] = 0xFFU;
  frame.data[6] = static_cast<uint8_t>((0U - d2 - arc) & 0xFFU);
  frame.data[7] = 0x00U;
}

static inline bool gen41_periodic_due(uint32_t &last_ms,
                                      uint32_t now_ms,
                                      uint32_t period_ms,
                                      uint32_t first_delay_ms)
{
  if (last_ms == 0U)
  {
    if (now_ms < first_delay_ms)
    {
      return false;
    }
    last_ms = now_ms;
    return true;
  }

  if ((now_ms - last_ms) < period_ms)
  {
    return false;
  }

  last_ms = now_ms;
  return true;
}

void gen41_step_wheel(uint16_t &pulse, uint16_t &ts, uint8_t &roll,
                      uint16_t pulse_inc, uint16_t ts_inc)
{
  pulse = (uint16_t)((pulse + pulse_inc) & 0x3FF);
  uint32_t new_ts = (uint32_t)ts + (uint32_t)ts_inc;
  if (new_ts > 0xFFFF)
  {
    roll = (uint8_t)((roll + 1) & 0x3);
  }
  ts = (uint16_t)(new_ts & 0xFFFF);
}

static inline uint8_t gen41_wheel_status_byte(uint8_t roll, uint8_t seq,
                                              uint8_t reset_occurred,
                                              uint16_t pulse)
{
  return (uint8_t)(((roll & 0x3) << 6) |
                   ((seq & 0x3) << 4) |
                   ((reset_occurred & 0x1) << 3) |
                   ((pulse >> 8) & 0x3));
}

void Gen41_frames10()
{
  twai_message_t frame = {};
  frame.extd = 0;
  frame.rtr = 0;

  const uint16_t spd_mod = 15;
  gen41_step_wheel(gen41_drv_l_pulse, gen41_drv_l_ts, gen41_drv_l_roll, 2, (uint16_t)(13000 + spd_mod * 100));
  gen41_step_wheel(gen41_drv_r_pulse, gen41_drv_r_ts, gen41_drv_r_roll, 2, (uint16_t)(13000 + spd_mod * 100));
  gen41_step_wheel(gen41_ndrv_l_pulse, gen41_ndrv_l_ts, gen41_ndrv_l_roll, 2, (uint16_t)(12000 + spd_mod * 100));
  gen41_step_wheel(gen41_ndrv_r_pulse, gen41_ndrv_r_ts, gen41_ndrv_r_roll, 2, (uint16_t)(12000 + spd_mod * 100));

  const uint8_t reset_occ = 0;
  const uint8_t seq = gen41_seq;

  // 0x0C1 - PPEI Driven Wheel Rotational Status (10 ms), EBCM TX
  frame.identifier = 0x0C1;
  frame.data_length_code = 8;
  frame.data[0] = gen41_wheel_status_byte(gen41_drv_l_roll, seq, reset_occ, gen41_drv_l_pulse);
  frame.data[1] = (uint8_t)(gen41_drv_l_pulse & 0xFF);
  frame.data[2] = (uint8_t)((gen41_drv_l_ts >> 8) & 0xFF);
  frame.data[3] = (uint8_t)(gen41_drv_l_ts & 0xFF);
  frame.data[4] = gen41_wheel_status_byte(gen41_drv_r_roll, seq, reset_occ, gen41_drv_r_pulse);
  frame.data[5] = (uint8_t)(gen41_drv_r_pulse & 0xFF);
  frame.data[6] = (uint8_t)((gen41_drv_r_ts >> 8) & 0xFF);
  frame.data[7] = (uint8_t)(gen41_drv_r_ts & 0xFF);
  taskENTER_CRITICAL(&gen41_bus0_cache_mux);
  gen41_bus0_cache_c1 = frame;
  gen41_bus0_cache_valid_c1 = true;
  taskEXIT_CRITICAL(&gen41_bus0_cache_mux);
  standaloneTx(frame);

  // 0x0C5 - PPEI Non Driven Wheel Rotational Status (10 ms), EBCM TX
  frame.identifier = 0x0C5;
  frame.data_length_code = 8;
  frame.data[0] = gen41_wheel_status_byte(gen41_ndrv_l_roll, seq, reset_occ, gen41_ndrv_l_pulse);
  frame.data[1] = (uint8_t)(gen41_ndrv_l_pulse & 0xFF);
  frame.data[2] = (uint8_t)((gen41_ndrv_l_ts >> 8) & 0xFF);
  frame.data[3] = (uint8_t)(gen41_ndrv_l_ts & 0xFF);
  frame.data[4] = gen41_wheel_status_byte(gen41_ndrv_r_roll, seq, reset_occ, gen41_ndrv_r_pulse);
  frame.data[5] = (uint8_t)(gen41_ndrv_r_pulse & 0xFF);
  frame.data[6] = (uint8_t)((gen41_ndrv_r_ts >> 8) & 0xFF);
  frame.data[7] = (uint8_t)(gen41_ndrv_r_ts & 0xFF);
  taskENTER_CRITICAL(&gen41_bus0_cache_mux);
  gen41_bus0_cache_c5 = frame;
  gen41_bus0_cache_valid_c5 = true;
  taskEXIT_CRITICAL(&gen41_bus0_cache_mux);
  standaloneTx(frame);

  // 0x0C9 - PPEI Engine General Status 1 (spec 12.5 ms), ECM TX
  frame.identifier = 0x0C9;
  frame.data_length_code = 8;
  frame.data[0] = 0x80;
  frame.data[1] = get_lock_target_adjusted_value(0x1F, false);
  frame.data[2] = get_lock_target_adjusted_value(0x40, false);
  {
    const uint8_t t_arc = gen41_throttle_arc & 0x3U;
    const uint8_t t_sig = 1U;
    const uint8_t t_pv = static_cast<uint8_t>((~(t_sig + t_arc) + 1U) & 0x3U);
    frame.data[3] = static_cast<uint8_t>(0x10U | (t_arc << 2U) | t_pv);
  }
  frame.data[4] = 0xFE;
  frame.data[5] = 0x00;
  frame.data[6] = 0x00;
  frame.data[7] = 0x64;
  twai_transmit_v2(twai_bus_0, &frame, 0);
  gen41_throttle_arc = (uint8_t)((gen41_throttle_arc + 1) & 0x3);

  // 0x0F1 - PPEI Brake Apply Status (10 ms), BSM TX
  frame.identifier = 0x0F1;
  frame.data_length_code = 6;
  {
    const uint8_t b_arc = gen41_brake_arc & 0x3U;
    const uint8_t b_sig = 0U;
    const uint8_t b_pv = static_cast<uint8_t>((~(b_sig + b_arc) + 1U) & 0x3U);
    frame.data[0] = static_cast<uint8_t>((b_arc << 4U) | (b_pv << 2U));
  }
  frame.data[1] = 0x00;
  frame.data[2] = 0x00;
  frame.data[3] = 0x40;
  frame.data[4] = 0x00;
  frame.data[5] = 0x00;
  twai_transmit_v2(twai_bus_0, &frame, 0);
  gen41_brake_arc = (uint8_t)((gen41_brake_arc + 1) & 0x3);

  gen41_seq = (uint8_t)((gen41_seq + 1) & 0x3);
  if (gen41_frame10_cnt < 0xFFFF)
    gen41_frame10_cnt++;

  // 0x130 (Bus1) - Multi-axis inertial sensor (~10-13 ms cadence)
  {
    frame.identifier = 0x130;
    frame.extd = 0;
    frame.rtr = 0;
    frame.data_length_code = 8;
    const uint8_t idx = gen41_take_replay_index(gen41_130_state);
    const uint8_t *r130 = gen41_130_bus1_tbl[idx];
    for (uint8_t i = 0U; i < 8U; i++)
    {
      frame.data[i] = r130[i];
    }
    standaloneTx(frame);
  }

  // 0x140 (Bus1) - Chassis Inertial Sensor (Yaw Rate), ~10 ms cadence
  {
    static uint8_t gen41_140_counter = 0U;
    const uint8_t d0 = (uint8_t)(0x80U | ((gen41_140_counter & 0x03U) << 2));
    const uint8_t d5 = 0xDAU;
    const uint8_t d7 = (uint8_t)((d0 + d5 + 0x37U) & 0xFFU);
    frame.identifier = 0x140;
    frame.extd = 0;
    frame.rtr = 0;
    frame.data_length_code = 8;
    frame.data[0] = d0;
    frame.data[1] = 0x00;
    frame.data[2] = 0x00;
    frame.data[3] = 0x00;
    frame.data[4] = 0x0F;
    frame.data[5] = d5;
    frame.data[6] = 0x01;
    frame.data[7] = d7;
    standaloneTx(frame);
    gen41_140_counter = (gen41_140_counter + 1U) & 0x03U;
  }
}

void Gen41_frames20()
{
  uint8_t step = static_cast<uint8_t>(Gen41_1CE234_counter & 0x03);
  uint8_t d4_common = (step == 0) ? 0x00 : static_cast<uint8_t>(0x100 - step);

  twai_message_t frame = {};
  frame.extd = 0;
  frame.rtr = 0;

  // 0x1CE (Bus1) - PPEI Secondary Axle Torque Request (GMW8762, EBCM TX, 20 ms)
  {
    const uint8_t arc = static_cast<uint8_t>(step & 0x03U);
    const float req_nm = g_1ce_torque_request_nm;
    const bool requesting = (req_nm > 0.0f);
    const float scaled = req_nm / 4.0f + 0.5f;
    const uint8_t d1 = requesting
                           ? static_cast<uint8_t>(scaled >= 255.0f ? 255U : static_cast<uint8_t>(scaled))
                           : 0x00U;
    const uint8_t d0 = static_cast<uint8_t>((arc << 3) | (requesting ? 0x04U : 0x00U));
    const uint8_t d2 = requesting ? 0x03U : (arc == 0U ? 0x00U : 0x07U);
    const uint8_t d3 = static_cast<uint8_t>((0U - arc - d1) & 0xFFU);
    frame.identifier = 0x1CE;
    frame.data_length_code = 8;
    frame.data[0] = d0;
    frame.data[1] = d1;
    frame.data[2] = d2;
    frame.data[3] = d3;
    frame.data[4] = 0x00;
    frame.data[5] = 0x00;
    frame.data[6] = 0x00;
    frame.data[7] = 0x00;
    standaloneTx(frame);
  }

  // 0x1E9 - PPEI Chassis General Status 1 (20 ms), EBCM TX
  frame.identifier = 0x1E9;
  frame.data_length_code = 8;
  frame.data[0] = 0x0F;
  frame.data[1] = 0xFC;
  frame.data[2] = 0x00;
  frame.data[3] = 0x0E;
  frame.data[4] = 0x80;
  frame.data[5] = 0x06;
  frame.data[6] = static_cast<uint8_t>(gen41_1e9_counter << 5);
  frame.data[7] = 0x00;
  twai_transmit_v2(twai_bus_0, &frame, 0);
  gen41_1e9_counter = static_cast<uint8_t>((gen41_1e9_counter + 1U) & 0x03U);

  // 0x1F5 - PPEI Transmission General Status 2 (spec 25 ms), TCM TX
  frame.identifier = 0x1F5;
  frame.data_length_code = 8;
  frame.data[0] = 0xE2;
  frame.data[1] = 0x03;
  frame.data[2] = 0x00;
  frame.data[3] = 0x0F;
  frame.data[4] = 0x00;
  frame.data[5] = 0x00;
  frame.data[6] = 0x01;
  frame.data[7] = 0x0F;
  twai_transmit_v2(twai_bus_0, &frame, 0);

  // 0x234 (Bus1) - Insignia-specific rolling counter frame
  frame.identifier = 0x234;
  frame.extd = 0;
  frame.rtr = 0;
  frame.data_length_code = 4;
  {
    uint8_t d1_234 = static_cast<uint8_t>(0x04 + (step << 4));
    frame.data[0] = d1_234;
    frame.data[1] = 0x00;
    frame.data[2] = static_cast<uint8_t>(step == 0 ? 0x0C : 0x0B);
    frame.data[3] = d4_common;
  }
  {
    Gen41_1CE234_counter = (Gen41_1CE234_counter + 1) & 0x03;
  }
  standaloneTx(frame);
}

void Gen41_frames25()
{
  twai_message_t frame = {};
  frame.extd = 0;
  frame.rtr = 0;

  // 0x2F9 - PPEI Chassis General Status 2 (spec 50 ms), EBCM TX
  {
    static uint8_t gen41_2f9_counter = 0;
    frame.identifier = 0x2F9;
    frame.data_length_code = 7;
    frame.data[0] = static_cast<uint8_t>((gen41_2f9_counter << 3) | (gen41_2f9_counter < 16U ? 0x03U : 0x00U));
    frame.data[1] = 0x01;
    frame.data[2] = 0x10;
    frame.data[3] = 0x00;
    frame.data[4] = 0x00;
    frame.data[5] = 0x00;
    frame.data[6] = 0x00;
    twai_transmit_v2(twai_bus_0, &frame, 0);
    gen41_2f9_counter = static_cast<uint8_t>((gen41_2f9_counter + 1U) & 0x1FU);
  }

  // 0x1C3 (Bus0) — GMW8762 "PPEI Engine Torque Status 2" (25ms), ECM TX
  frame.identifier = 0x1C3;
  frame.extd = 0;
  frame.rtr = 0;
  frame.data_length_code = 8;
  frame.data[0] = get_lock_target_adjusted_value(0x2E, true) + 0x1A;
  frame.data[1] = 0x51;
  frame.data[2] = 0x06;
  frame.data[3] = 0x51;
  frame.data[4] = 0x00;
  frame.data[5] = 0x00;
  frame.data[6] = 0xFE;
  frame.data[7] = tempCounter;
  twai_transmit_v2(twai_bus_0, &frame, 0);

  // 0x191 (Bus0) - EngineData, OEM 23ms cadence
  frame.identifier = 0x191;
  frame.extd = 0;
  frame.rtr = 0;
  frame.data_length_code = 8;
  frame.data[0] = 0x06;
  frame.data[1] = 0xAA;
  frame.data[2] = 0x08;
  frame.data[3] = 0xCA;
  frame.data[4] = 0x06;
  frame.data[5] = 0xAA;
  frame.data[6] = 0x00;
  frame.data[7] = 0x17;
  twai_transmit_v2(twai_bus_0, &frame, 0);

  // 0x1C5 (Bus0) - PPEI Driver Intended Axle Torque Status (spec 25ms), ECM TX
  {
    frame.identifier = 0x1C5;
    frame.extd = 0;
    frame.rtr = 0;
    frame.data_length_code = 8;
    frame.data[0] = 0x2E;
    frame.data[1] = 0x91;
    frame.data[2] = 0x2B;
    frame.data[3] = 0x66;
    frame.data[4] = 0x2F;
    frame.data[5] = 0xAF;
    frame.data[6] = 0x00;
    frame.data[7] = 0x00;
    twai_transmit_v2(twai_bus_0, &frame, 0);
  }

  // 0x330 (Bus1) - Insignia inertial/accel sensor, OEM ~25-30ms cadence
  {
    frame.identifier = 0x330;
    frame.extd = 0;
    frame.rtr = 0;
    frame.data_length_code = 8;
    const uint8_t idx = gen41_take_replay_index(gen41_330_state);
    const uint8_t *r330 = gen41_330_bus1_tbl[idx];
    frame.data[0] = r330[0];
    frame.data[1] = r330[1];
    frame.data[2] = r330[2];
    frame.data[3] = r330[3];
    frame.data[4] = 0x00;
    frame.data[5] = 0x00;
    frame.data[6] = 0x00;
    frame.data[7] = 0x00;
    standaloneTx(frame);
  }
}

void Gen41_frames100()
{
  twai_message_t frame = {};
  frame.extd = 0;
  frame.rtr = 0;

  // 0x230 (Bus0) — OEM 96 ms cadence. 8-state synchronized replay table.
  {
    const uint8_t idx = gen41_take_replay_index(gen41_230_state);
    frame.identifier = 0x230;
    frame.data_length_code = 8;
    frame.data[0] = 0x00;
    frame.data[1] = gen41_230_b1[idx];
    frame.data[2] = gen41_230_b2[idx];
    frame.data[3] = gen41_230_b3[idx];
    frame.data[4] = 0x00;
    frame.data[5] = 0x00;
    frame.data[6] = gen41_230_b6[idx];
    frame.data[7] = gen41_230_b7[idx];
    twai_transmit_v2(twai_bus_0, &frame, 0);
  }

  // 0x348 (Bus0) — OEM 101 ms cadence. DLC=5.
  frame.identifier = 0x348;
  frame.data_length_code = 5;
  frame.data[0] = 0x00;
  frame.data[1] = 0x00;
  frame.data[2] = 0x00;
  frame.data[3] = 0x00;
  frame.data[4] = 0x1B;
  twai_transmit_v2(twai_bus_0, &frame, 0);

  // 0x34A (Bus0) — OEM 103 ms cadence. DLC=5.
  frame.identifier = 0x34A;
  frame.data_length_code = 5;
  frame.data[0] = 0x00;
  frame.data[1] = 0x00;
  frame.data[2] = 0x00;
  frame.data[3] = 0x00;
  frame.data[4] = 0x1B;
  twai_transmit_v2(twai_bus_0, &frame, 0);

  // 0x1F1 - PPEI Platform General Status (100 ms), BCM/GW TX
  frame.identifier = 0x1F1;
  frame.data_length_code = 8;
  frame.data[0] = 0xAE;
  frame.data[1] = 0x0A;
  frame.data[2] = 0x00;
  frame.data[3] = 0x00;
  frame.data[4] = 0x08;
  frame.data[5] = 0x00;
  frame.data[6] = 0x00;
  frame.data[7] = 0x7A;
  twai_transmit_v2(twai_bus_0, &frame, 0);

  // 0x17D (Bus0) — GMW8762 "Antilock_Brake_and_TC_Status_HS" (100ms), EBCM TX
  frame.identifier = 0x17D;
  frame.extd = 0;
  frame.rtr = 0;
  frame.data_length_code = 6;
  frame.data[0] = 0x22;
  frame.data[1] = 0x24;
  frame.data[2] = 0x42;
  frame.data[3] = 0xFF;
  frame.data[4] = 0x00;
  frame.data[5] = 0x00;
  twai_transmit_v2(twai_bus_0, &frame, 0);
}

void Gen41_frames200()
{
  twai_message_t frame = {};
  frame.extd = 0;
  frame.rtr = 0;

  // 0x12A (Bus0) - BCMDoorBeltStatus
  frame.identifier = 0x12A;
  frame.extd = 0;
  frame.rtr = 0;
  frame.data_length_code = 8;
  frame.data[0] = 0x00;
  frame.data[1] = 0x20;
  frame.data[2] = 0x60;
  frame.data[3] = 0x75;
  frame.data[4] = 0x00;
  frame.data[5] = 0x30;
  frame.data[6] = 0x00;
  frame.data[7] = 0x80;
  twai_transmit_v2(twai_bus_0, &frame, 0);

  // 0x135 (Bus0) - ECMPRDNL: Transmission PRNDL gear position & ESP button
  frame.identifier = 0x135;
  frame.extd = 0;
  frame.rtr = 0;
  frame.data_length_code = 8;
  frame.data[0] = 0x02;
  frame.data[1] = 0x00;
  frame.data[2] = 0x1D;
  frame.data[3] = 0x00;
  frame.data[4] = 0x03;
  frame.data[5] = 0x1A;
  frame.data[6] = 0x00;
  frame.data[7] = 0x00;
  twai_transmit_v2(twai_bus_0, &frame, 0);

  // 0x4C1 - PPEI Engine General Status 4 (spec 500 ms), ECM TX
  frame.identifier = 0x4C1;
  frame.data_length_code = 8;
  frame.data[0] = 0x10;
  frame.data[1] = 0xC6;
  frame.data[2] = 0x5F;
  frame.data[3] = 0x3B;
  frame.data[4] = 0x60;
  frame.data[5] = 0x00;
  frame.data[6] = 0x00;
  frame.data[7] = 0x00;
  twai_transmit_v2(twai_bus_0, &frame, 0);
}

void Gen41_frames1000()
{
  twai_message_t frame = {};
  frame.extd = 0;
  frame.rtr = 0;
  const uint32_t now_ms = millis();

  // 0x4F1 (Bus0) — GMW8762 "PPEI Powertrain Configuration Data" (1000ms), ECM TX
  frame.identifier = 0x4F1;
  frame.extd = 0;
  frame.rtr = 0;
  frame.data_length_code = 8;
  static const uint16_t TYRE_CIRC_4F1_F = 420U;
  static const uint16_t TYRE_CIRC_4F1_R = 420U;
  frame.data[0] = static_cast<uint8_t>((TYRE_CIRC_4F1_F >> 8) & 0xFFU);
  frame.data[1] = static_cast<uint8_t>(TYRE_CIRC_4F1_F & 0xFFU);
  frame.data[2] = static_cast<uint8_t>((TYRE_CIRC_4F1_R >> 8) & 0xFFU);
  frame.data[3] = static_cast<uint8_t>(TYRE_CIRC_4F1_R & 0xFFU);
  frame.data[4] = 0x00;
  frame.data[5] = 0x00;
  frame.data[6] = 0x00;
  frame.data[7] = 0x00;
  twai_transmit_v2(twai_bus_0, &frame, 0);

  // 0x500 (Bus0) - GMLAN NM frame, ~2 s heartbeat
  {
    static uint32_t gen41_500_last_ms = 0U;
    if (gen41_periodic_due(gen41_500_last_ms, now_ms, 2000U, 2000U))
    {
      frame.identifier = 0x500;
      frame.extd = 0;
      frame.rtr = 0;
      frame.data_length_code = 4;
      frame.data[0] = 0x30;
      frame.data[1] = 0x30;
      frame.data[2] = 0x01;
      frame.data[3] = 0xF4;
      twai_transmit_v2(twai_bus_0, &frame, 0);
    }
  }
}

void Gen41_frames13()
{
  twai_message_t frame = {};
  frame.extd = 0;
  frame.rtr = 0;

  // 0x0F9 (Bus0) — GMW8762 "PPEI Transmission General Status 1" (12.5ms), TCM/ECM TX
  frame.identifier = 0x0F9;
  frame.extd = 0;
  frame.rtr = 0;
  frame.data_length_code = 8;
  frame.data[0] = 0x07;
  frame.data[1] = 0xF3;
  frame.data[2] = 0x00;
  frame.data[3] = 0x00;
  frame.data[4] = 0x00;
  frame.data[5] = 0x00;
  frame.data[6] = 0x00;
  frame.data[7] = 0x00;
  twai_transmit_v2(twai_bus_0, &frame, 0);

  // 0x180 (Bus1) - GM SAS, 10 ms cadence
  gen41_build_180(frame);
  standaloneTx(frame);

  gen41_swa_advance_wobble();
}

void Gen41_frames50()
{
  twai_message_t frame = {};
  frame.extd = 0;
  frame.rtr = 0;

  // 0x2C3 (Bus0) — GMW8762 "PPEI Engine Torque Status 3" (50ms), ECM TX
  frame.identifier = 0x2C3;
  frame.extd = 0;
  frame.rtr = 0;
  frame.data_length_code = 8;
  const uint8_t idx_2c3 = gen41_take_replay_index(gen41_2c3_state);
  const uint16_t speed_2c3 = gen41_2c3_wheel_speed_tbl[idx_2c3];
  gen41_last_wheel_speed_2c3 = speed_2c3;
  frame.data[0] = static_cast<uint8_t>((speed_2c3 >> 8) & 0xFFU);
  frame.data[1] = static_cast<uint8_t>(speed_2c3 & 0xFFU);
  frame.data[2] = static_cast<uint8_t>((speed_2c3 >> 8) & 0xFFU);
  frame.data[3] = static_cast<uint8_t>(speed_2c3 & 0xFFU);
  frame.data[4] = 0x00;
  frame.data[5] = 0x00;
  frame.data[6] = 0x00;
  frame.data[7] = 0x00;
  twai_transmit_v2(twai_bus_0, &frame, 0);
}

void Gen41_frames250()
{
  twai_message_t frame = {};
  frame.extd = 0;
  frame.rtr = 0;

  // 0x3F1 - PPEI Platform Engine Control Request (spec 250 ms), GW TX
  frame.identifier = 0x3F1;
  frame.extd = 0;
  frame.rtr = 0;
  frame.data_length_code = 8;
  frame.data[0] = 0x00;
  frame.data[1] = 0xC5;
  frame.data[2] = 0x7E;
  frame.data[3] = 0x08;
  frame.data[4] = 0x11;
  frame.data[5] = 0xFA;
  frame.data[6] = 0x0A;
  frame.data[7] = 0x60;
  twai_transmit_v2(twai_bus_0, &frame, 0);
}

// Measured frame roles (bench, Gen5 0CQ, standalone, V3 packing, CF 30, floor 0,
// one frame disabled at a time; control = 30.0% reported / 30.7% PWM / 3.88 A):
//   ESP_19  0x0B2  MANDATORY - off: 0% engagement, pump dead (0% PWM, 0.01 A)
//   Motor_11 0x0A7 MANDATORY - off: 0% engagement, pump dead (0% PWM, 0.01 A)
//   ESP_05  0x106  MANDATORY - off: 0% engagement, but pump still runs (17% PWM,
//                  1.6 A) - gates committing to/reporting lock, not actuation
//   ESP_14  0x08A  THE LIMITER - off: 98.6% engagement (peak 100) on a 30%
//                  request. BR_Vorg_*_Max is what caps delivered lock
//   Motor_12 0x0A8 no measurable effect at this operating point
//   ESP_02  0x101  no measurable effect at this operating point
//   ESP_21  0x0FD  no measurable effect at this operating point
// Command, pump duty and reported value track 1:1 in V3. Note "no effect" was
// only established at steady 30% on a bench - not during transitions or at speed.
// V11.00.0 (OEM code, documents/haldex-binaries/leaf_trace/spec_gen5_0cq.md):
// the roles above were measured with ESP_14 Min = 0, i.e. ESP_14 as a ceiling over
// the unit's own Motor_11 strategy - which is why Motor_11 looked mandatory. ESP_14
// now sends Min = Max = V (0..250), the 0CQ's "exact" mode: the clutch target is V
// itself and the Motor_11 strategy is not used. The 0CQ receives 18 frames
// (spec §3) and checks no CRC or counter on any of them; ESP_10, EPB_01, ESP_18,
// ESP_23, Parkhilfe_04, Gateway_72, Getriebe_14 and ESP_29 are not received at
// all, so their blocks are OFF in the standalone defaults (globals.cpp).
void Gen5_0CQ_frames10()
{
  twai_message_t frame = {};
  // MQB ESP_18 (0x135, DLC 8) - ESP minor broadcast. Fixed response, no changes.
  frame.identifier = ESP_18; // 0x135.  Fixed response, no changes
  frame.extd = 0;
  frame.rtr = 0;
  frame.data_length_code = 8;
  frame.data[0] = 0x00; // ESP_18_CHK / checksum (supposed to have CRC? doesn't affect)
  frame.data[1] = 0xC0; // ESP_18 BZ counter / status (always 0xC0, never changes)
  frame.data[2] = 0x00; // ESP_18 reserved (doesn't affect)
  frame.data[3] = 0x00; // ESP_18 reserved (doesn't affect)
  frame.data[4] = 0x00; // ESP_18 reserved (doesn't affect)
  frame.data[5] = 0x00; // ESP_18 reserved (doesn't affect)
  frame.data[6] = 0x00; // ESP_18 reserved (doesn't affect)
  frame.data[7] = 0x00; // ESP_18 reserved (doesn't affect)
  standaloneTx(frame);

  // MQB ESP_19 (0x0B2, DLC 8) - wheel speeds (ESP_VL/VR/HL/HR_Radgeschw_02,
  // LE, 0.0075 km/h/bit - see the real decode in OpenHaldexC6_can.cpp).
  // Wheel speed MUST keep changing or haldex slowly disengages - static
  // makes it fade over time and eventually stop. V11.00.0: the speeds no
  // longer follow the lock - the 0CQ's strategy and clutch-temperature model
  // read them (OEM code: spec_gen5_0cq D6), so they are always the gently
  // varying ~19-31 km/h that used to be sent at 100 % lock. See
  // fill_esp19_wheel_speeds().
  frame.identifier = ESP_19; // ESP_19 0x0b2
  frame.extd = 0;
  frame.rtr = 0;
  frame.data_length_code = 8;
  fill_esp19_wheel_speeds(frame.data);
  standaloneTx(frame);

  // MQB Getriebe_11 (0x0AD, DLC 8) - transmission ECU broadcast.
  // GE_MMom_Anf_02 (engine torque request), GE_MMom_Vorhalt_02 (anticipatory torque),
  // GE_Fahrstufe (selected gear), GE_Schalt_Sequenz (shift state), GE_Zielgang.
  // The 0CQ reads only b7 bits 4-7, the target gear (OEM code: spec_gen5_0cq §3):
  // 1-7 are used as gears; 0 becomes the unit's internal "no gear" code (0xFE).
  // (Motor_14's gear is only used when this frame is missing.)
  // V11 TODO (bench): try a real gear here (e.g. b7 = 0x20 = 2nd) and compare -
  // the spec cannot say what gear 0 does to the strategy (spec §5).
  frame.identifier = GETRIEBE_11; // 0x0AD
  frame.extd = 0;
  frame.rtr = 0;
  frame.data_length_code = 8;
  frame.data[0] = 0x00;                // GE_CHK_02 - checksum (the 0CQ checks no CRC - spec §1)
  frame.data[1] = GETRIEBE_11_counter; // GE_BZ_02 - rolling 4-bit counter (0x00>0x0F)
  frame.data[2] = 0x00;                // GE_MMom_Anf_02 (engine torque-intervention request) - Was 0xFE Torque intervention at the engine. Requests a short-term reduction or increase in torque from the ECU. This signal is only valid in combination with GE_MMom_Status (for MQB) or GE_MMom_Status_02 (for MLBevo).
  frame.data[3] = 0xFE;                // GE_MMom_Vorhalt_02 (Pre-control torque - anticipatory torque request)
  frame.data[4] = 0x00;                // GE_Fahrstufe (Actual gear/range selected: 5=P, 6=R, 7=N, 8=D, 9=S, 10=E, 13/14=T)
  frame.data[5] = 0x00;                // GE_Schalt_Sequenz (Shift sequence state: 0=idle, 1=shift in progress, etc.) - does not affect (>0x00)
  frame.data[6] = 0x00;                // GE_Kraftschluss / clutch lock-up (Power transmission status / clutch lock-up state) - does not affect (>0x00)
  frame.data[7] = 0x00;                // GE_Zielgang (b7 bits 4-7, target gear) = 0, see the TODO above

  frame.data[0] = calcChecksum(frame.data, ID_SEQ_0AD); // for 0x0AD

  GETRIEBE_11_counter++;
  if (GETRIEBE_11_counter > 0x0F)
  {
    GETRIEBE_11_counter = 0;
  }
  standaloneTx(frame);

  // MQB Motor_12 (0x0A8, DLC 8) - engine torque limits / RPM (Motor_12).
  // MO_Mom_neg_verfuegbar (max engine braking), Mom_Statisch_Limit (static limit),
  // Mom_Dynamisch_Limit (dynamic limit), MO_Drehzahl_01 (engine RPM).
  // The 0CQ reads only b6-b7 = engine speed (OEM code: spec_gen5_0cq §3).
  frame.identifier = MOTOR_12; // Motor_12 0x0A8
  frame.extd = 0;
  frame.rtr = 0;
  frame.data_length_code = 8;
  frame.data[0] = 0x00;             // MO_CHK_02 - checksum placeholder
  frame.data[1] = MOTOR_12_counter; // MO_BZ_02 - rolling counter (0x70>0x7F)
  frame.data[2] = 0x00;             // MO_Mom_neg_verfuegbar (Negative available torque / maximum engine braking) - not read by the 0CQ
  frame.data[3] = 0x00;             // Static torque limit - not read by the 0CQ
  frame.data[4] = 0x00;             // Dynamic torque limit - not read by the 0CQ
  frame.data[5] = 0x64;             // not read by the 0CQ
  // V11.00.0: b6-b7 are ONE 16-bit engine speed (MO_Drehzahl_01, 0.25 rpm per
  // step), not a quality bit + rpm. b7 used to follow the lock, so the rpm ran
  // from ~4 rpm at 0 % to ~16000 rpm at 100 % (spec D5). Now a steady 2000 rpm.
  frame.data[6] = 0x40; // engine speed low byte  (0x1F40 = 8000 x 0.25 = 2000 rpm)
  frame.data[7] = 0x1F; // engine speed high byte

  frame.data[0] = calcChecksum(frame.data, ID_SEQ_0A8); // for 0x0A8

  MOTOR_12_counter++;
  if (MOTOR_12_counter > 0x7F)
  {
    MOTOR_12_counter = 0x70;
  }
  standaloneTx(frame);

  // MQB Motor_11 (0x0A7, DLC 8) - engine torque demand/output broadcast.
  // V11.00.0 (OEM code, spec_gen5_0cq §2.1): the 0CQ reads only MO_Mom_Soll_Roh
  // (bits 12-21) and MO_Mom_Ist_Summe (bits 22-31), raw = Nm + 509, plus b7 bit 5.
  // That torque feeds its OWN strategy, which is ignored while ESP_14 sends
  // Min = Max (the exact request below), so Motor_11 can't fight the ESP_14 lever.
  // It still feeds the unit's clutch-load model, so it keeps a steady value.
  //
  // Two packings, selected by the user-facing "Fix Hunting" toggle (fixHunting):
  //   fixHunting == false (default): empirical V3 packing, b6/b7 now fixed at
  //                                  0xFA (they used to follow the lock).
  //                                  Confirmed working on 554C, 554D,
  //                                  554H, and 554K @ 100% lock.
  //   fixHunting == true            : DBC-correct bit-packed Soll_Roh/Ist/Solf
  //                                  with fixed BPK defaults. Required on 554K
  //                                  at partial lock (60/40, 70/30) where the
  //                                  V3 packing causes the controller to hunt.
  //
  // The previous auto-detect logic was removed because the engagement-crossing
  // heuristic falsely flagged 554D as hunting. Mode is now strictly user-set
  // and persisted to EEPROM.
  frame.identifier = MOTOR_11; // MOTOR_11 0x0A7
  frame.extd = 0;
  frame.rtr = 0;
  frame.data_length_code = 8;

  // Danger Zone rides on the BPK packing (raised torque ceiling), so it forces
  // that path for the cycles it is live even with Fix Hunting off.
  if (!fixHunting && !dangerZoneActive())
  {
    // ---- V3 packing (default, working on 554C/D/H and 554K@100%) ----
    frame.data[0] = 0x00;             // MO_CHK_01 - checksum (the 0CQ checks no CRC - spec §1)
    frame.data[1] = MOTOR_11_counter; // MO_BZ_01 - rolling counter (0x40..0x4F); high nibble = MO_Mom_Soll_Roh low bits
    frame.data[2] = 0xFA;             // MO_Mom_Soll_Roh / MO_Mom_Ist_Summe bits: Soll_Roh = 423 Nm, Ist = 494 Nm (spec D4)
    frame.data[3] = 0xFA;             // MO_Mom_Ist_Summe high bits (raw 0x3EB, below the 0x3FB "invalid" codes)
    frame.data[4] = 0x00;             // MO_Mom_Traegheit_Summe - not read by the 0CQ
    frame.data[5] = 0xFA;             // MO_Mom_Soll_gefiltert - not read by the 0CQ
    // b6/b7 only hold MO_Mom_Schub (never used by the 0CQ) and b7 bit 5
    // MO_Status_Normalbetrieb (fault-monitor enable only). They used to follow
    // the lock, flipping bit 61 with the lock value; the "massive effect" seen on
    // the bench came from ESP_14 changing in the same cycle (spec D3). V11.00.0:
    // fixed at the values that were sent at 100 % lock.
    frame.data[6] = 0xFA; // MO_Mom_Schub low bits (not used by the 0CQ)
    frame.data[7] = 0xFA; // MO_Mom_Schub high bits + b7.5 Normalbetrieb = 1
  }
  else
  {
    // ---- BPK packing (Fix Hunting toggle on, or Danger Zone live) ----
    // Shared with the normal-mode packer so the two can never drift, and so the
    // serial lab tunables apply identically in both. See fill_motor11_bpk().
    // The torque here still follows the lock (the "torque-style" lever), but the
    // 0CQ only uses it when ESP_14 is missing - ESP_14 below is what it follows.
    fill_motor11_bpk(frame.data, MOTOR_11_counter);
  }

  frame.data[0] = calcChecksum(frame.data, ID_SEQ_0A7); // for 0x0A7

  MOTOR_11_counter++;
  if (MOTOR_11_counter > 0x4F)
  {
    MOTOR_11_counter = 0x40;
  }

  standaloneTx(frame);
  /*
  0xd2,0x3d,0xcd,0x28,0x4c,0x14,0x22,0x4b,0x24,0xac,0xfa,0x55,0x66,0x80,0x0d,0x6c
  */

  // MQB ESP_14 (0x08A, DLC 8) - THE lock lever on the 0CQ.
  // BR_Vorg_Quer_Min/Max (b4/b5, front lock - not read by the 0CQ),
  // BR_Vorg_Allrad_Min/Max (b6/b7 - the only bytes the 0CQ reads, spec_gen5_0cq §2).
  // V11.00.0 (spec D1/D2): b6 = b7 = V, 0..250. Min = Max is the 0CQ's "exact"
  // mode: clutch target = V (0.4 % per step, same scale as Allrad_03 byte 2),
  // and its own Motor_11 strategy is ignored. V = 0 = clutch open. Never above
  // 250: 251+ means "no ESP request" and the unit runs its own strategy (that
  // is what happened at full lock with the old 0..0xFE scale). The Launch PWM
  // floor is not used here any more - Min is already pinned to Max. The unit's
  // own ramp, capacity limit and fault reactions still apply on top (spec §2.2).
  frame.identifier = ESP_14; // ESP_14 0x08A
  frame.extd = 0;
  frame.rtr = 0;
  frame.data_length_code = 8;
  frame.data[0] = 0x00;           // ESP_CHK_14 - checksum (the 0CQ checks no CRC - spec §1)
  frame.data[1] = ESP_14_counter; // ESP_BZ_14 - rolling counter (0x10>0x1F), not read by the 0CQ
  frame.data[2] = 0x00;           // not read by the 0CQ
  frame.data[3] = 0x00;           // BR_Status_Quer_ESP (VAQ only) - not read by the 0CQ

  appliedTorque = gen5_esp14_lever_byte(); // V, 0..250

  frame.data[4] = appliedTorque; // BR_Vorg_Quer_Min - not read by the 0CQ, mirrored
  frame.data[5] = appliedTorque; // BR_Vorg_Quer_Max - not read by the 0CQ, mirrored
  frame.data[6] = appliedTorque; // BR_Vorg_Allrad_Min = V (exact mode)
  frame.data[7] = appliedTorque; // BR_Vorg_Allrad_Max = V

  frame.data[0] = calcChecksum(frame.data, ID_SEQ_08A); // for 0x08A

  ESP_14_counter++;
  if (ESP_14_counter > 0x1F)
  {
    ESP_14_counter = 0x10;
  }
  standaloneTx(frame);

  /*
  0xd4,0xd4,0xd4,0xd4,0xd4,0xd4,0xd4,0xd4,0xd4,0xd4,0xd4,0xd4,0xd4,0xd4
  */

  // MQB LWI_01 (0x086, DLC 8) - steering-angle sensor (Lenkwinkelinformation).
  // LWI_Lenkradwinkel (steering wheel angle * 0.1 deg), LWI_Lenkradw_Geschw (rate * 5 deg/s),
  // LWI_Sensorstatus, plus quality bits.
  frame.identifier = LWI_01; // LWI_01 0x086
  frame.extd = 0;
  frame.rtr = 0;
  frame.data_length_code = 8;
  frame.data[0] = 0x00;           // LWI_CHK - checksum placeholder
  frame.data[1] = LWI_01_counter; // LWI_BZ - rolling counter (0x10>0x1F)
  // The 0CQ reads the steering angle from bits 16-28 (b2 + b3 bits 0-4, 0.1 deg
  // per step) and its sign from bit 29 (OEM code: spec_gen5_0cq §3). b2 is the
  // angle low byte, not a sensor status. V11.00.0: angle 0 (was 0x01 = 0.1 deg).
  frame.data[2] = 0x00;           // LWI_Lenkradwinkel low byte = 0 (straight ahead)
  frame.data[3] = 0x00;           // LWI_Lenkradwinkel high bits + sign (b3.5) = 0
  frame.data[4] = 0x00;           // not read by the 0CQ
  frame.data[5] = 0x00;           // not read by the 0CQ
  frame.data[6] = 0x00;           // LWI_Lenkradw_Geschw low (angular velocity, * 5 deg/s)
  frame.data[7] = 0x00;           // LWI_Lenkradw_Geschw high (Unit Degrees of Arc per Second)

  frame.data[0] = calcChecksum(frame.data, ID_SEQ_086); // for 0x086

  LWI_01_counter++;
  if (LWI_01_counter > 0x1F)
  {
    LWI_01_counter = 0x10;
  }

  standaloneTx(frame);
  /*
  0x86,0x86,0x86,0x86,0x86,0x86,0x86,0x86,0x86,0x86,0x86,0x86,0x86,0x86
  */
}

void Gen5_0CQ_frames20()
{
  twai_message_t frame = {};
  // MQB Motor_20 (0x121, DLC 8) - accelerator pedal raw/filtered + status.
  // MO_Accelerator_Raw_Value_01 (raw pedal), MO_Fahrpedal_Roh, MO_Pedal_Filt.
  frame.identifier = MOTOR_20;      // MOTOR_20 0x121
  frame.data_length_code = 8;       // DLC 8
  frame.data[0] = 0x00;             // MO_CHK_20 - checksum
  frame.data[1] = MOTOR_20_counter; // MO_BZ_20 - rolling counter (0x00>0x0F && MO_Accelerator_Raw_Value_01!)
  frame.data[2] = 0x40;             // MO_Accelerator_Raw_Value_01 (raw accelerator pedal value) (no affect MO_Accelerator_Raw_Value_01 sss)
  frame.data[3] = 0x40;             // MO_Fahrpedal_Roh (raw pedal position) (no affect sometimes 0xC0, sometimes 0x00)
  frame.data[4] = 0x19;             // MO_Pedal_Filt (filtered pedal) (no affect sometimes 0x3A, somtimes 0x39)
  frame.data[5] = 0x59;             // MO_Status_Pedal / kickdown flags (no affect)
  frame.data[6] = 0x7E;             // MO_Pedal status / driver-demand (no affect)
  frame.data[7] = 0xFE;             // MO_Pedal status (no affect)

  frame.data[0] = calcChecksum(frame.data, ID_SEQ_121); // for 0x121

  MOTOR_20_counter++;
  if (MOTOR_20_counter > 0x0F)
  {
    MOTOR_20_counter = 0x00;
  }

  standaloneTx(frame);
  /*
  0xe9,0x65,0xae,0x6b,0x7b,0x35,0xe5,0x5f,0x4e,0xc7,0x86,0xa2,0xbb,0xdd,0xeb,0xb4
  */

  // MQB ESP_10 (0x116, DLC 8) - lateral dynamics / yaw + lateral accel.
  // ESP_Gierrate (yaw), ESP_Querbeschleunigung (lateral acceleration), status bits.
  // V11.00.0: the 0CQ does NOT receive ESP_10 (OEM code: spec_gen5_0cq §1 RX table,
  // D9), so block 5 is OFF in the standalone defaults. The old "affects 40 %" note
  // below must have been something else changing at the same time.
  frame.identifier = ESP_10;                            // ESP_10 0x116
  frame.data_length_code = 8;                           // DLC 8
  frame.data[0] = 0x00;                                 // BR_CHK_10 - checksum
  frame.data[1] = ESP_10_counter;                       // BR_BZ_10 - rolling counter (0x00>0x0F)
  frame.data[2] = 0x01;                                 // ESP_QBit / status flags
  frame.data[3] = 0x04;                                 // ESP_Gierrate low (yaw rate)
  frame.data[4] = 0x00;                                 // ESP_Gierrate high
  frame.data[5] = 0x40;                                 // ESP_VZ_Gierrate (yaw sign)
  frame.data[6] = 0x00;                                 // ESP_Querbeschleunigung low (lateral G)
  frame.data[7] = 0xFF;                                 // ESP_Querbeschleunigung high (old note "affects 40 %" - not a 0CQ effect, see above)
  frame.data[0] = calcChecksum(frame.data, ID_SEQ_116); // for 0x116

  ESP_10_counter++;
  if (ESP_10_counter > 0x0F)
  {
    ESP_10_counter = 0x00;
  }

  standaloneTx(frame);
  /*
  0xac,0xac,0xac,0xac,0xac,0xac,0xac,0xac,0xac,0xac,0xac,0xac,0xac,0xac,0xac
  */

  // MQB ESP_05 (0x106, DLC 8) - brake pressure + brake-light/brake-pedal flags.
  // BR_Bremsdruck (master cylinder pressure), BR_Bremslicht (brake-light), BR_Bremspedal (pedal active).
  // The 0CQ reads the brake pressure, bits 16-25 (b2 + b3 bits 0-1), and sets an
  // internal "braking" flag above a threshold (OEM code: spec_gen5_0cq §3).
  frame.identifier = ESP_05;      // ESP_05 0x106
  frame.data_length_code = 8;     // DLC 8
  frame.data[0] = 0x00;           // BR_CHK_05 - checksum (worked out below)
  frame.data[1] = ESP_05_counter; // BR_BZ_05 - rolling counter (0x80>0x8F)
  frame.data[2] = 0x64;           // ESP_Bremsdruck low byte: raw 0x064 = 100 = 0 bar (K-matrix 0.3 bar/step, -30 bar offset) - not braking
  // b3: bits 0-1 = brake pressure high bits (0), bit 2 = ESP_Fahrer_bremst
  // (driver braking), bits 6-7 = 0xC0 as before. V11.00.0: bit 2 follows
  // brakeForHaldex() ("Follow Brake" + brake input wire or the car's CAN). The
  // 0CQ itself does not read bit 2 (spec §3) but the car's other modules do.
  frame.data[3] = 0xC0; // brake pressure high bits 0, not braking
  if (brakeForHaldex())
  {
    frame.data[3] = frame.data[3] | (1 << 2); // b3 bit 2 = ESP_Fahrer_bremst (driver is braking)
  }
  frame.data[4] = 0x00;                                 // not read by the 0CQ
  frame.data[5] = 0x00;                                 // not read by the 0CQ
  frame.data[6] = 0xFD;                                 // not read by the 0CQ
  frame.data[7] = 0x00;                                 // not read by the 0CQ (old bench note "affects on/off" was not a 0CQ effect)
  frame.data[0] = calcChecksum(frame.data, ID_SEQ_106); // CRC over the finished bytes (incl. the brake bit), like applyBrakeHandbrakeCANOverride does

  ESP_05_counter++;
  if (ESP_05_counter > 0x8F)
  {
    ESP_05_counter = 0x80;
  }

  standaloneTx(frame);
  /*
  0x07,0x07,0x07,0x07,0x07,0x07,0x07,0x07,0x07,0x07,0x07,0x07,0x07,0x07
  */

  // MQB EPB_01 (0x104, DLC 8) - electronic parking brake state.
  // Not received by the 0CQ (spec_gen5_0cq §1) - block 7 is OFF in the standalone defaults.
  frame.identifier = EPB_01;                            // EPB_01 0x104
  frame.data_length_code = 8;                           // DLC 8
  frame.data[0] = 0x00;                                 // EPB_CHK - checksum
  frame.data[1] = EPB_01_counter;                       // EPB_BZ - rolling counter (0x30>0x3F - none affect)
  frame.data[2] = 0xA6;                                 // EPB_Status (parking brake apply/release state)
  frame.data[3] = 0x00;                                 // EPB_Status reserved (sometimes 0xC0, sometimes 0x00)
  frame.data[4] = 0xE6;                                 // EPB_Status reserved (sometimes 0x3A, somtimes 0x39)
  frame.data[5] = 0x00;                                 // EPB_Status reserved
  frame.data[6] = 0x00;                                 // EPB_Status reserved
  frame.data[7] = 0x31;                                 // EPB_Status reserved
  frame.data[0] = calcChecksum(frame.data, ID_SEQ_104); // for 0x104

  EPB_01_counter++;
  if (EPB_01_counter > 0x3F)
  {
    EPB_01_counter = 0x30;
  }

  standaloneTx(frame);
  /*
  0x05,0x05,0x05,0x05,0x05,0x05,0x05,0x05,0x05,0x05,0x05,0x05,0x05,0x05
  */

  // MQB ESP_02 (0x101, DLC 8) - ESP brake/yaw status broadcast.
  // The 0CQ reads the lateral acceleration (b2) and the yaw rate (bits 40-53)
  // with its sign (bit 54) (OEM code: spec_gen5_0cq §3). V11.00.0: 0 g and no
  // yaw (was -0.01 g and 0.12 deg/s) - a car driving straight.
  frame.identifier = ESP_02;                            // ESP_02 0x101
  frame.data_length_code = 8;                           // DLC 8
  frame.data[0] = 0x00;                                 // BR_CHK_02 - checksum
  frame.data[1] = ESP_02_counter;                       // BR_BZ_02 - rolling counter (0x00>0x1F)
  frame.data[2] = 0x7F;                                 // ESP_Querbeschleunigung (0.01 g/step, -1.27 g offset): 0x7F = 0 g
  frame.data[3] = 0x0F;                                 // not read by the 0CQ
  frame.data[4] = 0x82;                                 // not read by the 0CQ
  frame.data[5] = 0x00;                                 // ESP_Gierrate low byte (0.01 deg/s per step) = 0
  frame.data[6] = 0x00;                                 // ESP_Gierrate high bits (b6 bits 0-5) = 0, ESP_VZ_Gierrate sign (b6 bit 6) = 0
  frame.data[7] = 0x00;                                 // not read by the 0CQ
  frame.data[0] = calcChecksum(frame.data, ID_SEQ_101); // for 0x101

  ESP_02_counter++;
  if (ESP_02_counter > 0x1F)
  {
    ESP_02_counter = 0x00;
  }

  standaloneTx(frame);
  /*
  0xaa,0xaa,0xaa,0xaa,0xaa,0xaa,0xaa,0xaa,0xaa,0xaa,0xaa,0xaa,0xaa
  */

  // MQB ESP_21 (0x0FD, DLC 8) - ESP wheel-speed/dynamics diagnostics.
  // The 0CQ reads only b7 bits 0, 1, 4, 5 = ABS_Bremsung, ASR_Anf, EDS_Eingriff,
  // ESP_Eingriff (OEM code: spec_gen5_0cq §3; K-matrix lists Allrad_Haldex as a
  // receiver). V11.00.0: ABS_Bremsung carries absBrakingForHaldex() (the car's ABS
  // module braking, from the chassis CAN); the other three stay 0 (no intervention).
  frame.identifier = ESP_21;      // ESP_21 0x0fd
  frame.data_length_code = 8;     // DLC 8
  frame.data[0] = 0x00;           // BR_CHK_21 - checksum (worked out below)
  frame.data[1] = ESP_21_counter; // BR_BZ_21 - rolling counter (0x00>0x1F)
  frame.data[2] = 0x1F;           // not read by the 0CQ
  frame.data[3] = 0x80;           // not read by the 0CQ
  frame.data[4] = 0x00;           // not read by the 0CQ
  frame.data[5] = 0x00;           // not read by the 0CQ
  frame.data[6] = 0x00;           // not read by the 0CQ
  frame.data[7] = 0x00;           // b7: no ABS / ASR / EDS / ESP intervention
  if (absBrakingForHaldex())
  {
    frame.data[7] = frame.data[7] | (1 << 0); // b7 bit 0 = ABS_Bremsung (ABS is braking)
  }
  frame.data[0] = calcChecksum(frame.data, ID_SEQ_0fd); // for 0x0fd (over the finished bytes)

  ESP_21_counter++;
  if (ESP_21_counter > 0x1F)
  {
    ESP_21_counter = 0x00;
  }

  standaloneTx(frame);

  /*
  0xb4,0xef,0xf8,0x49,0x1e,0xe5,0xc2,0xc0,0x97,0x19,0x3c,0xc9,0xf1,0x98,0xd6,0x61
  */
}

void Gen5_0CQ_frames25()
{
  twai_message_t frame = {};
  // MQB Kombi_01 (0x30B, DLC 8) - instrument cluster broadcast.
  // KBI_Kilometerstand (odometer), KBI_Geschw_Anzeige (displayed speed), warning lamps.
  // The 0CQ reads only b2 bit 7 = KBI_Handbremse (OEM code: spec_gen5_0cq §3,
  // and only while ESP_20 b1 bits 4-5 are not 3). V11.00.0: it carries
  // handbrakeForHaldex() ("Follow Handbrake" + wire or the car's CAN); 0 = released.
  frame.identifier = KOMBI_01; // kombi 1 0x30b
  frame.data_length_code = 8;  // DLC 8
  frame.data[0] = 0x10;        // KBI status / KBI_Geschw_Anzeige low (angle of turn (block 011) low byte)
  frame.data[1] = 0x20;        // KBI counter / KBI_Geschw_Anzeige high (checksum (0x20>0x2F))
  frame.data[2] = 0x02;        // b2: bit 7 KBI_Handbremse = 0 (released), rest 0x02 as before
  if (handbrakeForHaldex())
  {
    frame.data[2] = frame.data[2] | (1 << 7); // b2 bit 7 = KBI_Handbremse (handbrake pulled)
  }
  frame.data[3] = 0x00;        // KBI_Kilometerstand byte 1
  frame.data[4] = 0x0C;        // KBI_Kilometerstand byte 2
  frame.data[5] = 0x00;        // KBI status
  frame.data[6] = 0x00;        // KBI warning lamps
  frame.data[7] = 0x24;        // KBI status reserved
  standaloneTx(frame);
}

void Gen5_0CQ_frames100()
{
  twai_message_t frame = {};
  // MQB ESP_23 (0x5BE, DLC 8) - longitudinal/lateral acceleration, tyre data.
  // BR_Laengsbeschleunigung (longitudinal G), BR_Querbeschleunigung (lateral G), BR_Tire_Circumference.
  frame.identifier = ESP_23;                            // ESP_23 0x5be - this is fixed in Savvy but CHKS in Kmatrix?
  frame.data_length_code = 8;                           // DLC 8
  frame.data[0] = 0x00;                                 // BR_CHK_23 - checksum placeholder (no effect)
  frame.data[1] = ESP_23_counter;                       // BR_BZ_23 - rolling counter (no effect B high byte)
  frame.data[2] = 0xBF;                                 // BR_Laengsbeschleunigung low (longitudinal G) (no effect C)
  frame.data[3] = 0x7F;                                 // BR_Laengsbeschleunigung high (no effect D)
  frame.data[4] = 0x00;                                 // BR_Querbeschleunigung low (lateral G - rate of change (block 010))
  frame.data[5] = 0x00;                                 // BR_Querbeschleunigung high (rate of change (block 010))
  frame.data[6] = 0x7C;                                 // BR_Tire_Circumference / status (rate of change (block 010))
  frame.data[7] = 0x78;                                 // BR_Tire_Circumference / status (rate of change (block 010))
  frame.data[0] = calcChecksum(frame.data, ID_SEQ_5be); // for 0x5be

  ESP_23_counter++;
  if (ESP_23_counter > 0x1F)
  {
    ESP_23_counter = 0x00;
  }

  standaloneTx(frame);
  /*
    0xc9,0x21,0x6f,0x63,0xd2,0x42,0x6a,0x77,0x4a,0x3d,0xb0,0x62,0x9f,0x38,0xcd,0x5c
    */

  // MQB Parkhilfe_04 (0x54B, DLC 8) - park-assist module state broadcast.
  frame.identifier = Parkhilfe_04; // Parkhilfe_04 0x54B
  frame.data_length_code = 8;      // DLC 8
  frame.data[0] = 0x00;            // PH_Status low (angle of turn (block 011) low byte)
  frame.data[1] = 0x00;            // PH_Status high (no effect B high byte)
  frame.data[2] = 0x00;            // PH_Status reserved (no effect C)
  frame.data[3] = 0x00;            // PH_Status reserved (no effect D)
  frame.data[4] = 0x00;            // PH_Status reserved (rate of change (block 010))
  frame.data[5] = 0x00;            // PH_Status reserved (rate of change (block 010))
  frame.data[6] = 0x00;            // PH_Status reserved (rate of change (block 010))
  frame.data[7] = 0x24;            // PH_Status reserved (rate of change (block 010))
  standaloneTx(frame);

  // MQB Gateway_72 (0x3DB, DLC 8) - gateway routing/diagnostic broadcast.
  frame.identifier = GATEWAY_72; // gateway 72 0x3db
  frame.data_length_code = 8;    // DLC 8
  frame.data[0] = 0x50;          // GW_Status / routing flags
  frame.data[1] = 0x80;          // GW_Status
  frame.data[2] = 0x00;          // GW_Status reserved
  frame.data[3] = 0x00;          // GW_Status reserved
  frame.data[4] = 0x05;          // GW_Status reserved
  frame.data[5] = 0x10;          // GW_Status reserved
  frame.data[6] = 0x01;          // GW_Status reserved
  frame.data[7] = 0x78;          // GW_Status reserved
  standaloneTx(frame);

  // MQB Getriebe_14 (0x3C8, DLC 8) - transmission slow broadcast (Charisma, drag torque, launch).
  frame.identifier = GETRIEBE_14; // getriebe 14 0x3c8
  frame.data_length_code = 8;     // DLC 8
  frame.data[0] = 0x00;           // GE_Beschl_max (Maximum possible acceleration - limited by gear/clutch)
  frame.data[1] = 0x00;           // GE_Charisma_Fahrprogramm (Charisma drive programme selected - affects shift mapping)
  frame.data[2] = 0x54;           // GE_Charisma_Status (Charisma system status)
  frame.data[3] = 0x24;           // GE_M_Verlust (Drag/friction loss torque in transmission)
  frame.data[4] = 0x00;           // GE_Launch_Control (Launch control active)
  frame.data[5] = 0x60;           // GE_Status reserved
  frame.data[6] = 0x01;           // GE_Status reserved
  frame.data[7] = 0x51;           // GE_Status reserved
  standaloneTx(frame);

  // MQB Motor_14 (0x3BE, DLC 8) - start/stop subsystem state broadcast.
  // MO_StSt_Status (state machine), MO_StSt_Restart (restart event), MO_StSt_Stop (stop event).
  frame.identifier = MOTOR_14;                          // motor 14 0x3be
  frame.data_length_code = 8;                           // DLC 8
  frame.data[0] = 0x00;                                 // MO_CHK_14 - checksum
  frame.data[1] = MOTOR_14_counter;                     // MO_BZ_14 - rolling counter (0x10 to 0x1F)
  frame.data[2] = 0xE6;                                 // MO_StSt_Status (Start/stop system state - 0=inactive, 1=stopping, 2=stopped, 3=restarting) (doesn't effect)
  frame.data[3] = 0x01;                                 // MO_StSt_Restart (Restart event flag) (this affects(!) on/off)
  frame.data[4] = 0xC8;                                 // MO_StSt_Stop (Engine stop event flag) (doesn't effect)
  frame.data[5] = 0x80;                                 // MO_StSt status reserved (doesn't effect)
  frame.data[6] = 0x00;                                 // MO_StSt status reserved (doesn't effect)
  frame.data[7] = 0x80;                                 // MO_StSt status reserved (doesn't effect)
  frame.data[0] = calcChecksum(frame.data, ID_SEQ_3be); // for 0x3be

  MOTOR_14_counter++;
  if (MOTOR_14_counter > 0x1F)
  {
    MOTOR_14_counter = 0x10;
  }

  standaloneTx(frame);
  /*
  0x1f,0x28,0xc6,0x85,0xe6,0xf8,0xb0,0x19,0x5b,0x64,0x35,0x21,0xe4,0xf7,0x9c,0x24
  */

  // MQB ESP_07 (0x392, DLC 8) - ESP brake-event/intervention diagnostics.
  frame.identifier = ESP_07;                            // ESP_07 0x392
  frame.data_length_code = 8;                           // DLC 8
  frame.data[0] = 0x00;                                 // BR_CHK_07 - checksum
  frame.data[1] = ESP_07_counter;                       // BR_BZ_07 - rolling counter (0x20>0x2F)
  frame.data[2] = 0x00;                                 // ESP_07 status (one of these affects, find which one)
  frame.data[3] = 0x00;                                 // ESP_07 status (no effect)
  frame.data[4] = 0x00;                                 // ESP_07 status (no effect)
  frame.data[5] = 0x00;                                 // ESP_07 status (no efefct)
  frame.data[6] = 0x00;                                 // ESP_07 status (no effect)
  frame.data[7] = 0x00;                                 // ESP_07 status (no effect)
  frame.data[0] = calcChecksum(frame.data, ID_SEQ_392); // for 0x392

  ESP_07_counter++;
  if (ESP_07_counter > 0x2F) // V11.00.0: was "> 0x20 -> 0x2F", which ran backwards and stuck at 0x2F (spec_gen5_0cq D15; harmless, the 0CQ doesn't read it)
  {
    ESP_07_counter = 0x20; // counter runs 0x20..0x2F
  }
  standaloneTx(frame);
  /*
   0x91,0x91,0x91,0x91,0x91,0x91,0x91,0x91,0x91,0x91,0x91,0x91,0x91,0x91
   */

  // MQB ESP_29 (0x18C, DLC 8) - ESP slow-rate diagnostic broadcast.
  frame.identifier = ESP_29;  // esp_29 0x18c
  frame.data_length_code = 8; // DLC 8
  frame.data[0] = 0x00;       // BR_CHK_29 - checksum
  frame.data[1] = 0x20;       // BR_BZ_29 - counter (checksum (0x20>0x2F)?  Not in Savvy)
  frame.data[2] = 0x59;       // ESP_29 status
  frame.data[3] = 0x00;       // ESP_29 status
  frame.data[4] = 0x00;       // ESP_29 status
  frame.data[5] = 0x00;       // ESP_29 status
  frame.data[6] = 0x00;       // ESP_29 status
  frame.data[7] = 0x00;       // ESP_29 status
  standaloneTx(frame);
}

void Gen5_0CQ_frames200()
{
  twai_message_t frame = {};
  // PQ mKombi_2 (0x0C2, DLC 8) - electronic power steering / instrument-cluster slow.
  // Transmit currently disabled (commented out below).
  frame.identifier = mKombi_2; // electronic power steering 0x0C2
  frame.data_length_code = 8;  // DLC 8
  frame.data[0] = 0x4C;        // EPS status / steering torque (angle of turn (block 011) low byte)
  frame.data[1] = 0x86;        // EPS status (no effect B high byte)
  frame.data[2] = 0x85;        // EPS status (no effect C)
  frame.data[3] = 0x00;        // EPS status (no effect D)
  frame.data[4] = 0x00;        // EPS reserved (rate of change (block 010))
  frame.data[5] = 0x30;        // EPS reserved (rate of change (block 010))
  frame.data[6] = 0xFF;        // EPS reserved (rate of change (block 010))
  frame.data[7] = 0x04;        // EPS reserved (rate of change (block 010))
  // standaloneTx(frame);
}

void Gen5_0CQ_frames1000()
{
  twai_message_t frame = {};
  // MQB Motor_07 (0x640, DLC 8) - engine slow-rate diagnostics broadcast.
  frame.identifier = MOTOR_07; // motor 07, 1000ms
  frame.data_length_code = 8;  // DLC 8
  frame.data[0] = 0xA0;        // MO_07 diagnostic byte (no effect from any)
  frame.data[1] = 0x5A;        // MO_07 diagnostic byte
  frame.data[2] = 0x56;        // MO_07 diagnostic byte
  frame.data[3] = 0xA3;        // MO_07 diagnostic byte
  frame.data[4] = 0x80;        // MO_07 diagnostic byte
  frame.data[5] = 0xA0;        // MO_07 diagnostic byte
  frame.data[6] = 0x59;        // MO_07 diagnostic byte
  frame.data[7] = 0x01;        // MO_07 diagnostic byte
  standaloneTx(frame);

  frame.identifier = CHARISMA_01; // charisma_01 0x385
  frame.data_length_code = 8;     // DLC 8 no effect from any
  frame.data[0] = 0x00;           // CHA_Target_Driving_Program_AGA & CHA_Target_Driving_Prior_ESP
  frame.data[1] = 0x00;           // CHA_Target_Driving_Pri_Freewheel & void
  frame.data[2] = 0x22;           // CHA_Target_Driving_Program_MO & CHA_Target_Driving_Program_GE
  frame.data[3] = 0x02;           // CHA_Target_Driving_PR_ALR (inc. AWD) & CHA_Target_Driving_Program_MO_BZS
  frame.data[4] = 0x02;           // CHA_Target_Driving_Project_DR & CHA_Target_Driving_Prior_VAQ
  frame.data[5] = 0x20;           // CHA_Target_Driving_PR_AFS & CHA_Target_Driving_Program_RGS
  frame.data[6] = 0x02;           // CHA_Target_Driving_Price_EPS & CHA_Target_Driving_Principal_ACC
  frame.data[7] = 0x02;           // CHA_Target_Driving_Prior_SAK & CHA_Target_Driving_Program_MO_StSt
  standaloneTx(frame);

  // MQB Systeminfo_01 (0x585, DLC 8) - system identification/info broadcast.
  frame.identifier = SYSTEMINFO_01; // systeminfo_01 0x585
  frame.data_length_code = 8;       // DLC 8
  frame.data[0] = 0x84;             // SI status / system info
  frame.data[1] = 0x3C;             // SI info
  frame.data[2] = 0x00;             // SI info
  frame.data[3] = 0x7F;             // SI info
  frame.data[4] = 0x14;             // SI info
  frame.data[5] = 0x00;             // SI info
  frame.data[6] = 0x00;             // SI info
  frame.data[7] = 0x00;             // SI info
  standaloneTx(frame);

  // MQB Motor_Code_01 (0x641, DLC 8) - engine code / identification broadcast.
  // The 0CQ reads b1 bits 4-5 = MO_Faktor_Momente (1/2/3), which MULTIPLIES the
  // Motor_11 torque, and b4 bits 4-7 once at start-up (must not be 0) (OEM code:
  // spec_gen5_0cq §3). V11.00.0: the factor is now set on purpose (= 1) instead
  // of only being 1 because the counter happened to run 0x10..0x1F (spec D18),
  // and the duplicated header lines are gone (D16).
  frame.identifier = MOTOR_CODE_01; // motor_code_01 0x641
  frame.data_length_code = 8;       // DLC 8
  frame.data[0] = 0x00;             // MO_CHK_Code - checksum (worked out below)
  frame.data[1] = (1 << 4) | (MOTOR_CODE_01_counter & 0x0F); // b1 bits 0-3 rolling counter, bits 4-5 MO_Faktor_Momente = 1
  frame.data[2] = 0x2B;             // MO_Code byte (engine identification ASCII/code)
  frame.data[3] = 0x53;             // MO_Code byte
  frame.data[4] = 0x14;             // b4 bits 4-7 = 1 (not 0, read once at start-up by the 0CQ)
  frame.data[5] = 0x14;             // MO_Code byte
  frame.data[6] = 0xD7;             // MO_Code byte
  frame.data[7] = 0x24;             // MO_Code byte
  frame.data[0] = calcChecksum(frame.data, ID_SEQ_641); // V11.00.0: real CRC (was left 0). The 0CQ checks none, the car's other modules may

  MOTOR_CODE_01_counter++;
  if (MOTOR_CODE_01_counter > 0x1F)
  {
    MOTOR_CODE_01_counter = 0x10;
  }

  standaloneTx(frame);
  /*
  0x47,0x47,0x47,0x47,0x47,0x47,0x47,0x47,0x47,0x47,0x47,0x47,0x47,0x47,0x47
  */

  // MQB ESP_20 (0x65D, DLC 8) - ESP slow diagnostic broadcast incl. tyre circumference.
  frame.identifier = ESP_20;                            // esp_20 0x65d
  frame.data_length_code = 8;                           // DLC 8 no affect from any
  frame.data[0] = 0x00;                                 // BR_CHK_20 - checksum
  frame.data[1] = ESP_20_counter;                       // BR_BZ_20 - rolling counter (rolling (30>3F))
  frame.data[2] = 0x2B;                                 // ESP_20 status (no effect C)
  frame.data[3] = 0x10;                                 // ESP_20 status (no effect D)
  frame.data[4] = 0x00;                                 // ESP_20 status
  frame.data[5] = 0x00;                                 // ESP_20 status
  frame.data[6] = 0xE2;                                 // ESP_20 status
  frame.data[7] = 0x79;                                 // BR_Tire_Circumference (BR_Tire circumference)
  frame.data[0] = calcChecksum(frame.data, ID_SEQ_65d); // for 0x65d

  ESP_20_counter++;
  if (ESP_20_counter > 0x3F)
  {
    ESP_20_counter = 0x30;
  }

  standaloneTx(frame);
  /*
  0xac,0xb3,0xab,0xeb,0x7a,0xe1,0x3b,0xf7,0x73,0xba,0x7c,0x9e,0x06,0x5f,0x02,0xd9
  */

  // MQB Diagnose_01 (0x6B2, DLC 8) - generic diagnostic broadcast.
  frame.identifier = DIAGNOSE_01; // diagnose_01 0x6b2
  frame.data_length_code = 8;     // DLC 8
  frame.data[0] = 0x30;           // DG_Status
  frame.data[1] = 0x4D;           // DG_Status
  frame.data[2] = 0x58;           // DG_Status
  frame.data[3] = 0xA2;           // DG_Status
  frame.data[4] = 0x89;           // DG_Status
  frame.data[5] = 0x85;           // DG_Status
  frame.data[6] = 0x3F;           // DG_Status (0x3F OR 0xBF? (3F, then BF, then 3F, then BF...))
  frame.data[7] = 0x30;           // DG_Status (2D, then 2D, then 2E, then 2E, then 2F, then 2F... roll over? When?)
  standaloneTx(frame);

  // MQB Kombi_02 (0x6B7, DLC 8) - instrument cluster slow-rate broadcast.
  frame.identifier = KOMBI_02; // kombi2 0x6b7
  frame.data_length_code = 8;  // DLC 8
  frame.data[0] = 0x4D;        // KBI_02 status (no effect from any)
  frame.data[1] = 0x58;        // KBI_02 status
  frame.data[2] = 0xF2;        // KBI_02 status
  frame.data[3] = 0xEE;        // KBI_02 status
  frame.data[4] = 0x04;        // KBI_02 status
  frame.data[5] = 0x2B;        // KBI_02 status
  frame.data[6] = 0x00;        // KBI_02 status
  frame.data[7] = 0x78;        // KBI_02 status
  standaloneTx(frame);
}
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
