Forbes-Automotive/OpenHaldex-C6/(commit log)

2026-03-04 Replace legacy Arduino codebase with PlatformIO port - release v2.10.0
    [partitions_4mb.csv]
2026-07-08 V8.00.1
    Power saving, 0CQ/0AY additions. Fix hunting options.
    [OpenHaldexC6_API.cpp, OpenHaldexC6_Analyzer.cpp, OpenHaldexC6_Analyzer.h, OpenHaldexC6_Calculations.cpp, OpenHaldexC6_EEP.cpp, OpenHaldexC6_IO.cpp, OpenHaldexC6_OTA.cpp, OpenHaldexC6_StandaloneCAN.cpp]
2026-07-09 vehicle logs
    added vehicle specific logs split between PQ & MQB including scan tool connection sequence (for TP2.0 and UDS implementation).
    [0AY 554C - clear codes, oil temp, plate temp (heated), voltage (low).csv, 0AY 554C - oil pressure 27, 5, 4, est torque 2032, 464, 384, clutch valve (duty) 40, 21, 18 clutch valve (current) 1.910, 0.860, 0.81.csv, 0CQ 554C - module at 25 heated to 68.csv, 0CQ 554D - 30, 40, 100, pump voltsage, current duty.csv, 0CQ 554D - module at 27 heated to 73.csv, 0CQ.csv, 1K0 554A - clear codes, brake on,off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]
2026-07-29 Added embossed OpenHaldex-C6 text
    Can be printed as cut-through or as recessed. Multi-colour printers can choose different inset colour.
    [HaldexBoxC6_V1_Lid_CutThrough.STL, HaldexBoxC6_V1_Lid_Recessed.STL]
2026-10-05 Add Bluetooth LE for the DashCAN app (bigger OTA slots) + lock release fix (#44)
    * Web UI: make the lock release switch and rate actually save
    The Settings tab sends lockReleaseEnabled and lockReleaseRatePerSec through
    /api/settings, but settingsIncoming applied neither key, and settingsOutgoing
    did not report lockReleaseEnabled, so both controls had no effect beyond the
    page. Apply them (rate clamped to the slider's 5..500 %/s), report the switch,
    and include both keys in the backup lists of the web UI and the CLI tool.
    * OTA: bigger app slots, smaller LittleFS partition
    The BLE firmware (next commit) is about 1.70 MB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
    [partitions_4mb.csv]
2026-10-05 CLI: accept the old snake_case _fw_version key on import (#40)
    Backups made by the pre-merge version of this tool used _fw_version; the current tool only reads _fwVersion, so importing an old backup showed "backup from firmware unknown" instead of the real version. Cosmetic only - restore itself worked either way, verified with a real backup exported from 8.00.3 restoring cleanly onto a 9.00.0 device.
2026-10-05 OTA: add a Latest build channel for in-place rebuilds (#43)
    main is the live development branch and Releases/ is the stable-ish cut, so
    when a fix lands before the next version is cut it goes out by rebuilding the
    newest release folder in place, under the same version number. The updater
    compares version strings, so it reports "You are on the latest release" and
    offers nothing - there is no way to ask for that newer build short of a USB
    flash or Update from Files.
    Adds an Update channel selector to the Update from GitHub card:
    Stable - published releases (unchanged default)
    Latest build - also surfaces a rebuild of the version already installed
    Everything still comes from main;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
2026-10-07 v9.00.5 (#48)
    [partitions_4mb.csv]
2026-10-07 Stop Stock mode feeding engagement back as the lock command (#45)
    get_lock_target_adjustment() returned received_haldex_engagement for
    Stock (base mode, or a force trigger whose value is Stock). That value
    is a torque command: standalone packs it into every frame it builds,
    and the inline gateway packs it into edited chassis frames when a force
    trigger is active. Commanding whatever the Haldex reports closes a
    positive feedback loop - once the clutch reports high engagement, the
    controller asks for that much, and it stays latched until FWD or a
    power cycle.
    Stock now commands zero forced lock. A new get_forced_mode_value()
    returns the active force-mode value (or -1), and parseCAN_chs uses i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
2026-10-07 Make the default VAG correction factor match its comment (#47)
    The comment above the no-learn-table VAG branch gives the fit
    engagement = 2 * CF - 20, so CF = (target + 20) / 2, but the code
    computed target / 2 + 20, which is 10 CF points higher at every
    target. Change the code to match the comment.
    [OpenHaldexC6_Calculations.cpp]
2026-10-07 Normalize line endings to LF (#49)
    Files added through GitHub's web upload (v9.00.5, #48) were stored with
    CRLF line endings, bypassing the "* text=auto" rule in .gitattributes.
    That made every line of 23 source files differ from contributor branches,
    so PRs touching them (e.g. #46, OpenHaldexC6_IO.cpp) conflict on the
    whole file.
    Re-store them as LF. No content changes: the diff is empty with
    --ignore-cr-at-eol.
    [0AY 554C - clear codes, oil temp, plate temp (heated), voltage (low).csv, 0AY 554C - oil pressure 27, 5, 4, est torque 2032, 464, 384, clutch valve (duty) 40, 21, 18 clutch valve (current) 1.910, 0.860, 0.81.csv, 0CQ 554C - module at 25 heated to 68.csv, 0CQ 554D - 30, 40, 100, pump voltsage, current duty.csv, 0CQ 554D - module at 27 heated to 73.csv, 0CQ.csv, 1K0 554A - clear codes, brake on,off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]
2026-10-07 Zero latched CAN inputs when a bus goes silent (#46)
    parseCAN only overwrites speed, pedal, the ESP/hazard force flags, ABS
    validity and the reported engagement when a frame arrives. If the
    chassis or Haldex bus drops out, those values freeze at their last
    reading: the lock calculation keeps running on stale speed and
    throttle, and a stale hazard or ESP flag can hold a force mode on
    indefinitely.
    updateTriggers already decides bus health with the 1 s timeout. When it
    declares a bus dead (after having seen at least one frame), zero the
    inputs that bus feeds so the gates and triggers see "no input" rather
    than the last frame. Boot state, before any frame is seen, is left as
    it was.
2026-10-10 v9.00.6 (#50)
    DashCAN fix, heap fix
    [partitions_4mb.csv]
2026-10-10 Restart a stopped CAN controller and keep light sleep off while awake (#51)
    canBusRecovery() only restarted a STOPPED controller if it had put it
    into bus-off recovery itself. Nothing in the firmware stops a
    controller on purpose, so a controller that comes back stopped any
    other way (the TWAI domain is allowed to power down in light sleep via
    sleep_allow_pd) was left stopped: no frames to the Haldex while
    driving, and in non-aggressive low power no frames means the wake check
    never sees the car come back. Restart any STOPPED controller.
    Also hold an ESP_PM_NO_LIGHT_SLEEP lock while the module is awake when
    CAN sleep is enabled. updateTriggers releases it when the low-power
    state machine de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
2026-10-10 V9.00.6 (#52)
    * v9.00.6
    * Add files via upload
    * Update platform to pioarduino 55.03.312 and shrink AsyncTCP stack
    Platform 54.03.20 -> 55.03.312 (Arduino core 3.3.12 / IDF 5.5.5; needs
    PlatformIO Core >= 6.2.0). "Async TCP" added to lib_ignore so only
    mathieucarbou/AsyncTCP is linked, its task stack set to 8 KB to free
    internal heap for BLE, and the Freenove WS2812 lib dropped in favour of
    OneLed (include/OpenHaldexC6_led.h). Matches the V9.00.6 notes in
    OpenHaldexC6_ver.h.
    * Normalize line endings to LF again
    The v9.00.6 commits brought CRLF back into 44 text files after #49
    normalized the repo. Re-run the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
    [partitions_4mb.csv]
2026-10-29 Stop the 0x6B0 broadcast keeping the car's CAN bus awake (#56)
    broadcastOpenHaldex() sent 0x6B0 on the chassis bus every 200 ms
    unconditionally: the "Broadcast OpenHaldex over CAN" setting
    (broadcastOpenHaldexOverCAN) was only checked on the receive side.
    With the car locked, the drivetrain ECUs kept seeing traffic and
    stayed awake (seen on an Audi S1 gen 51: ~1,100-1,450 fps for hours
    with the Haldex itself asleep), which also kept the controller above
    its low-power threshold, so neither ever slept.
    Now it transmits only when the setting is on and the Haldex side has
    sent a frame within the last 5 s.
2026-10-29 OTA: check the safety gate once, not on every upload chunk (#57)
    The gate ran for every chunk of both uploads. Off the car it always
    passes (no CAN = bench mode), but in a car one flicker of a CAN-derived
    flag (speed, bus failure, temp) mid-upload aborted the firmware upload,
    and for the filesystem it hit fsUpdateFail(), which erases the
    partition: a phone OTA left the unit on the recovery page.
    Now the gate runs once, before anything is written. The firmware reboot
    is still gated: if the car is not safe when the upload finishes, the new
    image is already set to boot and starts at the next power-on instead.
2026-10-30 OTA: optional "Release source" so forks can offer a way back to official (#61)
    Ported onto V11's updater (its own updFitsThisLayout is kept as is).
    UPD_REPO / UPD_MIRRORS / UPD_DIR_API become updRepo() / updMirrors() /
    updDirApi(), driven by UPD_OFFICIAL and an optional UPD_FORK.
    With UPD_FORK = null (as here) there is one source, the selector stays
    hidden and nothing changes on screen. A fork that sets UPD_FORK gets a
    "Release source" choice on the OTA tab; picking the official source lists
    the newest official release that fits the unit's partitions as a
    "Switch to official" install, with its own confirmation text. The choice
    is kept in the browser only (localStorage).
    Originally part of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
2026-10-30 Add tools/can_capture.py: record and diff CAN traffic from a laptop (#60)
    Drives the controller's analyzer mode over GVRET (TCP 23) so a test can be
    recorded as labelled phases without SavvyCAN, then summarised: every ID on
    each bus (car side vs Haldex side), named from a PQ DBC plus the firmware's
    own OpenHaldexC6_canID.h, anything unaccounted for flagged, and a diff of what
    appears, disappears or changes state between phases.
    python3 tools/can_capture.py --host 192.168.1.1 capture armed --seconds 30
    python3 tools/can_capture.py --host 192.168.1.1 capture pin --seconds 30
    python3 tools/can_capture.py analyze --dbc vw_pq.dbc
    Analyzer mode forwards frames untouched, so capture turns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
2026-11-04 Add V3 enclosure print files for the C6
    Shell, ribbed shell for printing rim-down, base, button pin and optional mount
    clip, as shown in Images/enclosure-assembly.gif. The shell and clip are zipped
    because the STLs are too big to upload individually. The old V1 box files stay
    alongside them.
2026-11-07 Release V11.00.5 beta: Volvo Gen4 (P3), fault codes
    - Releases/V11.00.5: bootloader, partitions, firmware, littlefs + esp-web-tools manifest
    - releases.json: 11.00.5 on the beta channel (latest stable unchanged, 9.00.6)
    - README: Volvo P3 section (Standalone + OEM mode), Fault Codes section, Volvo P2 / P3
    Haldex temperature, corrected Volvo / chassis tables, current version line
